flyingyuya/Sonic-Speed-Parallelism/docs/设计报告/README.md

# 设计报告

| 文件 | 说明 |
|---|---|
| **`REPORT.md`** | **Markdown 版**（1212 行）—— 便于在线阅读与版本 diff |
| **`main.tex`** | **LaTeX 版**（基于 `cumcmthesis.cls`）|
| **`main.pdf`** | **编译产物**（21 页）|

## 编译

```bash
cd docs/设计报告
xelatex main.tex && xelatex main.tex    # 两遍，第二遍生成目录
```

**依赖**：`cumcmthesis.cls` / `mcmicm_styles.tex` / `algorithm2e.sty` /
`matlab-prettifier.sty`（模板自带）+ XeLaTeX + Noto CJK 字体。

## 章节

| 章 | 内容 | 对应竞赛要求 |
|---|---|---|
| 1 | 选题背景与创新点（含 5 个创新点）| ● 选题背景与创新点 |
| 2 | 设计原理与功能框图（含 TikZ 架构图）| ● 设计原理与功能框图 |
| 3 | 软硬件划分依据与接口设计 | ● 软硬件划分依据与接口设计 |
| 4 | 优化过程与性能资源对比（5 阶段 ⨯ 对比表）| ● 优化过程，含前后对比表 |
| 5 | 大模型协作记录（提示词 / 回答 / 纠错轨迹 / 工作流）| ● 大模型协作记录 |
| 6 | 技能包提炼过程（来源 / 验证 / 边界）| ● 技能包的提炼过程 |
| 7 | 复现说明（7 步从零执行 + 验收清单 + FAQ）| ● 复现说明 |
| 附录 A/B | 关键指标汇总 / 与商业方案对比 | —— |
