flyingyuya/Sonic-Speed-Parallelism/docs/11-fft-design.md

# 11 FFT 设计（1024 点实数，存储式）

> **目标读者：第一次做 FFT 硬件实现的人。**
> 本文从 DFT 的定义讲起，一路推到可以写 RTL 的程度。
> 具体端口契约见 [10-top-design.md](10-top-design.md) §4.8。

---

## 1. 先破除一个误解：1024 点不会比 8 点长

网上大多数 FFT 教程（包括常见的 8 点 FFT 博客）写的是**全并行 / 流水线式**：
把每一级的蝶形单元全部"摆"出来，用 `generate` 批量例化。
那种写法下代码量随 N 爆炸。

**但 FFT 有另一种实现风格：存储式（memory-based / 时分复用）。**

| | 全并行 / 流水线式 | **存储式（本项目用）** |
| --- | --- | --- |
| 蝶形单元数 | `N/2 × log₂N` | **1 个** |
| 8 点需要 | 12 个蝶形 | **1 个** |
| 1024 点需要 | **5120 个蝶形** 😱 | **1 个** |
| 代码量 | 随 N 爆炸（必须 generate） | **几乎与 N 无关** |
| 每帧耗时 | N 拍 | `N/2 × log₂N` 拍 |
| 适用场景 | 极高吞吐（雷达 / 高速采集） | **低速场合（音频）** |

### 1.1 为什么我们能选存储式

```
输入采样率 48 kHz  @ clk_sys = 48 MHz  →  每 1000 个 clk 来一个样本
一帧 1024 点                            →  1,024,000 clk

存储式 FFT 需要：5120 蝶形 × ~4 clk     =  20,480 clk
                                        →  只占 1,024,000 的 2%
```

**只用 2% 的时间，没有任何理由把它并行化。**

> **结论：不需要 `generate`。一个蝶形单元就够了。**

### 1.2 这个余量是"结构性"的，不是刚好够

```
FFT 蝶形数      = (N/2) × log₂N
每个蝶形 4 clk  →  FFT 时间 = 2N·log₂N clk
帧长            = N × (clk_freq / fs) = N × 1000 clk
                                            ────────────────────────
占用率 = 2N·log₂N / (1000N) = log₂N / 500
```

**注意 `N` 被约掉了！**

| 点数 | log₂N | FFT 占用率 |
| --- | --- | --- |
| 1024 | 10 | **2.0%** |
| 2048 | 11 | 2.2% |
| 4096 | 12 | 2.4% |
| 16384 | 14 | 2.8% |

**点数翻 16 倍，占用率只从 2.0% 涨到 2.8%。**
所以以后想升级到 2048/4096 点，硬件只多几个 BRAM，时间上毫无压力
（真正要权衡的是帧延迟：2048 点 = 42.7 ms，频谱刷新会变慢）。

### 1.3 什么时候会不够

```
需要：2·log₂N clk 占满一个样本间隔
样本间隔 = clk_freq / fs
```

| 采样率 | 时钟 | 每样本 clk | FFT 需要 | 占用率 |
| --- | --- | --- | --- | --- |
| 48 kHz | 48 MHz | 1000 | 20 | **2%** ✅ |
| 192 kHz | 48 MHz | 250 | 20 | 8% ✅ |
| 1 MHz | 48 MHz | 48 | 20 | **42%** ⚠️ 开始紧张 |
| 1 MHz | 200 MHz | 200 | 20 | 10% ✅ |

音频范围内（≤192 kHz）绝对安全。

---

## 2. 蝶形结构详解（从 DFT 讲起）

### 2.1 DFT 在算什么

```
X[k] = Σ(n=0..N-1) x[n] · W_N^(nk)          k = 0 .. N-1
```

N=8 时展开：

```
X[0] = x[0]W⁰ + x[1]W⁰ + x[2]W⁰ + ... + x[7]W⁰
X[1] = x[0]W⁰ + x[1]W¹ + x[2]W² + ... + x[7]W⁷
X[2] = x[0]W⁰ + x[1]W² + x[2]W⁴ + ... + x[7]W¹⁴
...
```

**8 个输出 × 每个 8 项 = 64 次复数乘法。** N=1024 就是 100 万次。

FFT 要把它降到 `(N/2)·log₂N = 8×3 = 24` 次（N=1024 时是 5120 次）。

### 2.2 FFT 的核心思想：把输入拆成两半

把 `x[n]` 按**下标奇偶**拆开（这叫「按时域抽取」，DIT）：

```
X[k] = Σ x[n]W^(nk)
     = Σ_{n为偶数} x[n]W^(nk)  +  Σ_{n为奇数} x[n]W^(nk)

令 n = 2m（偶数项）和 n = 2m+1（奇数项），m = 0..N/2-1：

     = Σ_m x[2m]·W^(2mk)  +  Σ_m x[2m+1]·W^((2m+1)k)
```

**关键一步**：注意 `W_N^(2mk) = (W_N²)^(mk) = W_{N/2}^(mk)`

也就是说：偶数项的 `W^(2mk)` 正好是「N/2 点 DFT 的旋转因子」！

```
X[k] = E[k] + W_N^k · O[k]

其中 E[k] = N/2 点 DFT{ x[0], x[2], x[4], x[6] }      ← 偶数项
     O[k] = N/2 点 DFT{ x[1], x[3], x[5], x[7] }      ← 奇数项
```

**原来 8 点 DFT 变成了两个 4 点 DFT + 一点收尾工作。**

再用周期性 `E[k+N/2] = E[k]`、`O[k+N/2] = O[k]`：

```
X[k]     = E[k] + W^k · O[k]        k = 0 .. N/2-1
X[k+N/2] = E[k] - W^k · O[k]        ← 符号变减号
```

**这就是全部的秘密。** 一次复数乘 `W^k·O[k]` 同时算出两个输出。

### 2.3 蝶形单元 —— 名字的来历

上面两行画成图：

```
              ┌────────────────────●────── a + W·b
              │                    │
   a ─────────┤                    │
              │                    │
   b ─[×W]────┼────────────────────●────── a - W·b
```

**两根线进、两根线出，中间交叉 —— 形状像蝴蝶，所以叫「蝶形」。**

Verilog 写出来：

```verilog
t    = W * b;          // 唯一的复数乘法
out_a = a + t;         // 加
out_b = a - t;         // 减（省了一次乘法！）
```

> **这才是 FFT 快的地方**：一次乘法喂饱两个输出。
> 直接算 DFT 要 64 次乘法，蝶形网络只要 24 次。

### 2.4 8 点完整流程（三级）

把拆分**递归下去**：

```
8 点 ──▶ 两个 4 点 ──▶ 四个 2 点 ──▶ 八个 1 点（1 点 DFT 就是它自己）
```

一共 **log₂8 = 3 级**，每级 **N/2 = 4 个蝶形**，总共 12 个蝶形。

#### 输入顺序：位反转

拆分时偶数项在前、奇数项在后，再递归下去，最终地址 `a` 存的是样本 `bitrev(a)`：

```
地址 a :   0     1     2     3     4     5     6     7
内容   : x[0]  x[4]  x[2]  x[6]  x[1]  x[5]  x[3]  x[7]
```

**验证**：地址 1 存 x[4]，`bitrev(1) = 100b = 4` ✓

#### 三级蝶形的配对（按**内存地址**）

**第 0 级（half=1，地址相邻配对）**

| cnt | p | q | 旋转因子 | 实际取到的样本 |
| --- | --- | --- | --- | --- |
| 0 | 0 | 1 | `W⁰` | x[0], x[4] |
| 1 | 2 | 3 | `W⁰` | x[2], x[6] |
| 2 | 4 | 5 | `W⁰` | x[1], x[5] |
| 3 | 6 | 7 | `W⁰` | x[3], x[7] |

**第 1 级（half=2）**

| cnt | p | q | 旋转因子 | 实际取到的样本 |
| --- | --- | --- | --- | --- |
| 0 | 0 | 2 | `W⁰` | — |
| 1 | 1 | 3 | `W²` | — |
| 2 | 4 | 6 | `W⁰` | — |
| 3 | 5 | 7 | `W²` | — |

**第 2 级（half=4）**

| cnt | p | q | 旋转因子 | 实际取到的样本 |
| --- | --- | --- | --- | --- |
| 0 | 0 | 4 | `W⁰` | — |
| 1 | 1 | 5 | `W¹` | — |
| 2 | 2 | 6 | `W²` | — |
| 3 | 3 | 7 | `W³` | — |

**输出就是自然顺序 X[0]..X[7]** ✓

#### 两个规律

```
① 间距 half 每级翻倍：  1 → 2 → 4 → ...
② 每级内部配对是"周期性"的：
   第 0 级：4 组，每组 1 个蝶形，组内偏移 j 恒为 0
   第 1 级：2 组，每组 2 个蝶形，j = 0,1
   第 2 级：1 组，每组 4 个蝶形，j = 0,1,2,3
```

### 2.5 一个具体的数值例子

设 `x = [1, 0, 0, 0, 0, 0, 0, 0]`（单位冲激）。
冲激的 DFT 是**全 1**，所以正确答案已知。

**写进内存（位反转地址）**：x[0]=1 写到地址 0，其余为 0

```
地址:   0  1  2  3  4  5  6  7
内容:  [1, 0, 0, 0, 0, 0, 0, 0]
```

**第 0 级**（4 个蝶形，W⁰=1）：

```
(0,1): a=1, b=0 → t=0 → out: 1, 1
(2,3): a=0, b=0 → t=0 → out: 0, 0
(4,5): a=0, b=0 → t=0 → out: 0, 0
(6,7): a=0, b=0 → t=0 → out: 0, 0

内存: [1, 1, 0, 0, 0, 0, 0, 0]
```

**第 1 级**：

```
(0,2): a=1, b=0, W⁰ → out: 1, 1
(1,3): a=1, b=0, W² → out: 1, 1
(4,6): a=0, b=0, W⁰ → out: 0, 0
(5,7): a=0, b=0, W² → out: 0, 0

内存: [1, 1, 1, 1, 0, 0, 0, 0]
```

**第 2 级**：

```
(0,4): out: 1, 1
(1,5): out: 1, 1
(2,6): out: 1, 1
(3,7): out: 1, 1

内存: [1, 1, 1, 1, 1, 1, 1, 1]   ← X[k] 全 1 ✓
```

**几何直觉**：每一级都是「把已有的一坨复制一份、散开一点」。

#### 再看一个有旋转因子的蝶形

第 2 级、`cnt=1` 的蝶形 `(p=1, q=5)`，旋转因子 `W¹ = e^(-jπ/4) = 0.7071 - 0.7071j`。
假设此刻 `a = 2`（实数），`b = 1`（实数）：

```
t = W¹ · b = 0.7071 - 0.7071j

out_a = a + t = 2.7071 - 0.7071j
out_b = a - t = 1.2929 + 0.7071j
```

**旋转因子的作用就是"把 b 转个角度再缩放"**，然后加/减到 a 上。

### 2.6 用 Python 验证你的理解

**写 RTL 之前先跑这个**，跑通了说明结构彻底懂了，之后就是纯翻译工作：

```python
import numpy as np

N = 8
x = np.arange(N, dtype=complex)         # 随便给个输入

LOG2N = 3
# ---- 按位反转写内存 ----
mem = np.zeros(N, dtype=complex)
for n in range(N):
    a = int(format(n, f'0{LOG2N}b')[::-1], 2)
    mem[a] = x[n]
print("写入后的内存:", mem)

# ---- 逐级蝶形 ----
for s in range(LOG2N):
    half = 1 << s
    new = mem.copy()
    for cnt in range(N // 2):
        group = cnt // half
        j     = cnt %  half
        p = group * 2 * half + j
        q = p + half
        W = np.exp(-2j * np.pi * (j * (N // (2*half))) / N)
        t = W * mem[q]
        new[p] = mem[p] + t
        new[q] = mem[p] - t
    mem = new
    print(f"第 {s} 级后:", np.round(mem, 4))

print("numpy 结果 :", np.round(np.fft.fft(x), 4))
print("是否一致   :", np.allclose(mem, np.fft.fft(x)))
```

**这段代码就是以后 `fft_core` 的 Python 黄金模型的基础，保存下来。**

---

## 3. DIT vs DIF：两种对称的画法

FFT 有两种对称的分解方式，**图长得像但不一样**，看博客时容易搞混：

| | **DIT**（时域抽取，我们用的） | **DIF**（频域抽取） |
| --- | --- | --- |
| 输入顺序 | **位反转** | 自然顺序 |
| 输出顺序 | **自然顺序** | 位反转 |
| 第 0 级配对（地址） | `(0,1)(2,3)(4,5)(6,7)` | `(0,4)(1,5)(2,6)(3,7)` |
| 第 0 级旋转因子 | **全是 W⁰**（没有乘法！） | `W⁰ W¹ W² W³` |
| 最后一级旋转因子 | 全套 `W⁰..W^(N/2-1)` | 只有 `W⁰` |
| 蝶形形状 | 先乘再加/减 | 先加/减再乘 |

**两种图的第一级都可能出现「x(0) 和 x(4)」**：
- 如果是 DIT：因为左列第 1 行标的是 x(4)（位反转顺序）
- 如果是 DIF：因为左列是自然顺序，蝶形确实跨 N/2

### 怎么一眼分辨

```
第 0 级全是 W⁰（图上没有 ×W 标记）  →  DIT
第 0 级就有 ×W⁰ ×W¹ ×W² ×W³        →  DIF
```

### 我们为什么选 DIT

| | DIT | DIF |
| --- | --- | --- |
| 位反转放在哪 | **写地址**（免费：10 根线交叉） | 读地址 |
| 输出顺序 | **自然**（地址 0..511 就是 bin 0..511） | 位反转（要再排一次） |
| 加窗 | 写的时候顺手乘窗系数（按自然下标 n 索引窗 ROM） | 也一样 |

**DIT 让"输出自然顺序"和"写地址位反转"两件事都变简单。**
如果选 DIF，算幅度谱时就得按 `bitrev(k)` 去读 BRAM，频谱显示还得再排一遍 —— 白费功夫。

---

## 4. 地址发生器（核心）

### 4.1 直觉版本

```
第 s 级，间距 half = 2^s

蝶形编号 cnt 从 0 数到 N/2-1。把 cnt 拆成：
    ┌──────────────┬─────────┐
    │  组号 group   │ 组内偏移 j │
    └──────────────┴─────────┘
     高 (LOG2N-1-s) 位     低 s 位

第 group 组的蝴蝶对，起点 = group × 2×half
    p = group × 2×half + j
    q = p + half
```

用 N=8 验证（第 1 级，s=1, half=2）：

| cnt | 二进制 | group | j | p = group×4 + j | q = p+2 |
| --- | --- | --- | --- | --- | --- |
| 0 | `0` `0` | 0 | 0 | 0 | 2 |
| 1 | `0` `1` | 0 | 1 | 1 | 3 |
| 2 | `1` `0` | 1 | 0 | 4 | 6 |
| 3 | `1` `1` | 1 | 1 | 5 | 7 |

和 §2.4 的表完全一致 ✓

### 4.2 关键化简：「插 0 / 插 1」

把上面的公式翻译成**位操作**：

```
cnt   的布局:   [ 高 (LOG2N-1-s) 位 ][ 低 s 位 ]
                     ↓ 左移 1           ↓ 不变
p     的布局:   [ 高 (LOG2N-1-s) 位 ][0][ 低 s 位 ]
                                      ↑
                                 在第 s 位插入一个 0

q = p 的第 s 位置成 1
```

**逐项验证**：

| s | cnt | 推导 | p | q |
| --- | --- | --- | --- | --- |
| 0 | `11` | 低 0 位（空），第 0 位插 0，高位左移 | `110`=6 | `111`=7 |
| 1 | `01` | 低 1 位=`1`，第 1 位插 0，高位 `0` 左移→`0` | `001`=1 | `011`=3 |
| 2 | `01` | 低 2 位=`01`，第 2 位插 0，高位（空） | `001`=1 | `101`=5 |

**全部吻合。**

#### 为什么这个结论重要

它把「地址计算」从**除法取模**变成**位移和位或**：

```
除法取模版（硬件上要除法器，几十个 LUT/周期）：
    group = cnt / half
    j     = cnt % half
    p     = group * 2 * half + j

插 0 版（只要移位器和位或）：
    p = ((cnt >> s) << (s+1)) | (cnt & ((1<<s)-1))
    q = p | (1 << s)
```

**同样的结果，硬件代价差了几十倍。**

### 4.3 ⚠️ 地址 vs 样本下标（最容易混的地方）

这是**初学者最常卡住的一点**，单独强调。

```
样本下标 n :  x[0]  x[1]  x[2]  x[3]  x[4]  x[5]  x[6]  x[7]
              ↑ "第几个采样点"，由 ADC 时间顺序决定

内存地址 a :   0     1     2     3     4     5     6     7
              ↑ "存在 BRAM 的第几格"，由我们的写地址决定
```

**位反转就是把两者错位对应**：

```
写：  bram[ bitrev(n) ] <= x[n]

地址 a :   0     1     2     3     4     5     6     7
内容   : x[0]  x[4]  x[2]  x[6]  x[1]  x[5]  x[3]  x[7]
```

于是：

| §2.4/§4 的表（按**地址**） | 博客的图（按**样本名**） | 是同一件事吗 |
| --- | --- | --- |
| 蝶形 (地址 0, 地址 1) | x(0) 和 x(4) | ✅ 因为地址 1 存的是 x[4] |
| 蝶形 (地址 2, 地址 3) | x(2) 和 x(6) | ✅ |
| 蝶形 (地址 4, 地址 5) | x(1) 和 x(5) | ✅ |
| 蝶形 (地址 6, 地址 7) | x(3) 和 x(7) | ✅ |

> **「地址相邻」≠「样本相邻」。**
> 地址 0 和 1 相邻，但它们装的样本是 x[0] 和 x[4]，隔了 4 个。
>
> **这正是位反转的目的**：让「地址上相邻的两个格子」恰好装着「蝶形需要配对的那两个样本」，
> 于是地址生成退化成简单的位操作。

**一句话**：本文按「地址」写，博客按「样本名」标，说的是一回事。

### 4.4 Verilog 实现

```verilog
// s = 当前级数 0..LOG2N-1，cnt = 0..N/2-1
wire [LOG2N-1:0] cnt_x   = {1'b0, cnt};                      // 先扩位
wire [LOG2N-1:0] lo_mask = ({{(LOG2N-1){1'b0}},1'b1} << s) - 1'b1;

wire [LOG2N-1:0] p = ((cnt_x >> s) << (s + 1)) | (cnt_x & lo_mask);   // 插 0
wire [LOG2N-1:0] q = p | ({{(LOG2N-1){1'b0}},1'b1} << s);             // 插 1

// 旋转因子索引 = j × N/(2·half) = j << (LOG2N-1-s)
wire [LOG2N-2:0] tw_idx = (cnt & lo_mask[LOG2N-2:0]) << (LOG2N - 1 - s);
```

可变移位（`<<` 的右操作数是变量）综合器会自动生成**桶形移位器**。
**整个地址发生器不到 10 行。**

### 4.5 手工验算（N=8）

N=8，LOG2N=3，N/2=4，cnt = 0..3。

| s | half | cnt | j | p | q | tw_idx |
| --- | --- | --- | --- | --- | --- | --- |
| 0 | 1 | 0 | 0 | 000 | 001 | 0 |
| 0 | 1 | 1 | 0 | 010 | 011 | 0 |
| 0 | 1 | 2 | 0 | 100 | 101 | 0 |
| 0 | 1 | 3 | 0 | 110 | 111 | 0 |
| 1 | 2 | 0 | 0 | 000 | 010 | 0 |
| 1 | 2 | 1 | 1 | 001 | 011 | 2 |
| 1 | 2 | 2 | 0 | 100 | 110 | 0 |
| 1 | 2 | 3 | 1 | 101 | 111 | 2 |
| 2 | 4 | 0 | 0 | 000 | 100 | 0 |
| 2 | 4 | 1 | 1 | 001 | 101 | 1 |
| 2 | 4 | 2 | 2 | 010 | 110 | 2 |
| 2 | 4 | 3 | 3 | 011 | 111 | 3 |

对照 §2.4 的三级表 —— **完全一致** ✓

### 4.6 旋转因子索引的来历

回到 §2.2 的公式：`X[k] = E[k] + W_N^k · O[k]`，用的是 **N 点**旋转因子。
递归到 N/2 点时用 N/2 点的旋转因子，那个在上层已经用过……

**结论（可以直接记）**：第 s 级、组内偏移为 j 的蝶形，用的旋转因子是：

```
tw = W_N^(j · N/(2·half)) = W_N^(j · 2^(LOG2N-1-s))
```

即 **`tw_idx = j << (LOG2N-1-s)`**

| s | half | j 范围 | 移位量 LOG2N-1-s | tw_idx |
| --- | --- | --- | --- | --- |
| 0 | 1 | 0 | 2 | 0 |
| 1 | 2 | 0,1 | 1 | 0, 2 |
| 2 | 4 | 0..3 | 0 | 0,1,2,3 |

对照 §2.4 —— 完全一致 ✓

**直觉解释**：每往下一级，旋转因子的「步进」减半，
这就是移位量 `LOG2N-1-s` 的来历。

---

## 5. 旋转因子 ROM

### 5.1 数值

```
W_N^k = cos(2πk/N) − j·sin(2πk/N)      k = 0 .. N/2−1 = 0 .. 511
```

只存 **512 项**，因为 `W^(k+N/2) = −W^k`（后半圈在蝶形里取负）。

### 5.2 生成脚本

见 `scripts/golden/gen_fft_twiddle.py`，产物 `rtl/fft/fft_twiddle_rom.v`。

格式：Q1.15，字宽 32bit = `{imag[15:0], real[15:0]}`。

```python
for k in range(512):
    ang = 2*math.pi*k/N
    re = quant(math.cos(ang))          # Q1.15
    im = quant(-math.sin(ang))         # ← 负号！正变换是 e^{-j...}
    word = (im & 0xFFFF) << 16 | (re & 0xFFFF)
```

**两个坑**：

| 坑 | 说明 |
| --- | --- |
| **`-sin` 写成 `+sin`** | 等于做了共轭，频谱会整体镜像翻转。症状：1 kHz 正弦的峰值跑到 bin 1003 而不是 bin 21 |
| **k=0 不钳位** | `cos(0)=1.0` 量化后是 **32768**，超出 Q1.15 上限 32767，会回绕成负数 |

### 5.3 已验证结果

| 检查项 | 结果 |
| --- | --- |
| 幅度 `abs(re²+im²-2³⁰)/2³⁰` | 最大 6.1e-05 |
| 关键点（k=0/64/128/256） | 与手算一致 |
| 共轭对称性 | 通过 |
| **独立交叉验证**（用量化表跑直接 DFT vs `numpy.fft`） | 全谱最大误差 **2.9e-06** |
| Vivado 综合 | **195 LUT / 0 BRAM**，零告警 |

> **独立验证的方法值得记住**：不要用 `cos/sin` 公式去"验证"用 `cos/sin` 生成的表（循环论证）。
> 而是把量化后的值当成真表，用它做一次 O(N²) 直接 DFT，再和 `numpy.fft` 比 ——
> **两条完全不同的算法路径**。

### 5.4 综合结果是 LUT ROM 而不是 BRAM

**195 LUT / 0 BRAM** —— Vivado 把它实现成**分布式 LUT ROM**（组合读取、零延迟）。

⚠️ **这是一个需要留意的点**：查找延迟要算进时序路径。
第 3 步做蝶形单元时，如果发现「ROM 查找 + 复数乘法」这条路径太长，
可以给 ROM 输出加一级寄存器 —— **看综合报告再决定**。

### 5.5 可选优化（先不做）

利用 `W^(N/2-k) = -j·conj(W^k)` 可压到 **N/4+1 = 257** 项，省一半 ROM，
但多一层组合逻辑和几个 mux。**第一次做先用完整 512 项。**

---

## 6. 数据格式与缩放

### 6.1 每级右移 1 位（÷2）

蝶形的加减会让幅度翻倍，10 级最多增长 `2^10 = 1024`。**必须缩放。**

标准做法：**每级算完右移 1 位**，10 级共 ÷1024 = ÷N。

### 6.2 为什么 ÷N 不是"浪费精度"

| 输入 | FFT 后峰值 bin | ÷N 之后 | 放进 Q1.15 |
| --- | --- | --- | --- |
| 满量程正弦 A = 1.0 | 512 × 1.0 = 512 | **0.5** | ✅ 正好不溢出 |
| 实际音频 A = 0.1 | 512 × 0.1 = 51.2 | **0.05** | Q1.15 = 1638，约 11 bit 有效 |

**÷N 恰好把"满量程正弦"映射到 0.5** —— 这是设计好的，不是浪费。

### 6.3 位宽

```
输入：                16 bit  (Q1.15)
蝶形加减临时增长：      +1 bit
复数乘：16×16 = 32 bit 乘积，两项相加 33 bit，>>15 归一化回 ~18 bit
内部实/虚部位宽：      24 bit   ← 绰绰有余
```

**每级缩放后写回 BRAM 时做饱和**（防止异常输入导致回绕）。

### 6.4 加窗

第一版**不做**。Hann 窗能让频谱更干净（减少泄漏），但要在写入时乘一个窗系数 ROM。
等频谱显示出来觉得难看再加。

---

## 7. 缓冲、FIFO 与状态机

### 7.1 FFT 是「块变换」，**必须先攒满整帧**

从数学上看：`X[k] = Σ(n=0..N-1) x[n]·W^(nk)` ——
**每一个输出频点都用到了全部 N 个输入样本。**

看第 0 级的第一个蝶形需要哪两个数据：

```
写地址是位反转的：地址 a 存样本 bitrev(a)
  地址 0 ← 样本 0
  地址 1 ← 样本 512      ← 注意！
第 0 级蝶形是 (地址0, 地址1)、(地址2, 地址3)...（只差最低位）
→ 第一个蝶形就要用【样本 0】和【样本 512】
→ 样本 512 要等到第 512 个采样点，半帧之后才到
```

**所以不存在"边收边算"。必须等 1024 个样本全部写进 BRAM 才能开始。**

> 理论上可以用 **streaming / pipelined FFT** 实现连续处理，但那要 N 个复数延迟单元，
> 复杂度高好几倍。**我们没必要。**

### 7.2 一帧的完整时间线

设 `t = 0` 为第 N 帧的样本 0 到达的时刻。样本 n 在 `t = 1000n` clk 到达。

```
t=0            ┌─ 写帧阶段 ─────────────────────────────────────────┐
               │ 每来一个样本：ADC→FIFO→(FSM 立刻弹出)→BRAM[bitrev(n)]  │
               │ FIFO 深度始终在 0~1 徘徊（进出平衡）                  │
t=1,023,000    └─ 样本 1023 写入，n=1024 → 切 FFT ──────────────────┘
                    ↓
t=1,023,000    ┌─ FFT 阶段（20,480 clk）─┐
               │ BRAM 被 FFT 独占          │  这期间到达样本 1024~1043
               │ FSM 停止写 → FIFO 涨到 20 │  （20 个，全进 FIFO 排队）
t=1,043,480    └──────────────────────────┘
                    ↓
t=1,043,480    ┌─ 输出阶段（512 读，约 1,024 clk）─┐
               │ BRAM 仍被占用（读 512 个频点）      │  样本 1044 到达
               │ FIFO 涨到 21                       │
t=1,044,504    └────────────────────────────────────┘
                    ↓
t=1,044,504    ┌─ 回到写帧阶段 ─────────────────────────────────┐
               │ FSM 立刻连续弹出 FIFO 里的 21 个：               │
               │   t=1,044,504 ~ 1,044,525（21 clk）            │
               │   样本 1024~1044 写入 BRAM[bitrev(0..20)]      │
               │   → 这 21 个就是第 N+1 帧的前 21 个样本 ✓        │
               │ FIFO 排空后等下一个样本：                        │
               │   样本 1045 在 t=1,045,000 到（还有 475 clk 余量）│
t=2,047,000    └─ 第 N+1 帧凑满 1024 个 → 切 FFT ────────────────┘
```

**验证周期**：`2,047,000 − 1,023,000 = 1,024,000 clk` = 1024 × 1000 **✅ 完全对齐，不丢样本、不漂移**。

### 7.3 ⚠️ FIFO 是**唯一入口**，不存在"两路"

初学时容易画成「ADC 直接写 BRAM，FIFO 是旁路」，那是错的：

```
                        ┌──────────────────────┐
   ADC ───(每1000clk)──▶│   audio_fifo (深度64) │──▶ 写帧FSM ──▶ BRAM
                        │   【唯一入口】         │    (按需弹出)
                        └──────────────────────┘
                                   ▲
                       写帧FSM 停顿时自然积压
                       （FFT/输出期间），恢复后快速排空
```

**所有样本都先进 FIFO，再由写帧 FSM 从 FIFO 里取出来写 BRAM。**
不存在"积压的 20 个"和"新来的 1000 个"两条路 —— 它们在同一条队列里排队。

写帧 FSM 的全部逻辑：

```verilog
// 写帧状态
if (bram_free && !fifo_empty) begin
    bram[bitrev(n)] <= fifo_dout;
    fifo_rd         <= 1'b1;
    n               <= n + 1'b1;
    if (n == 10'd1023) state <= FFT;   // 凑满 1024 个，切 FFT
end
```

**就这 5 行。** 没有任何"区分积压和新来"的特殊处理 —— FIFO 天然把这些摊平了。

- **写帧/空闲期间**：FIFO 里最多 0~1 个，`fifo_empty` 大部分时间是 1
- **FFT 结束后**：FIFO 里有 21 个，FSM 连续弹 21 拍排空

**同一段逻辑，自动适应两种情况。**

### 7.4 为什么不会越积越多

```
每 1,024,000 clk 内 FSM 需要占用 BRAM 的时间：
    1024 次写       =  1,024 clk
    FFT 5120 蝶形   = 20,480 clk
    输出 512 频点    =    512 clk
                    ───────────
                      22,016 clk     ←  只占 2.1%

最大积压量 = (FFT + 输出时间) / 样本间隔
           = 22,016 / 1000
           ≈ 22 个

→ FIFO 深度 64 有 3 倍余量 ✓
→ 排空只需 22 clk，而下一帧有 1,024,000 clk ✓
```

**FIFO 每帧涨到 22，然后立刻排空回 0，周期性重复，永远不溢出。**

> **输出阶段也占 BRAM**（要读 512 个频点算幅度），别只留 FFT 的 20,480 clk。

### 7.5 防御性设计

理论上不会溢出，但还是要有：

```verilog
if (fifo_full) drop_cnt <= drop_cnt + 1'b1;   // 丢一个样本，系统不崩
```

并通过 UART 报出去 —— 一旦非零就说明设计有问题。
**这类「理论上不会发生」的计数器在上板调试时价值极高。** 类似的还有：

| 计数器 | 监控什么 |
| --- | --- |
| `drop_cnt` | FIFO 溢出（丢样本） |
| `fft_timeout` | FFT 超过预期周期数（状态机卡死） |
| `frame_err` | 帧计数不连续 |

### 7.6 状态机（只有三个状态）

```
                    ┌──────────────────────────────┐
                    ▼                              │
   ┌────────┐   写满 1024   ┌────────┐   10 级算完  ┌────────┐
   │  IDLE  │ ────────────▶ │  RUN   │ ──────────▶ │  OUT   │
   │ 写帧   │               │ 蝶形   │             │ 算幅度谱│
   └────────┘               └────────┘             └────────┘
        ▲                                                │
        └────────────────────────────────────────────────┘
```

- **IDLE**：从 FIFO 取样本，写进 BRAM 的 `bitrev(n)` 地址；`n` 到 1024 后跳 RUN
- **RUN**：`s` 从 0 到 LOG2N-1，每个 `s` 里 `cnt` 从 0 到 N/2-1，做蝶形
- **OUT**：按自然顺序读 0..N/2-1 号地址，算 `sqrt(re²+im²)` 输出

**级数和蝶形计数都是简单的 +1 计数器。**

---

## 8. 硬件结构

```
   写地址(位反转)                          ┌──────────────┐
x[n] ─────▶ ┌────────────────────┐         │   蝶形单元    │
            │   数据 BRAM         │◀───────▶│ 1 个复数乘法  │
            │   1024 × (24+24)bit │ 读/写   │ + 2 个复数加减│
            │   in-place          │         └──────┬───────┘
            └────────────────────┘                │
                     ▲                            │ 写回
                ┌────┴──────┐                     │
                │  地址发生器 │◀────────────────────┘
                │  stage: 0~9│
                │  cnt: 0~511│
                └────┬───────┘
                     │ tw_idx
                ┌────▼──────────┐
                │ 旋转因子 ROM   │
                │ 512 × (16+16) │
                └───────────────┘
```

**"in-place（原地运算）"是存储式 FFT 的精髓**：
数据一直待在 BRAM 里，每算完一个蝶形就把结果写回原地址。
整次 FFT 只用了这一块 BRAM，不需要额外的中间存储。

### 资源估算与实测

设计目标：

```
实部：1024 × 24 bit = 24 kbit
虚部：1024 × 24 bit = 24 kbit
```

7 系列一个 BRAM36 = 36 kbit，真双口模式下有 2 个独立端口，
所以实部、虚部各占 1 个 BRAM36 → **共 2 个**。

> 真双口的意义：一个蝶形要**同时读 p 和 q 两个地址**，
> 算完又要**同时写回 p 和 q**。真双口的两个端口正好一人一个。

**实测资源（Vivado，xc7a100tfgg484-2，`fft_core` 综合后）：**

| 资源 | 占用 | 总量 | 占比 |
| --- | --- | --- | --- |
| Slice LUTs | **1004** | 63400 | 1.58% |
| Slice Registers | **126** | 126800 | 0.10% |
| LUT as Distributed RAM | **32** | 19000 | 0.17% |

> ⚠️ 上面数字是 2025-09 修正后的实测值。**初版是 1560 LUT / 1630 FF** ——
> 其中 1536 个触发器来自内部输入 FIFO，它**因为带异步复位才无法被推断成 RAM**。
> 改成同步复位后 FIFO 变成 32 个 LUT 的分布式 RAM，触发器只剩 126 个。
> 详见 §14 坑 4。
| **Block RAM (RAMB36E1)** | **2** | 135 | 1.48% |
| **DSP48E1** | **4** | 240 | 1.67% |

各子模块单独综合：

| 模块 | LUT | DSP | BRAM |
| --- | --- | --- | --- |
| `fft_twiddle_rom` | 195 | 0 | 0（推断成分布式 LUT ROM） |
| `fft_addr_gen` | 35 | 0 | 0 |
| `fft_butterfly` | 472 | 4 | 0 |
| `fft_core`（含上面三个 + BRAM + FIFO） | **1004** | **4** | **2** |

### 单蝶形需要几个时钟

真双口每周期每端口只能做 1 次访问（读或写）：

```
周期 1：端口A 读 x[p]，端口B 读 x[q]
周期 2：复数乘法（可流水）
周期 3：端口A 写 x[p]'，端口B 写 x[q]'
```

约 **3~4 个周期/蝶形**。5120 蝶形 × 4 = **20,480 clk ≈ 0.43 ms**。

---

## 9. 模块划分与端口

```verilog
// 1) 旋转因子表（Python 生成，不要手改）        ✅ 已完成
module fft_twiddle_rom (
    input  wire [8:0]  addr,      // 0 ~ 511
    output reg  [31:0] dout       // {imag[15:0], real[15:0]}
);

// 2) 地址发生器（纯组合，参数化便于用小点数自检）
module fft_addr_gen #(parameter integer LOG2N = 10) (
    input  wire [LOG2N-2:0]  cnt,         // 0 .. N/2-1
    input  wire [3:0]        stage,       // 0 .. LOG2N-1
    output wire [LOG2N-1:0]  p,           // 蝶形第一个点
    output wire [LOG2N-1:0]  q,           // 蝶形第二个点
    output wire [LOG2N-2:0]  tw_idx       // 旋转因子索引
);

// 3) 蝶形单元（1 个复数乘 + 2 个复数加减，带缩放）
module fft_butterfly #(parameter DW = 24, TW = 16) (
    input  wire                 clk, rst_n,
    input  wire                 valid_in,
    input  wire signed [DW-1:0] ar, ai,     // x[p]
    input  wire signed [DW-1:0] br, bi,     // x[q]
    input  wire signed [TW-1:0] wr, wi,     // 旋转因子
    output reg                  valid_out,
    output reg  signed [DW-1:0] pr, pi,     // x[p]'
    output reg  signed [DW-1:0] qr, qi      // x[q]'
);

// 4) 顶层                                          ✅ 已完成
module fft_core #(
    parameter integer N          = 1024,
    parameter integer LOG2N      = 10,
    parameter integer DW         = 24,       // 数据 Q1.23
    parameter integer TW         = 16,       // 旋转因子 Q1.15
    parameter integer FIFO_DEPTH = 64
) (
    input  wire                  clk, rst_n, // clk_sys = 48 MHz
    input  wire signed [DW-1:0]  x_in,       // 实数样本
    input  wire                  x_valid,
    output reg  [LOG2N-2:0]      y_index,    // 0 ~ N/2-1
    output reg  [DW:0]           y_mag,      // 幅度（近似，见 §7.5）
    output reg                   y_valid,
    output wire                  busy,       // 1 = 正在算蝶形
    output reg  [7:0]            drop_cnt    // FIFO 溢出计数（应恒为 0）
);
```

**幅度输出用的是近似而不是开方**：

```
|X| ≈ max(|re|,|im|) + 0.4375 × min(|re|,|im|)
```

`0.4375 = 1/2 - 1/16`，两次移位一个减法就够，比 CORDIC 省几十倍资源。
最大误差实测是 **+9.1%（≈ +0.75 dB）**，而且**永远偏高**（不会偏低）。

> ⚠️ 这条数字 2025-09 更正过。原来写的"±4.3%"是错的 ——
> 当时只凭印象，没有真正穷举。写 `tb_polar_map` 时对每个像素和 `$sqrt` 逐点比对，
> 才量出真实最大值出现在 `min/max ≈ 0.5` 处，是 **+9.1%**。
>
> 对频谱柱状图仍然完全够用（立柱还要过 dB 压缩，0.75 dB 在 96 dB 满量程里
> 不到 1 个像素）；但**画圆时不能用** —— 半径误差会随角度变化，
> 看起来像歪掉的花瓣，所以 `polar_map.v` 改用精确的平方比较。

---

## 10. 验证方法（关键：别自己算）

**黄金模型用 `numpy.fft.rfft`，不要手写 DFT。**
自己写一个 DFT 当参考，如果 DFT 写错了，两边一起错就永远发现不了。

```python
import numpy as np
X = np.fft.rfft(x)          # 512 个复数点
ref = np.abs(X)             # 幅度谱
```

### 三步验证

| 步骤 | 方法 | 判据 |
| --- | --- | --- |
| 1 | 定点模型 vs 浮点模型 | 幅度误差 < 1% |
| 2 | RTL vs Python 定点模型 | **逐位一致**（`!==`） |
| 3 | 单频点测试 | 输入 1 kHz 正弦，最大值应在 bin `1000×1024/48000 ≈ 21` |

第 3 步最直观 —— **输入一个已知频率的正弦，看峰值落在哪个 bin 上。**

### 测试激励

| 测试 | 输入 | 预期 |
| --- | --- | --- |
| 冲激 | `x[0]=max, 其余 0` | 所有 bin 幅度相等（平坦谱） |
| 单音 1 kHz | 正弦 | 峰值在 bin 21 + 镜像 bin 1003 |
| 双音 1k + 3k | 两个正弦叠加 | 峰值在 bin 21/1003 和 bin 64/960 |
| 直流 | 全 1.0 | 只有 bin 0 有值 |
| 满量程 | 全 max | 检查饱和分支 |

> **实信号有 `|X[k]| = |X[N-k]|`** —— 所以会看到成对的镜像峰，这是正常的。

### 子模块的独立验证（本项目实际采用的做法）

| 模块 | 验证方法 | 独立性体现在哪 |
| --- | --- | --- |
| `fft_twiddle_rom` | 幅度/对称性自检 + **用量化表跑 O(N²) 直接 DFT 与 `numpy.fft` 对比** | 不复用 `cos/sin` 公式，走"直接 DFT"这条完全不同的路径 |
| `fft_addr_gen` | **穷举所有 (stage, cnt)**，参考值用「除法取模」朴素算法 | RTL 走位操作（插 0/插 1），TB 走除法取模 |
| `fft_butterfly` | Python 定点模型生成向量 + **逐位对拍** | 模型在 Python 里用任意精度整数重写一遍 |
| `fft_core` | 4 组端到端输入，输出与 `fft_core_model()` **逐位对拍** | 模型用朴素地址算法 + 从 ROM 读的旋转因子 |

### 一个必须掌握的技巧：区分"饱和"与"算错"

蝶形的向量里故意灌了会触发饱和的输入（例如 `W = -1-j` 时 `t = 2j` 超出 Q1.23）。
这时定点结果和纯浮点参考差异很大（能到 0.5），**但那是预期行为，不是 bug**。

做法是让定点模型返回一个"是否饱和"的标志：

```python
pr, pi, qr, qi, satd = butterfly_ex(...)
if not satd:
    # 只有没饱和的点才和纯浮点比对
    ...
```

**分层检查**：

| 检查 | 覆盖什么 |
| --- | --- |
| 浮点量级比对（**排除饱和点**） | 验证算术逻辑本身 |
| **逐位对拍（全部点）** | 验证包括饱和在内的完整行为 |

如果不做这个区分，浮点自检会报"误差 0.5"，让人误以为模型错了，
反而会去"修"一个本来正确的设计。

### 黄金模型从 ROM 读旋转因子，而不是重算

```python
def load_twiddle_from_rom(path="rtl/fft/fft_twiddle_rom.v"):
    ...  # 解析生成的 Verilog case 语句
```

**为什么**：ROM 已经独立验证过了（见第 1 步）,
所以 `fft_core` 的测试应该聚焦在**核心逻辑**上，不必重复验证 ROM。
而且这样能保证模型和硬件用的是**同一份数据**。

---

## 11. 实施记录（四步全部完成 ✅）

> 每一步都**独立验证通过之后**才做下一步。实测数据如下。

### 第 1 步 `fft_twiddle_rom.v` ✅

```
生成        : 512 项 / 38 KB，由 scripts/golden/gen_fft_twiddle.py 自动生成
脚本自检    : 幅度误差最大 6.1e-05；关键点(k=0/64/128/256)与手算一致；共轭对称性通过
独立交叉验证: 用量化表跑直接 DFT vs numpy.fft -> 全谱最大误差 2.9e-06
综合        : 195 LUT / 0 BRAM（推断成分布式 LUT ROM）
```

**独立交叉验证的方法值得记住**：不要用 `cos/sin` 去"验证"用 `cos/sin` 生成的表
（那是循环论证）。而是把量化后的值当真表，做一次 O(N²) 直接 DFT，
再和 `numpy.fft` 比 —— **两条完全不同的算法路径**。

### 第 2 步 `fft_addr_gen.v` ✅

```
穷举验证    : LOG2N=3   12 组 + LOG2N=10 5120 组 = 5132 组，0 处不符
参考模型    : 用【除法取模】朴素算法（与 RTL 的位操作路径完全独立）
结构断言    : q 与 p 必须只差第 stage 位 -> 0 处不符
综合        : 35 LUT / 0 寄存器（桶形移位器）
```

### 第 3 步 `fft_butterfly.v` ✅

```
向量        : 621 组（随机 500 + 小信号 100 + 边界/特殊旋转因子 21）
浮点自检    : 排除 37 组饱和点后，584 组最大误差 1.192e-07（= 恰好 1 LSB）
逐位对拍    : 621 组 0 不符
综合        : 472 LUT / 4 DSP48E1 / 0 寄存器
组合路径    : 8.767 ns，16 级逻辑
```

### 第 4 步 `fft_core.v` ✅

```
端到端验证  : 4 组测试 x 512 频点 = 2048 个输出【全部逐位一致】
              测试集：冲激 / 单音 1kHz / 双音 1k+3k / 小信号(0.05 满量程) 1kHz
输出顺序    : 严格 0->511 递增，0 错误
FIFO 丢样本 : 0
实测耗时    : 每组 10756 拍（RUN 10240 + OUT 513）= 一帧的 1.05%
综合        : 1004 LUT / 126 FF / 32 LUTRAM / 2 BRAM36 / 4 DSP48E1
时序        : WNS +2.541 ns / WHS +0.063 ns @ 20.833 ns（48 MHz）  MET
```

**时序细节**：

```
关键路径 : BRAM 读（mem_re CLK->DO）-> 蝶形 -> BRAM 写数据（mem_im DIBDI）
延迟     : 17.830 ns（逻辑 11.19 + 布线 6.64，布线占 37%）
逻辑级数 : 32（CARRY4=26 + DSP48E1=1 + LUT 若干）
```

> **约 12% 余量**。中间出现过 0.621 ns 的险情，根因是旋转因子 ROM 离 DSP48
> 太远 —— 单根 net 的**布线**延迟就吃掉 9.6 ns。在 ROM 和 DSP 之间插一级
> 寄存器后回到 2.541 ns，而且功能逐位不变（详见 §14 坑 5）。
>
> 若还需更多余量，递进方案：
> ① 给 BRAM 输出加一级寄存器（2 拍/蝶形 → 3 拍，占用率 1.05% → 1.6%）；
> ② 蝶形中间插流水线（4 拍/蝶形，路径砍到 ~10 ns）；
> ③ 加位置约束让 BRAM 和 DSP 靠近。
>
> **现在不做** —— 时序已收敛，而 FFT 只占 1% 帧时间，做快没有任何收益。

---

## 12. 与全并行版本的取舍（什么时候才该用 generate）

| 场景 | 选择 |
| --- | --- |
| 音频（48 kHz） | **存储式**（本项目） |
| 视频像素级处理 | 可能全并行 |
| 雷达 / 高速采集（>10 MHz） | 全并行 + 流水线 |
| 需要单周期出结果 | 全并行 |

**判断标准**：`存储式所需时钟数` 是否远小于 `帧周期`？
是 → 存储式。我们差 50 倍，毫无悬念。

---

## 13. 代码量实测

| 模块 | 行数 | 说明 |
| --- | --- | --- |
| `fft_twiddle_rom.v` | 550 | 全是自动生成的 `case` 常量 |
| `fft_addr_gen.v` | 72 | 纯组合，核心只有 4 行表达式 |
| `fft_butterfly.v` | 153 | 复数乘 + 加减 + 缩放 + 饱和 |
| `fft_core.v` | 335 | BRAM + FIFO + 三状态机 + 幅度近似 |
| **RTL 合计** | **1110** | 其中 550 行是自动生成，**手写约 560 行** |

辅助代码（不在综合路径上）：

| 文件 | 行数 | 用途 |
| --- | --- | --- |
| `scripts/golden/fft_dsp.py` | 178 | Python 定点黄金模型 |
| `scripts/golden/gen_fft_twiddle.py` | 221 | 生成旋转因子 ROM |
| `scripts/golden/gen_fft_butterfly_vec.py` | 136 | 生成蝶形测试向量 |
| `scripts/golden/gen_fft_core_vec.py` | 100 | 生成端到端测试向量 |
| `sim/tb/tb_fft_addr_gen.v` | 151 | 穷举自检 |
| `sim/tb/tb_fft_butterfly.v` | 89 | 逐位对拍 |
| `sim/tb/tb_fft_core.v` | 166 | 端到端对拍 |

> **验证代码（996 行）比 RTL 手写部分（560 行）还多。**
> 这不是浪费 —— 正因为有它，才抓到了下面那两个仿真很难发现的坑。

---

## 14. 实施踩坑记录

### 坑 1：`1'sd1` 不是 1，是 −1

蝶形的"÷2 四舍五入"里写了：

```verilog
wire signed [SW-1:0] sum_re_r = sum_re + 1'sd1;    // ✗
```

对拍结果：**621 组向量全部偏 −1 LSB**。

原因：`1'sd1` 是**1 位有符号数**，取值只能是 `0` 或 `1'b1 = -1`。
所以 `+ 1'sd1` 实际是 `- 1`。

**正确写法**：

```verilog
localparam signed [SW-1:0] ONE_SW = {{(SW-1){1'b0}}, 1'b1};
wire signed [SW-1:0] sum_re_r = sum_re + ONE_SW;
```

**相邻的第二个坑**：也不能图省事写 `1'b1` ——
无符号常量会让整个表达式变成无符号，后面的 `>>>` 就退化成**逻辑右移**，负数全错。

> **规则**：做有符号运算时，**所有参与运算的常量都必须显式声明为 signed 且位宽正确**。
>
> **这个 bug 完美展示了逐位对拍的价值**：只差 1 LSB，
> 肉眼看波形、或者和浮点比对（阈值判据）都发现不了。

### 坑 2：同一个 `always` 块里，后面的赋值赢

OUT 状态第一版：

```verilog
if (out_cnt != 0) begin
    y_valid <= 1'b1;        // 先置 1
end
...
if (out_cnt == HALF) begin
    y_valid <= 1'b0;        // ✗ 又置 0，把上面覆盖了
    state   <= S_IDLE;
end
```

结果：**只输出 511 个频点**，最后一个被吃掉；而且前 511 个全部正确。
"就差最后一个"是最容易被忽略的一类 bug。

> **Verilog 规则**：同一个 `always` 块内对同一变量多次非阻塞赋值，**最后一次生效**。
> 写 FSM 时特别容易踩。

### 坑 3：两个端口写进同一个 `always` 块 → BRAM 推断失败

第一版把双口的读写混在一起：

```verilog
always @(posedge clk) begin
    if (we_a) mem_re[addr_a] <= din_a;
    dout_a <= mem_re[addr_a];
    if (we_b) mem_re[addr_b] <= din_b;
    dout_b <= mem_re[addr_b];
end
```

综合结果：

```
Slice Registers : 50883   ← 40% 的触发器！
Block RAM Tile  : 0       ← BRAM 一个都没用上
```

**1024×24×2 = 49152 bit 全部变成了触发器。**

改成**每个端口一个独立 `always` 块** + 显式 `ram_style`：

```verilog
(* ram_style = "block" *) reg signed [DW-1:0] mem_re [0:N-1];

always @(posedge clk) begin
    if (we_a) mem_re[bram_addr_a] <= din_re_a;
    dout_re_a <= mem_re[bram_addr_a];
end
// 端口 B 单独一个 always 块
always @(posedge clk) begin
    if (we_b) mem_re[bram_addr_b] <= din_re_b;
    dout_re_b <= mem_re[bram_addr_b];
end
```

结果：**50883 FF → 1630 FF，BRAM 0 → 2**。

> **教训**：仿真完全发现不了这个 bug（功能是对的，只是实现成了天价触发器）。
> **写完 RTL 一定要看综合资源报告，确认数字对得上设计意图。**
> 如果没看直接上板，会发现"功能正常但资源爆了、时序也不行了"。

### 坑 4：带**异步复位**的存储器，永远推断不出 RAM

`fft_core` 内部有个 64 深 x 24 位的输入 FIFO。第一版综合结果：

```
Slice Registers : 1630      <- 一个 64x24 的 FIFO 吃掉了 1536 个触发器！
LUT as Memory   : 0
```

`1536 = 64 x 24` —— FIFO 完全变成了触发器阵列。

**根因**：FIFO 原来写的是

```verilog
always @(posedge clk or negedge rst_n) begin   // <-- 异步复位
```

综合工具推断 RAM 有一条硬性前提：**存储体的复位必须是同步的**。
带异步复位的寄存器阵列只能老老实实映射成触发器（每个 FF 都带 CLR 脚），
因为 RAM 原语里根本没有"异步清零整块存储体"这个功能。

```verilog
always @(posedge clk) begin                     // 同步复位
    if (!rst_n) ... else ...
```

改完之后：

| | 改之前 | 改之后 |
| --- | --- | --- |
| Slice Registers | 1630 | **126** |
| Slice LUTs | 1560 | **1004** |
| LUT as Distributed RAM | 0 | **32** |

> **教训**：这个 bug 仿真一个字都不会报，功能完全正确。
> 只有打开综合资源报告，看到"64x24 的 FIFO 花掉 1536 个触发器"才发现。
> **写完 RTL 必须核对资源数字和设计意图是否对得上**（坑 3 的同类问题）。

### 坑 5：关键路径上 **9.6 ns 全花在布线**，逻辑只占 10.1 ns

把上面那个 FIFO 改成分布式 RAM 之后，时序反而从 +3.310 ns 掉到 +0.621 ns。
看关键路径：

```
Source      : cnt_reg[0]/C
Destination : mem_re_reg/DIBDI[1]     (BRAM 写数据)
Data Path   : 19.717 ns = 逻辑 10.130 ns (51%) + 布线 9.587 ns (49%)
Logic Levels: 38  (CARRY4=27 DSP48E1=1 LUT2=2 LUT3=3 LUT4=1 LUT5=2 LUT6=2)
```

逐级展开，找到真正的元凶：

```
net (fo=2, routed)  0.737  9.620  u_bf/wr[12]     <- 单根线走了 9.6 ns！
DSP48_X0Y4  DSP48E1 3.076 12.696  u_bf/p_rw/P[1]
```

**`u_bf/wr[12]` 是旋转因子的实部**，由 `fft_twiddle_rom`（分布式 LUT ROM）
产生，要送到 DSP48 的 B 口。工具把 ROM 摆在了离 DSP 很远的位置，
**一根 net 就吃掉了 9.6 ns**（扇出只有 2，根本不是扇出问题）。

**修法**：在 ROM 和 DSP 之间插一级寄存器。

```verilog
reg signed [TW-1:0] tw_re_r, tw_im_r;
always @(posedge clk) begin
    if (!rst_n) begin tw_re_r <= 0; tw_im_r <= 0; end
    else        begin tw_re_r <= tw_re; tw_im_r <= tw_im; end
end
// 蝶形用 tw_re_r / tw_im_r 而不是 tw_re / tw_im
```

**为什么零功能改动**：`S_RUN` 的两个相位里 `stage`/`cnt` 都保持不变，
所以 ROM 的输入地址恒定，连续寄存得到的值在 `phase=1` 时必然正确。
**没有多花一个时钟周期，只多了 32 个触发器。**

```
WNS      :  0.621 ns  ->  2.541 ns
关键路径 :  19.717 ns ->  17.830 ns（布线 9.587 -> 6.638）
起点     :  cnt_reg  ->  BRAM 读端口（ROM 的布线被切到独立周期里）
```

> **教训 1**：时序报告的 `Data Path Delay` 一定要看 **logic / route 的拆分**。
> 布线占 49% 说明问题在**摆放**而不在逻辑深度，加流水线/改逻辑都没用，
> 正确做法是**制造一个寄存器边界**，让工具获得摆放自由。
>
> **教训 2**：`report_timing` 不能只看首尾。要展开每一级，找到那根
> 异常的 net —— `0.737 logic / 9.620 route` 一眼就能认出来。

---

## 15. 一句话总结

> **不是我们把 1000 clk 用得很巧妙，而是「48 MHz 跑 48 kHz」本来就富余 1000 倍，
> 而存储式 FFT 只吃掉了其中 2%。**
>
> 这个决定的意义是：把 50 倍的资源余量换成了「1 个蝶形单元 + 2 个 BRAM」的极小硬件开销。
>
> 这种「用时间换资源」的思路在 FPGA 设计里叫 **time-multiplexing（时分复用）**。
> 判断什么时候该用它、什么时候该反过来（用资源换时间），
> 正是 FPGA 架构设计最核心的判断力。
