flyingyuya/Sonic-Speed-Parallelism/docs/08-skills-index.md

# 08 开发经验沉淀：Skills 索引

> 本项目把开发过程中**踩过的坑、定下的流程、验证的方法**封装成了 3 个可复用 Skills，
> 放在 `.pi/skills/` 下。它们既是**工程资产**（换项目能直接复用），
> 也是**过程证据**（记录了每个问题从现象到根因到修复的完整链条）。

---

## 1. 什么是 Skill

Skill 是**按需加载的能力包**：平时只把「名字 + 一句话描述」放进上下文，
当任务匹配时才把完整内容读进来（progressive disclosure），
避免无关信息占用上下文。

结构：

```
.pi/skills/<skill-name>/
├── SKILL.md              # 必需：frontmatter（name + description）+ 主流程
└── references/           # 可选：深入文档，主文件里用相对路径链接
    └── xxx.md
```

调用方式：
- **自动触发**：描述里写清了"什么时候用"，任务匹配时自动加载
- **手动触发**：`/skill:fpga-rtl-flow`

---

## 2. 三个 Skills

| Skill | 一句话职责 | 何时触发 |
| --- | --- | --- |
| **`fpga-rtl-flow`** | 纯 RTL 工程的无 GUI 开发流程 | 要仿真/综合/构建 FPGA 工程、写 Tcl 流程、排查构建报错 |
| **`fixed-point-dsp`** | 定点 DSP 的位宽预算与结构选择 | 实现滤波器/FFT、选 Q 格式、评估定点精度、排查"频响不对" |
| **`rtl-verification`** | 与 Python 定点黄金模型逐位对拍 | 建自动化验证、写 testbench、排查"仿真不通过/差一拍" |

### `fpga-rtl-flow`（核心流程）

- **两条腿走路**：iverilog 秒级验功能，Vivado 分钟级验能否上板
  （附真实反例：组合环在 iverilog 里恰好收敛，三条 testbench 全过，Vivado DRC 才抓到）
- 非工程模式 vs 工程模式、GUI 工程共存的 4 个坑
- 报告解读：资源/时序/DRC 各看什么、危险信号是什么
- 约束要点：过约束反推 Fmax、CFGBVS/CONFIG_VOLTAGE

`references/`：
- `mmcm-clocking.md` —— MMCM 可达频率计算（**含 `CLKOUT0_DIVIDE_F` 1/8 步进这个关键点**）、
  穷举脚本、一个 MMCM 不能产出两个不相关频率的证明、`locked` 同步写法
- `vivado-batch-cheatsheet.md` —— 完整 Tcl 命令、报告解读、7 类常见报错

### `fixed-point-dsp`（精度预算）

- **位宽 ≠ 小数位**：`signed [17:0]` 配 `2^-17` 的范围是 `[−1,1)`（Q0.17），配 `2^-16` 才是 `[−2,2)`
- **DSP48E1 25×18 的操作数分配**：三种方案与取舍
- **舍入/饱和**：`>>>` 与 Python `>>` 的 floor 语义一致；累加器隐式截断必须在模型里显式模拟
- **条件数优先于位宽**：定点误差比预期大一个数量级时，**先换结构再加位宽**

`references/`：
- `q-format-and-rounding.md` —— 标度推导、位级对齐检查表、负数 hex 向量写法
- `biquad-structure-choice.md` —— 相消的定量分析、一阶 vs 二阶的实测对比、频响评估的 `a0` 陷阱

### `rtl-verification`（验证方法）

- **黄金模型必须是定点的**，判据是**逐位相等**（`!==`），不是"误差小于阈值"
- **三段式激励**：冲激 / 多音 / 满量程方波（专门覆盖饱和分支）
- **协议行为模型**：写一个"另一个芯片"，双向独立判定（避免收发同错互相抵消）
- **系统级用冲激响应比对**：自动定位 IR 起点，不需要预知流水线延迟，顺便拿到端到端延迟实测值

`references/`：
- `golden-model-method.md` —— RTL ↔ Python 位级映射表、代码组织、ROM 生成策略、常见反模式
- `debug-playbook.md` —— **按现象分类的排查决策树**（输出全零 / 数量不对 / 差一拍 / 数值偏差 / 完全对不上 / 编译失败）

---

## 3. 方法论：问题 → 定位 → 修复 → 沉淀

每个坑都走完这条链才写进 Skill：

```
① 现象     可观测的异常（数值差多少、哪一路错、什么条件下出现）
② 定位     用对比/二分/dump 把范围缩小到具体一行（不是猜）
③ 修复     最小改动，改完立刻重跑验证
④ 量化     修复前后各测一次，拿到可比数字
⑤ 沉淀     抽象成规则，写进 Skill 的"踩坑"章节
```

**没有第 ④ 步的经验不是经验，是感想。** 下面这张表就是所有第 ④ 步的产出。

---

## 4. 问题账本（过程证据）

> 共 56 条。每条都走完「现象 → 根因 → 修复 → **量化改善**」四步。
>
> 第 17~20 条是同一轮里用**四种不同的手段**发现的，对照着看很有价值：
> **17 靠综合器报错、18 靠 DRC、19 靠资源报告、20 靠时序报告。**
> 四个 bug 里只有 0 个能被仿真发现。
>
> 第 21~22 条是同一类问题的两面：**手算容易错的换算/位域，就该交给脚本生成**。
> 第 23 条比较特别 —— **是 testbench 自己写错**，说明验证代码同样需要
> 被怀疑：报错的时候要先确认是 DUT 错还是 TB 错。
>
> 第 24~26 条都发生在显示链，共同主题是**“看起来对，其实没在检查”**：
> 24 是声明位置导致编译直接失败（还算好的），
> 25 是 TB 对齐错导致满屏假错误，26 最阴 —— 工具报告干净，
> 实际是**根本没分析**；29 是反面 —— 工具报了违例，但**它本来就不该算那条路径**。
>
> 第 18/19/30/45 条是**同一根因的四次出现**：异步复位。
> 它分别表现为 DRC 违例、资源浪费、DSP 无法合并寄存器、
> 以及**又一次 DRC 违例** —— 而且第 4 次是在「以为已经全清掉了」之后。
> 教训升级：**改完要全量重扫，不能只改被报出来的那一处。**
>
> 第 46 条更阴：复位【风格】改对了，但复位【连接的位置】不对 ——
> 它被综合器顺手接到了 BRAM 的控制脚上，照样触发同一条 DRC。
> 「同一个 DRC 换了个人来犯」比「同一个模块犯两次」难查得多。
>
> 第 49/50 条是**上板才暴露**的一对：49 是 DUT 的真 bug（命令写一半时
 `?` 被吞、状态机卡死），50 是**测试工具自己在说谎** —— 把失败藏进了
 `if` 里不计入统计。**49 能活下来，正是因为 50**。
 TB 也测不到 49：它测非法字符时状态机一直停在 `S_CMD`，
 而 `S_CMD` 本来就有"其它字符一律忽略"。**要测中间态，就得先制造中间态。**

 第 52 条最特别：**iverilog 和 Verible 都放过了它** —— 连 `-Wall` 都不报，
 TB 也全过，**只有综合器抓到了**。这直接暴露了一个流程漏洞：
 回归全绿不等于设计合法。见第 52 条。

 第 47 条是关于**「零警告」这个目标本身**的：
> 不是所有警告都该被消掉。有些警告的前提在你这个设计里根本不成立，
> 硬消它反而会让设计变差。判据要写下来，而不是默默 waive 掉。
>
> 第 23/25/28/32 条是**同一个陷阱的第 1~4 次**：拿一个和被观测信号
> 不同拍的信号去比对（非阻塞赋值、寄存输出、同步器延迟都会造成）。
> 写 TB 时先搞清楚「这个信号在哪一拍稳定」，再决定在哪一拍采样。
>
> 第 34 条是另一种教训：**近似公式的误差指标不能凭印象写**。
> 「±4.3%」我写过很多次、也被人引用过，直到真的穷举比对才发现是 +9.1%。
> 凡是写进文档的数字，要么有出处，要么自己算一遍。
>
> 第 37/38 条是**参数化改造的连带代价**：柱数 30→60 看起来只是改一个常量，
> 实际上牵动了 **位宽**（5→6 位）、**几何**（16→8 px）、**扇区数**（32→64）、
> **TB 里的镜像常量**（圆心、扫描范围）。
> 教训：改一个「全局参数」之前，先列出所有依赖它的地方 —— 这本身就是需求。
>
> 第 39 条是**语法习惯差异**：C 语言里 `for` 后跟缩进的多行语句是合法的，
> 所以很容易习惯性省略花括号；Verilog 不行。
> **多行循环体一律加 `begin/end`，哪怕只有一句也加上。**

| # | 现象 | 根因 | 修复 | 量化改善 |
| --- | --- | --- | --- | --- |
| 1 | 滤波器完全失效，频响最大误差 7 dB，单段测试出现 +87 dB | 18 bit 系数用了比例 `2^-17`（范围 `[−1,1)`），`b1≈−1.984` 被削顶到 −1 | 比例改 `2^-16`（Q2.16），并加设计期范围硬断言 | **7.0 dB → 0.048 dB** |
| 2 | 定点频响评估虚报 −187 dB 误差，差点误判方案不可行 | 评估函数里 `a0` 没跟着系数一起缩放（分母小了几万倍） | `a0 = 1 << CF` | 从"结论：方案不可用"回到 **0.048 dB 可用** |
| 3 | 仿真三条 testbench 全 PASS，但硬件上是竞争条件 | `audio_fifo` 的 `full` 由 `wptr_nxt` 译码，形成 `wptr_nxt→full→do_wr→wptr_nxt` 组合环；iverilog 恰好收敛所以不报错 | `full` 改由**已寄存的指针**译码 | Vivado DRC `LUTLP-1` **从报错变 0** |
| 4 | 整帧数据全零 | `frame_start` 是寄存器输出，比 `bclk_fall` 晚一拍，收发端在错误的沿装载 | 改成组合输出 `assign frame_start = bclk_fall & (bcnt==NLAST)` | 0 帧 → **62 帧全对** |
| 5 | LRCLK 周期错一倍 | 写成"每个帧翻转一次"，实际 bcnt 走 0..63 → 半周期 64 个 BCLK | 改为由 `bit_idx` 直接译码 `lrclk <= (bcnt_nxt >= SLOT)` | 每帧 BCLK 数 128 → **64（正确）** |
| 6 | 右声道被左声道覆盖 | `frame_start` 每个 LRCLK 翻转都脉冲，TX 在半帧处又把整帧重载一遍 | 区分 `frame_start`（整帧起点）与 `half_start`（半帧） | 右声道 **256/256 错 → 0 错** |
| 7 | 端到端对拍只有 `band0` 系数错，其余全对 | 系数装载 FSM 在装载**进行中**收到新 `cfg_load` 时直接改了 `gain_reg`，前 5 个系数用旧档、后 20 个用新档 | 请求只置 `dirty`，`gain_reg` 在装载开始时整批锁存 | 左声道 **256/256 错 → 0 错** |
| 8 | testbench 在配置窗口内就开始灌数据 | `wait(running)` 在 `cfg_load` 同一拍就返回（那一拍 `dirty` 还没置位） | `wait(cfg_busy); wait(running);` | 从"随机失败"变为**稳定 PASS** |
| 9 | 判断"200 MHz 无法精确产生 48 kHz"，改用 +11 ppm 近似 | 只枚举了整数输出分频，漏掉 `CLKOUT0_DIVIDE_F` 的 **1/8 步进** | `D=5, M=24.000, O=78.125` → `960/78.125 = 12.288` 正好整除 | **+11 ppm → 0 ppm（精确）** |
| 10 | 100 Hz 低架频响误差 1.4 dB | 二阶低架分子在近 DC 正比于 `w0²`，与量级 2 的系数形成 ~14 位相消 | 换**一阶低架**（分子 ∝ w0），RTL 零改动（令 `b2=a2=0`） | **1.4 dB → 0.089 dB** |
| 11 | 8 kHz 高架系数 `b0 = 2.12`，超出 Q2.16 | 高架在近 Nyquist 处条件数变差 | 换**二阶 peaking**（DC/Nyquist 增益恰为 1） | 105 组系数 `max|c|` **2.12 → 1.953，全部在界内** |
| 12 | 器件型号用错（`csg324-1`），管脚约束会全错 | 套用了常见开发板的默认值，没核对实际板卡 | 从用户手册确认为 `xc7a100tfgg484-2` | Fmax **49.7 → 61.6 MHz**（-2 速度等级） |
| 13 | 所有命令在用户终端里 `command not found` | iverilog 是绿色解包安装（`~/.local/opt/`），包装脚本在 `~/.local/bin` 但没有任何配置文件把它加进 PATH；Vivado 同样 | 流程脚本改为**自带工具定位**（PATH → 常见位置兜底搜索） | 清空 PATH 的模拟终端里 **3/3 testbench 通过** |
| 14 | FFT 蝶形逐位对拍：621 组全部偏 **−1 LSB** | 四舍五入的 `+1` 写成了 `1'sd1` —— **1 位有符号数取值只能是 0 或 −1**，实际变成减 1 | 改用 `localparam signed [SW-1:0] ONE_SW = {{(SW-1){1'b0}}, 1'b1};` | **621 组 0 不符**（同时避开相邻陷阱：`1'b1` 无符号会让 `>>>` 退化成逻辑右移） |
| 15 | FFT 只输出 511/512 个频点，且前 511 个完全正确 | 同一个 `always` 块里 `y_valid <= 1'b0` 覆盖了前面的 `y_valid <= 1'b1`（**Verilog 后者胜出**） | 删掉末尾那句，让清除由下一拍的 `S_IDLE` 分支负责 | **511 → 512 个输出，全部逐位一致** |
| 16 | FFT 综合后 **50883 个触发器（40%）、BRAM = 0** | 双口 BRAM 的两个端口写进同一个 `always` 块，Vivado 认不出，49152 bit 全变成 FF | 每个端口一个独立 `always` 块 + `(* ram_style = "block" *)` | **50883 FF → 1630 FF；BRAM 0 → 2**。⚠️ 仿真完全发现不了，只能靠看综合报告 |
| 17 | 复制过来的 `WM8960_init.v` iverilog 能编译，Vivado 报 `Synth 8-2576: procedural assignment to a non-register Init_Done` | 重排版端口声明时把 `output reg Init_Done` 的 **`reg` 弄丢了**，变成对 wire 做过程赋值 | 补回 `output reg` | 综合通过。⚠️ **iverilog 比 Vivado 宽松得多**，仿真过了不代表能综合 |
| 18 | `fft_core` 综合报 **REQP-1839 : RAMB36 async control check x20** | BRAM 的地址/使能脚（`WEBWE`）由带**异步复位**的寄存器驱动；复位有效时信号在两个时钟沿之间异步跳变，时钟沿落上去可能非法写 BRAM，而默认 STA **不覆盖**这条路径 | 把驱动 BRAM 控制脚的 always 块改成**同步复位**（`always @(posedge clk)` + `if(!rst_n)`） | REQP-1839 **20 → 0**，且功能逐位不变 |
| 19 | 一个 64x24 位的输入 FIFO 综合出 **1536 个触发器**，`LUT as Memory = 0` | 同一个根因的另一面：**带异步复位的存储体推断不出 RAM**（RAM 原语没有"异步清零整块存储"的功能），只能拆成带 CLR 脚的 FF | 同上，改同步复位 | **1630 FF → 126 FF**，LUT 1560 → 1004，多出 32 个 LUTRAM。⚠️ 仿真完全发现不了，**只能看资源报告** |
| 20 | `fft_core` 时序从 +3.310 掉到 **+0.621 ns** | 关键路径里 `u_bf/wr[12]` 一根 net 的**布线**就占 9.6 ns（逻辑只占 10.1）—— 旋转因子 ROM 被摆到离 DSP48 很远 | ROM 与 DSP 之间**插一级寄存器**（`stage`/`cnt` 在 RUN 两相位内不变，故零功能改动） | **WNS 0.621 → 2.541 ns**；布线 9.587 → 6.638 ns。功能逐位一致 |
| 21 | 手写的 WM8960 寄存器表里 **I2C 字节列全错**（例：R8 写成 `71 C4`，正确是 `11 C4`） | WM8960 是 16 位字协议：`[15:9]`=7 位寄存器地址、`[8:0]`=9 位数据。手算时把 `reg<<9` 写成了 `reg<<8` | 改为**脚本生成**表：`scripts/golden/gen_wm8960_table.py` 同时产出 Verilog ROM + 文档表格，两处同源 | 20 条全部逐字节核对通过（`tb_wm8960_init` 用 I2C 从机模型解回来比对） |
| 22 | PLL 配好了但 SYSCLK 频率不对 | R52 的 **SDM 位漏设**。R52 复位默认 `0_0000_1000`（SDM=0 整数模式），而 datasheet Table 45 给的例值全都带非零 K —— 那些例子**必须配 SDM=1（分数模式）**，只抄 K 不设 SDM 就会按整数模式跑 | 生成表里 R52 写 `0x038`（含 SDM=1），并在生成脚本注释里写明原因 | `tb_wm8960_init` 逐条比对 R52 的值，PLL 参数 24MHz→12.288MHz 可复现 |
| 23 | 自己写的 testbench 里，明明成功了却报“超时” | 用了 `fork ... join` 等两个分支：`join` 会等**全部分支**结束，所以超时分支必然在 200ms 打印一次 “超时”，即使 21ms 就成功了 | 改成**先结束的分支去 `disable` 另一个**（Verilog-2001 不能写 `disable fork`） | 报错消失，`Init_Done` 实测 21.4ms 拉高、`PLLEN→CLKSEL` 间隔 9.649ms 均被正确测到 |
| 24 | `lcd_timing.v` 里 `$clog2` 用在端口声明上报 `Unable to bind wire/reg/memory H_TOTAL` | 端口位宽要在**解析模块头时**就确定，而 `H_TOTAL` 是写在模块体里的 `localparam`，位置在端口之后 | 把派生位宽提成 **parameter**（Verilog-2001 允许后面的 parameter 引用前面的）：`parameter HW = $clog2(H_SYNC+H_BACK+H_DISP+H_FRONT)` | 编译通过，资源 56 LUT / 47 FF |
| 25 | TB 报“261120 个像素颜色全错”，看起来像显示链彻底坏了 | **TB 自己对错了一拍**：`de` 已经是 `lcd_timing` 的寄存输出，正确配对是 `de(T+1) ↔ x(T)`，我却又把 `de` 延了一拍去配 `x` 延迟一拍 → 整体又错开 | 改成用**当拍的 `de`** 配**延迟一拍的 x/y** | 130560 个像素全部一致。**同一个坑踩了两次**（`lcd_timing` 那次也是），说明这条契约值得单独写进文档开头 |
| 26 | `disp_top` 的 `report_cdc` **一片空白**，看上去“没有任何跨时钟域问题” | 综合脚本里时钟端口名**写死成 `wclk`/`rclk`**，而该模块的端口叫 `clk_sys`/`clk_pix`。`create_clock` 静默失败 → 没建时钟 → CDC 根本没分析 | 时钟参数改成通用的 `端口名=周期ns` 形式，并写成多个参数 | CDC 报告立刻现原形：**183 + 3 个跨域端点，Safe 全部安全、Unsafe=0、缺 ASYNC_REG=0**。⚠️ **工具报告“干净”时要先确认它真的跑了** |
| 27 | `i2s_slave_clk` 的 `frame_start` / `half_start` **永远不成立**，收发全错一帧 | 用**未寄存**的边沿检测信号 `fall_w` 去推进位计数器，但 `bclk_fall` 是**寄存**输出、要下一拍才为 1。于是 `frame_start = bclk_fall & (bcnt==NLAST)` 求值时 `bcnt` 已经自增过了 | 把计数器改成用**寄存后**的 `bclk_rise`/`bclk_fall` 驱动，与 `i2s_clkgen` 保持同拍 | 300 帧收发**双向 0 误码**；19200 次位计数检查 0 越界 |
| 28 | TB 报 TX“差一帧”（收到 abc000 期望 abc001），看着像 `i2s_tx` 装载时机有问题 | **TB 在 `frame_start` 同一拍**改 `tx_l`，而 `i2s_tx` 也在同一拍用非阻塞赋值装载 `l_data` —— 读到的是**旧值** | TB 改在 `half_start`（半帧处）提前更新，并另用一个 `tx_lat_*` 寄存器**精确镜像** DUT 实际锁存到的那份数据用于比对 | 发送通路 300 帧 0 错误。⚠️ 这和第 23/25 条一样属于“**报错时先确认是 DUT 还是 TB**” |
| 29 | 整机第一次实现 **WNS = -1.497 ns / TNS = -249 ns**，但“关键路径”的 `Requirement` 只有 **0.833 ns** | XDC 里**没有声明 `set_clock_groups -asynchronous`**，Vivado 于是把 clk_sys↔clk_pix 的路径按同步关系硬算 —— 两个频率比 48:12.5 的时钟之间最近边沿只有 0.833 ns，必然违例。**这条路径本来就不需要算**（跨域全靠 `async_fifo` 的格雷码指针） | 新建 `constrs/clocks.xdc`：用 MMCM 输出**引脚**显式命名时钟，声明两个时钟组异步；并把 `lcd_clk` 从“独立 `create_clock`”改成 `create_generated_clock`（clk_pix 的转发时钟） | WNS **-1.497 → +0.581 ns**，TNS **-249 → 0**；`report_cdc` 显示 183+3 端点全部 Safe、Unsafe=0 ⚠️ 和第 26 条同一类：**先看清工具在算什么** |
| 30 | 整机 DRC 报 **DPOR-1（异步负载检查）x 180** | `eq_cascade` 的寄存器用**异步复位** —— DSP48 内部的输出寄存器只有同步复位能力，于是这些寄存器无法并入 DSP，白白多占 LUT/FF 且恶化时序 | （尚未修）改成同步复位 | 与第 18/19 条**同一根因第三次出现**。当前时序已收敛（+0.581 ns），属于优化项而非正确性问题；若要收紧时序/降功耗再改 |
| 31 | 整机冒烟仿真**跑 4 分钟没有任何输出**，连 t=100 ns 的探针都没打印 | TB 里算 BCLK 半周期写成了 `1000.0 / (2.0 * 6_144_000.0)` = **8.14e-5 ns**（应为 `1e9 / (2f)` = 81.38 ns）。在 `1ns/1ps` 精度下这个延迟直接舍入成 **0**，于是 `#0` 变成**时间 0 的无限循环** | 改成 `1_000_000_000.0 / (2.0 * 6_144_000.0)` | 仿真 23 秒跑完，整机冒烟 **PASS** |
| 32 | 冒烟报“clk_pix 侧柱高全是 0”，但 clk_sys 侧明明有 30 根非零柱 | TB 在 `sof` 那一拍抓 `bars`，而 `spec_sync` 里 `bars <= stage` 是**非阻塞赋值** —— sof 当拍读到的是**上一帧**的旧值 | 改成在测量结束后直接读 `u_sync.bars` | 30/30 根非零（柱0=368 柱15=316 柱29=348）。⚠️ **这已是第 4 次踩“和被观测信号差一拍”**（第 23/25/28 条） |
| 33 | `polar_map` 的辐条顺序整个乱掉（把第 4 象限当成第 2 象限） | 八分圆编号我是凭直觉按 `{dx_neg,dy_neg}` 的 00/01/10/11 顺序写的，但象限顺序实际是 00(第1)/**10**(第2)/**11**(第3)/**01**(第4) —— 符号位的编码顺序和象限顺序**不是一回事** | 按真实象限重排 case 分支 | 用 `$atan2` 扫遍圆盘 49920 个像素逐点比对，**全部一致**；环绕/镜像检查也全过 |
| 34 | 文档里 `max + 0.4375·min` 的误差写的是“±4.3%” | **凭印象写的，没穷举验证过**。写 `tb_polar_map` 时逐点和 `$sqrt` 比对才量出真实最大误差是 **+9.1%**（出现在 min/max≈0.5 处），而且永远偏高 | 更正 `docs/10`、`docs/11`、`rtl/fft/fft_core.v` 三处；并在 `polar_map` 里改用精确平方比较（画圆时 9% 的角度相关误差会看起来像歪花瓣） | 极坐标点亮边界变成**逐点精确**（32 个方向全部吻合） |
| 35 | `run_iv.sh` 把一个**失败**的 testbench 统计成了“通过” | 脚本只用 `if vvp ...` 判断退出码，而 testbench 结尾的 `$finish` **永远返回 0** —— PASS/FAIL 文本根本没被检查 | 改成用 `tee` 存日志 + `grep -q '\*\*\* PASS'` 判断，失败时把 `[ERR]` 行打出来 | 立刻抓出 `polar_map` 的真实失败。⚠️ **回归脚本本身也是被测对象** —— 它谎报过一次，说明“17/17 PASS”这个数字此前并不完全可信 |
| 36 | 极坐标画出来是**一整块实心圆盘**，完全看不出频谱形状 | 柱高→半径的缩放写成 `bh >> 2`，而实际可用半径跨度只有 `R_MAX-R_IN = 58`；`bh>232` 的柱全部被钳到外圆 | 按实际跨度缩放：`bh * 58 / 512 ≈ bh * 29 / 256`（`(bh<<5)-(bh<<1)-bh` 再右移 8） | 辐条长度立刻能区分；同时把 TB 里独立写的同一公式也改对 |
| 37 | 柱数从 30 改到 60 后，极坐标**右半个圆全被压到柱 0** | 参数化改造时只改了宽度有关的地方，**没跟着改位宽**：`sub` 从 4 段（2 位）变 8 段（3 位）时仍声明成 `[3:0]`，于是 `sector = {oct, sub}` 变成 7 位被截成 6 位；TB 的 `bar_idx` 也从 5 位该变 6 位 | 逐一核对**所有位宽**：`fsub`/`sub` 改 3 位、`bar_idx` 改 6 位、比较时 `exp_bar[5:0]` 而不是 `[4:0]` | 穷举 49920 个像素重新全部吻合 |
| 38 | `polar_map` 的 TB 报出 6113 处“不符”，看着像变换整体错了 | **TB 的圆心常量没跟着改**（还是 30 根柱时代的 120/104，而 DUT 已经是 240/96），TB 扫的区域和 DUT 的圆盘完全错位；`disp_mix` 的柱内空隙判断也还留在 16px 时代的 `x[3:0]` | 把 TB 的 CX/CY 同步、扫描范围扩到 480x208、`b_col` 改用 `x[2:0]` | `polar_map` 与 `disp_top` 双双 PASS，130560 像素逐点一致 |
| 39 | 改测试数据后，TB 报“clk_pix 读到 0，写入 467”，看着像跨时钟域坏了 | `for` 循环体**漏了 `begin/end`** —— Verilog 的 `for` 只带【一条】语句，后面的赋值全跑到循环外，只执行一次（此时 k 已越界）。于是 `spec_din` 根本没被写入，全 0 | 补上 `begin/end` | 立刻 PASS，图片也能看出音乐形状了。⚠️ 我先怀疑了 FIFO、CDC、位宽，最后打印 `spec_din` 才发现源头就错了 |
| 40 | 极坐标/柱状的色相**几乎不滚动**（几帧才动一次，肉眼像静止） | 滚动判据写成 `frame_cnt[7:0] == tick_mask`，而 `frame_cnt` 是 8 位 —— 这要等 256 帧才命中一次。本意是「每 2^spd 帧滚一次」 | 改成 `(frame_cnt & tick_mask) == tick_mask`（低位全 1 即触发） | 色相按预期每 4 帧滚一级 |
| 41 | `tb_ui_ctrl` 跑不完就超时；`tb_disp_top` 的抽查说「柱状一直不亮」 | 两处都是**TB 的时间单位**搞错：① `#(CNT_MAX + 2000)` 里 `CNT_MAX` 是**周期数**，`#` 要的是**时间**，1 周期 = 1000 ns → 差 1000 倍；② 抽查只跑 3000 拍，而一帧是 525x286 = **150150** 拍、柱状区在 y>=176，3000 拍才 5.7 行根本扫不到 | ① 改用 `repeat (CNT_MAX+2000) @(posedge clk)`；② 抽查窗口放到 110000 拍 | 两个 TB 都 PASS。写 TB 时**周期数和时间要分清楚**，能用 `repeat @(posedge clk)` 就别用 `#` |
| 42 | `cmd_proc` 的上电横幅会**提前**触发（本该 50 ms，实际约 0.84 ms） | `power_cnt` 声明成 `reg [15:0]`，而 `BANNER_DLY` = 48e6/1000x50 = **240 万**，比较时又写了 `BANNER_DLY[15:0]` 把常数也截断了。16 位最大 65535，根本等不到 | `power_cnt` 加宽到 32 位，比较用 `BANNER_DLY[31:0]` | 横幅按预期在 50 ms 发出。⚠️ 写大计数常数时**顺手检查计数器位宽够不够** |
| 43 | 给 `tb_top` 插入 UART 模型后，冒出一堆 `implicit definition of wire 'aud_scl'` 之类的警告，编译失败 | 用「剪切-粘贴」重排代码块时，**把夹在中间的音频 I2C/I2S 声明和从机模型一起剪掉了** —— 剪切范围按「从 A 到 B」取，没确认 B 之前还有什么 | 把切掉的整块补回来 | 编译通过。⚠️ **大面积剪切前先看清楚被剪掉的到底是什么**，宁可多分几次小范围操作 |
| 44 | `aud_bclk` / `aud_lrclk` / `aud_adcdat` 报 `[Vivado 12-4702] DRIVE is not a supported property on input port(s)` | `constrs/audio.xdc` 里为了「杜邦线长、加大驱动」写了 `set_property DRIVE 12 [get_ports {aud_bclk aud_lrclk aud_adcdat aud_dacdat}]`，但 `DRIVE` **只能作用于输出端口**（含 inout 的输出驱动部分）。而本设计 FPGA 是 I2S **从机**，`bclk`/`lrclk`/`adcdat` 全是**输入** —— 输入端的信号质量由对方驱动，设 DRIVE 既非法也无意义 | 只保留输出端口：`{aud_dacdat aud_scl aud_sda}`（`aud_sda` 是 inout，Vivado 接受）；顺带把 `SLEW` 设为 `SLOW`。另注：**LVCMOS33 的默认 DRIVE 本来就是 12 mA**，这一行本来就等于没写 | 警告消失。⚠️ **抗长线振铃靠 SLEW slow，不是靠加大驱动电流** —— 驱动越大过冲越厉害 |
| 45 | 整机实现时 `[DRC DPOR-1]`（DSP 输出寄存器带异步复位，阻止合并进 DSP）和 `[DRC REQP-1839]`（RAM 控制脚由带异步复位的触发器驱动）**再次出现** —— 这是同一个根因第 **4** 次复发 | 上一轮只把 `fft_core.v` 改成了同步复位，**没有全量扫**。实际还在用 `or negedge rst_n` 的有 6 个文件：`eq_cascade`、`i2s_rx`（2 处）、`i2s_tx`、`i2s_clkgen`、`audio_top`、`cdc_sync`（2 处）。而本设计的 `rst_n` 来自 `rst_sync`（**已经是域内同步释放**的），所以异步复位在这里**一点好处都没有**，纯代价 | 全部改成同步复位（`always @(posedge clk)` + `if (!rst_n)`）。`rst_sync.v` 自己**保留**异步（它就是复位产生器） | `DPOR-1` 从 11 → **0**；WNS 从 +1.117 → **+2.156 ns**；LUT 从 6802 → **5648**（同步复位少用了 1154 个 LUT 做置位/复位逻辑）。⚠️ **「已修复」要按根因全量重扫，不能只改报出来的那一处** |
| 46 | 第 45 条修完后，`[DRC REQP-1839]` **还剩 5 条**，而且换了驱动者：不再是 `i2s_rx`，而是 **`rst_sync` 自己的输出**（`u_rst_pix/sync_q_reg[1]` / `u_rst_sys/sync_q_reg[1]`） | `wave_buf.v` 的复位**风格**是对的（同步），但复位**接的位置**不对：`if (!wrst_n) ... else if (we) mem[wbin] <= din;` 让综合器把它做进了写使能 → `WEA = ~wrst_n & we`；`if (!rrst_n) dout <= 0; else dout <= mem[raddr];` 让它接到了 BRAM 的 `RSTRAMB`。于是「复位」这个信号一路碰上了 RAM 的控制脚 | **只复位指针，不复位 RAM 内容**：写侧改成两个独立 `if`（`if (we) mem[...] <= din;` 不设复位，`if (!wrst_n)` 单独复位指针，后写的优先）；读侧去掉 `dout` 的复位，`rrst_n` 只留给 `rbase` | `REQP-1839` 从 5 → **0**，DRC 从 50 → **0**。而且这是**语义上更正确**的写法：`wave_buf` 是滚动窗口，旧数据立刻被新采样覆盖，复位 RAM 内容本来就无意义。⚠️ **DRC 说「换个人来犯」的时候，要看的是「信号怎么流过去」而不是「哪个模块」** |
| 47 | 清完上面几条后，还剩 **50 条** `DPIP-1` / `DPOP-1` / `DPOP-2`（DSP48 输入/乘法级/输出级没打拍），横跨 **EQ 双声道、FFT 蝶形、极坐标平方** 三处 | 这三条是**性能/功耗建议**，不是违规。Vivado 的默认前提是「DSP 没打拍 → 组合路径长 → 流水化能提频」。但在本设计里这个前提**不成立**：① EQ 是 direct-form II transposed 双二阶，环 `s1→acc→y→a1·y→s1'` **按定义不可流水化**；② 所有 DSP 通路都有 Python 黄金模型**逐位对拍**，插寄存器会改数值行为、必须全量重验，而**功能收益为零**；③ 实测 `clk_sys` WNS = **+1.548 ns**（最差路径还是 FFT 写回，逻辑级数 32，不是 DSP 本身），时序已收敛；④ 将来加 HDMI 在**另一个时钟域**，不争 `clk_sys` | **不消它，而是有据可依地 waive**：新建 `scripts/vivado/drc_waivers.tcl`，逐条写明理由并量化证据，由 `build.tcl` 在 `report_drc` 前 source | DRC 报告变成 `Violations found: 0` + **`Violations waived: 50`** —— 豁免项**仍出现在报告里，不是静默消失**。全流程 **0 WARNING、0 CRITICAL WARNING**。⚠️ **「零警告」不是目标，「每条警告都被理解并判断过」才是** —— 该改设计的改设计（44/45/46），该写判据的写判据（47） |
| 48 | `synth_check.tcl` 报 `[Synth 8-1766] cannot open include file disp_cfg.vh`，而且失败在 `ui_ctrl.v:29` —— 看上去像 `ui_ctrl` 或 `disp_cfg.vh` 出了问题 | `synth_check.tcl`（单模块 OOC 综合）**漏配了头文件搜索路径**。整机 `build.tcl` 里有 `set_property include_dirs [...] [current_fileset]`，但 OOC 脚本是后写的，照抄了 `read_verilog` 却忘了这一行。于是所有 OOC 检查都在早期就失败 —— **`build/vivado/*_drc.rpt` 里的旧内容是过期的**，看起来"检查过了"其实没有 | 在 `read_verilog` 之后补上同样的 `set_property include_dirs`；顺手把 OOC 流程里【前提不成立】的 `NSTD-1`/`UCIO-1`/`CFGBVS-1`/`IOCNT-1` 也加进豁免（单模块没有物理管脚；`disp_top` 的 600 位 `spec_din` 扁平总线被 `IOCNT-1` 当成顶层 IO，凑出 612 个端口） | 6 个模块的 OOC 检查全部 `Violations found: 0`。⚠️ **脚本静默失败比设计错误更危险** —— 报告文件还在、时间戳还在，但内容是上一轮的 |
| 49 | 上板实测：发 `V2`（半条命令）之后，`?` **不回执**；再发 `V2\r` 竟然把 `V` 写成了 **0x22** | `cmd_proc.v` 的 `S_HI` / `S_LO` 两个状态**都缺 `else` 分支**：既不是 hex 也不是 `\r`/`\n` 的字符（`?`、空格、乱码）到达时无处可去，状态机**永久停在那里**。于是 ① `?` 被吞掉，要按两次才看得到回执；② 下一条命令的字母也被吞，它的第一个 hex 位和**残留的 `hi_r`** 拼成错值（`V2` 残留 hi_r=2，再遇 `2` → `{2,2}` = 0x22）。而 `S_CMD` 写着"其它字符一律忽略"，前后不一致 | 两处补齐：① **`?` 提升为全局命令** —— 在 `S_CMD`/`S_HI`/`S_LO` 任何状态都能触发回执（查询本来就该随时可用）；② 其余非法字符统一 `st <= S_CMD` 放弃当前命令、回主态 | `clk_sys` WNS **+1.548 → +2.563 ns**（状态机简化），LUT 5648 → 5598。⚠️ **TB 原本测不到它** —— 见第 50 条 |
| 50 | 排查第 49 条时，`uart_term.py --test` 明明超时了，汇总却显示 **"通过 9 失败 0"** | 我把 `check()` 调用**藏进了 `if show(cfg):` 里面** —— 读超时时 `show()` 返回假，那几条 `check()` 根本没执行，自然也不计入失败。**这和账本第 35 条（回归脚本谎报 PASS）是同一类病，只是换了个工具复犯** | 重构 `run_test`：**每条判定都必须无条件过 `check()`**，读超时也要作为一条失败计入；并把注释写进代码里当"护栏" | 立刻显示 `通过 15 失败 2` —— **失败浮出来了，第 49 条才被定位**。⚠️ **测试框架的第一职责是把"不知道"和"通过"分开**，不是让报告变好看 |
| 51 | 第 49 条修完后，新加的 TB 用例（TB 第 ⑤b 步）在**旧实现上依然 PASS**，等于没测到 | 新用例序列是 `V`→`?`→`S`→`\r`，末尾那个 `\r` 走的是 `is_term` 分支 —— **而那条分支是有的**，状态机靠它脱困了。真正的坑是**没有终止符**时被吞 | 改成先发 `V`（进 `S_HI`）**紧接着只发 `?`**，然后检查**有没有回执**。为了确认这个用例真的有效，**把 RTL 临时打回旧实现跑一遍**：旧实现 `*** FAIL *** 共 2 处错误`，修复版 PASS | 用例有效性**被独立验证过**。⚠️ **新写的回归用例必须先在"已知有 bug 的版本"上失败过，才能相信它** —— 否则你只是加了一段永远绿灯的代码 |
| 52 | 综合时报 **17 条 `[Synth 8-6859] multi-driven net on pin tick[16]`**，`opt_design` 直接失败 | 改写 `demo_src.v` 时，把原来那个"tick 计数 + ph 推进"的 `always` 块**忘了删**，新写的合并状态机也没删它 → 同一个 `tick`/`ph`/`bar_flat` 被**两个 always 块驱动**。⚠️ **而 iverilog（连 `-Wall` 都试了）和 Verible 一声不吭**，`demo_src` 的 TB 还 **PASS** 了 —— 仿真把两个块写同一个 reg 当成"后写有效"，而两个块数 tick 的方式恰好一样，看不出差别 | 删掉重复的 `always` 块，把驱动逻辑收敛到一个块里；在注释里写明"这个 reg 只在这一个块里赋值" | 综合恢复 0 CRITICAL。⚠️ **这是一条流程漏洞，不只是代码错误**：`iverilog + Verible` 的组合**抓不到多重驱动**。**已把 `verilator --lint-only -Wall` 接进 `run_iv.sh`**（Arch 包的 `extra/verilator`，警告名是 `MULTIDRIVENPROC`，**注意它只在 `-Wall` 下才启用**）。为确认这个检查真的有效，**故意把坏代码放回 `rtl/video/` 跑了一遍**：干净设计 0 警告、注入 bug 立刻抓到、还原后恢复 0。**"回归 21/21 PASS" 从来不等于设计合法** |
| 53 | `demo_src` 的柱状图案**每 60 拍就换一帧**（本该 2.7 ms 一帧），TB 里改 mode 后拿到的是"前半段斜坡 + 后半段棋盘"的混合帧 | 状态机算完一帧后把 `tick <= 0`，而重触发的判据正是 `tick_now = (tick == 0)` → **下一拍立刻又满足**，变成连环重建。更新周期从 2^17 掉到 60 拍 | `tick <= TICK_ONE`（即 1）而不是 0，让 `tick_now` 下一拍为假 | 周期精确恢复为 **2^17 + 60 = 131132 拍**。⚠️ TB 顺手加了一条**精确断言**（不是模糊容差）：周期必须恰好 `2^TICK_B + NBARS`，这正是连环重建会露馅的地方 |
| 54 | `demo_src` 第一版占 **+694 LUT**，远超预估的 150~250 | 两个独立的写法定问题：① 包络图案写成 `for (bi=0; bi<60; ...)` 并行算 60 根柱，而且每根柱**调了 3 次** `tri_peak`（比较里两次、赋值里一次）→ 综合展开成 180 份三角运算；② 旁路 mux 是 **540 位宽**的 2:1（60 柱 × 9 位）→ 一位 LUT 一个 mux | ① 改成**串行生成**：一次只算一根柱，用 540 位**移位寄存器**拼装，60 拍算完 —— `demo_src` 本体降到 **72 LUT / 436 FF**；② 宽 mux **保留**，写进注释承认代价 | ① 本体 694 → **72 LUT**；② 整机 5598 → **6043 LUT（9.53%）**，其中约 395 是那位宽 mux。⚠️ **"完全旁路、零影响"这个承诺是有价格的** —— 要旁路 540 根柱就得配 540 个 mux。当前只用了 9.53%，为省这 400 LUT 做侵入式改动不划算，先留着并记录 |
| 55 | 上板反馈：**`H08` 比 `H03` 还慢**，而且从 `H03` 往后"变得很慢" | `H` 被当成**指数**用：`tick_mask = (1<<H)-1` → H 越大掩码越长 → **越慢**。更深的三处：① `hue_spd` 只有 3 位且**钳在 5**，所以 `H06`~`H15` 效果**完全一样**，用户按 H08 其实得到的是 H05；② `H=0` 走的是 `mask=0xFF` 分支 → **每 256 帧**，根本不是文档写的"不滚动"，而是**全场最慢**（文档写反了）；③ TB/文档都只验了"默认值 H=2"，没人验过"H 变大应该变快" | 重定义 `H` = **速度档，越大越快**：`周期 = 2^(8-H)` 帧，`H=0` 真停住，`>7` 当 7。默认值从 **2 改成 6** —— 因为 "H=6 → 每 4 帧" 恰好等于旧 H=2 的 "每 2^2=4 帧"，**上电动画速度完全不变**，只是坐标换成了直觉方向 | H03→每32帧(384ms)、H08→每2帧(24ms)，方向正确。⚠️ **教训：写"速度/增益"这类参数时，先问一句"数值变大时用户预期是变快还是变慢"** —— 指数映射最容易在这里翻车，而且 TB 很难发现（它只验边界值） |
| 56 | 上板反馈：**频谱刷新太快，屏幕上一片糊** | `demo_src` 取 `TICK_B=17`（2.73 ms 一帧）而 **LCD 帧周期是 12.01 ms**（525x286/12.5MHz）→ **比显示刷新快 4.4 倍**。屏幕上"一帧"里图案已经跳了 4 次，看起来就是抖。再叠加相位步进 `+3`，又把这个速度乘了 3 → 峰值 **55 ms** 扫完一圈 | `TICK_B` 17→**20**（21.85 ms，约 LCD 帧周期 1.8 倍），相位步进提成参数 `PH_STEP=1` → **峰值 1.31 s 扫完一圈** | 上板目视：移动平滑、能看清形状。⚠️ **核心认识：更新得比显示刷新快是纯浪费 —— 那些帧根本没人看到。**真实链路里 FFT 帧约 224 us（比 LCD 帧快 50 倍）却没问题，因为显示侧只在帧起始锁存一次（`spec_sync`），**实际可见刷新率就是 LCD 帧率**。演示源应该直接按可见刷新率来 |

---

## 5. 复现方式

```bash
# 看有哪些 skill
ls .pi/skills/

# 手动加载（在 pi 里）
/skill:fpga-rtl-flow
/skill:fixed-point-dsp
/skill:rtl-verification

# 校验 skill 格式（name 合法性、description 长度、相对链接有效性）
# 见本文件 §6 的检查清单
```

## 6. Skill 编写规范速查

| 项 | 要求 |
| --- | --- |
| 目录 | `<skill-name>/SKILL.md`，`references/` 放深入文档 |
| `name` | ≤64 字符，仅小写字母/数字/连字符，无首尾连字符、无连续连字符 |
| `description` | ≤1024 字符，**必须写清"什么时候用"**（这决定它会不会被自动加载） |
| 相对链接 | 主文件里链接 `references/xxx.md`，路径相对 skill 目录 |
| 内容组织 | 核心原则 → 流程（命令级）→ 决策表 → 踩坑清单 → 验收标准 |
| 反例 | **不要写成日志**。要有判断规则和"什么时候不适用" |

**description 的好坏直接决定技能会不会被用上：**

```yaml
# ✗ 差：不知道什么时候该用
description: 帮助处理 FPGA。

# ✓ 好：说清了能力和触发场景
description: 纯 RTL FPGA 工程的无 GUI 开发流程。覆盖工具链定位与自检、
  iverilog 秒级快速仿真、Vivado batch 模式综合/实现/比特流、构建报告挖掘、
  GUI 工程与非工程模式共存、波形查看、MMCM 时钟规划。当需要仿真、综合、
  构建或上板一个纯 RTL FPGA 工程，或排查 "command not found"、组合环 DRC、
  时序违例、比特流无法生成等构建问题时使用。
```
