flyingyuya/Sonic-Speed-Parallelism/docs/images/sd_card/wallhaven-57d9y5_480x272.png

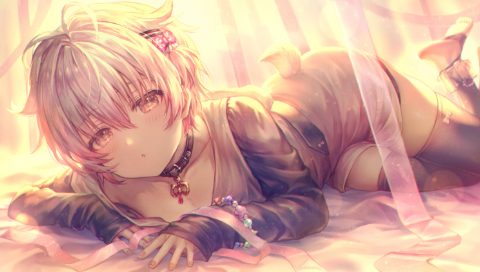
docs/images/sd_card/wallhaven-57d9y5_480x272.png
