flyingyuya/Sonic-Speed-Parallelism/test1.bmp

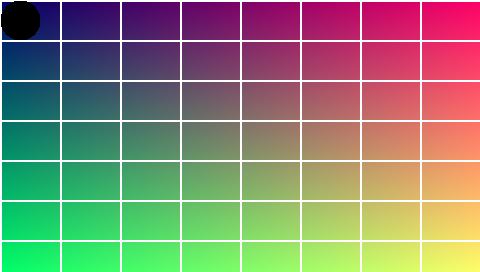
test1.bmp
