flyingyuya/Sonic-Speed-Parallelism/docs/13-todo.md

# 13 待做清单

> **定位**：专精的音频一体化系统，**LCD 交互界面 + HDMI 可视化大屏**双路输出。
> 不做视频输入（见 [01-architecture.md](01-architecture.md) §8）。
> 与其横向铺功能，不如把「采集 → 均衡 → 分析 → 可视化 → 交互」这条链做深做透。

---

## P0 —— 上板验证（当前优先级）

**在跑通之前不做新功能。**

### P0-A 不依赖音频模块，**现在就能做** ⭐

> **前提**：`disp_top` 用的是 `rst_sys_n` / `rst_pix_n`，**不经过** `aud_rst_n`，
> 所以没有音频模块时**显示链和交互链照样工作**。能验的都验掉，别等。

**0. 接线**
- [ ] USB TypeC 线接板上 **JTAG 口**（一根线同时供电 + 调试）
- [ ] 插好 LCD 子卡（**JM1**，和官方 `3_16_PZ_LCD` 例程同一个座子）
- [ ] 音频模块**先不接**

**1. 探测 + 烧板**

```bash
# 先探测（只认器件，不烧）
vivado -mode batch -source scripts/vivado/program.tcl -tclargs detect

# 认到 xc7a100t 后再烧
vivado -mode batch -source scripts/vivado/program.tcl
```

- [x] `lsusb` 看到两个设备：`0403:6014` **FT232H**（JTAG）+ `1a86:7523` **CH340**（UART）

**2. 看 LED（最基础的一步）**

| LED | 预期 | 说明 |
| --- | --- | --- |
| `led[1]` | **~2.9 Hz 闪烁** ✅ **已实测看到** | 证明 MMCM 锁定、复位释放、`clk_sys` 在跑 |
| `led[0]` | **不亮** ✅ **已实测确认** | 没接音频模块时 `init_done` 不会拉高，**这是正常的**（见下方 P0-A.6）|

> 如果 `led[1]` 不闪：先量 200 MHz 差分时钟有没有进来，
> 再查 `arst_n = rst_btn_n & mmcm_locked` 里哪个是 0。

**3. 看 LCD**

- [x] 出现**网格背景** —— **主验证目标，已实测通过**
- [x] 极坐标**内圈**能看出圆形轮廓（辐条全为 0，因为频谱在复位中）
- [x] 柱状区**全空**（同上，正常）
- [x] KEY2 按一下 → 背景在「网格 / 纯渐变」之间切换（实测 `S` 会变）

> 没出图时的排查顺序：① 量 `lcd_clk`(F18) 有没有 **12.5 MHz**
> → ② 量 `lcd_hs`(C18)/`lcd_vs`(E18) 有没有波形
> → ③ 再看 RGB 有没有在动。**先确认时钟，再确认同步，最后才怀疑数据。**

**4. UART 通道**（115200 8N1，板上 CH340E → `/dev/ttyUSB0`）

**先解决权限**（Arch 上设备属主是 `root:uucp`）：

```bash
sudo usermod -aG uucp $USER     # 永久，需要重新登录生效
sudo chmod 666 /dev/ttyUSB0     # 或者只在本次会话临时放开
```

本工程自带工具（只用 `pyserial`，不用装终端）：

```bash
python3 scripts/uart_term.py --list      # 列可用串口
python3 scripts/uart_term.py --test      # 协议自检（9 步 21 项，自动判定）
python3 scripts/uart_term.py             # 交互模式
python3 scripts/uart_term.py -c '?' -c V02 -c '?'
```

想用现成终端也行：`sudo pacman -S picocom` → `picocom -b 115200 /dev/ttyUSB0`

**协议要点**（`V`=视图 `S`=风格 `H`=色相速度 `G`=波形增益 `B`=背景 `A`=自动轮换 `?`=回读）

- [x] 发 `?` 收到 `V07 S00 H02 G03 B0` ✅ **和代码逐字段核对一致**
      > **B 只有一位 hex**（代码用 `cfg_bg_mode[3:0]`）；回执里也**没有 A 字段**。
      > 上电 50 ms 那次横幅早发完了，要主动发 `?` 才能看到。
- [x] 写命令**不回显** ✅ —— 发 `V02` 后要再发 `?` 才看得到 `V=02`
- [x] 敲 `V02` → 回读 `V=02` ✅（LCD 效果待目视确认）
- [x] 小写 `s00` 被接受 ✅；`V2\r` → 回读 `V20` ✅（`2` 当高 4 位）
- [x] **`?` 在命令写一半时也能回读** ✅ —— 上板时这里是坏的，已修（[账本](08-skills-index.md) 49 条）
- [x] 敲 `V02` / `V05` 等 → **画面确实切换** ✅ **已目视确认**
- [x] 敲 `A01` → **每 4 秒自动轮换视图** ✅ **已目视确认**
- [ ] 敲 `S03` → 柱体风格改变 ⏸ **看不到** —— 柱高全 0，风格无从体现（要等音频）
- [ ] 敲 `H00` → 色相停止滚动 ⏸ **看不到** —— 同上
- [ ] 敲 `G07` → 波形振幅变大 ⏸ **看不到** —— 没有波形数据
- [x] 敲 `B01` → **背景切换** ✅ **已目视确认** —— 印证了「按键和 UART 汇到同一条写总线」的仲裁逻辑

**5. 按键**

- [x] KEY1（W21）轮换 6 组视图预设 ✅（回读 `V` 变化证实）
- [x] KEY2（Y21）轮换背景模式 ✅ —— **和 UART 写同一个寄存器**，实测生效
- [ ] 连按 20 次不丢、不重复触发（20 ms 消抖）

**6. 记录无音频时的 `led[0]`**

没接音频模块时 `led[0]` 不亮，**有两种可能**，记下来以便区分：

| 现象 | 含义 |
| --- | --- |
| `led[0]` 不亮，但 UART/LCD 正常 | `WM8960_init` 的 `cnt` 卡住了（`ack` 悬空导致 `RW_Done && !ack` 不成立），**符合预期** |
| 接上模块后 `led[0]` 常亮 | I2C 通、模块在 ACK → 配置成功 |

> 顺便说明：`init_done` 不拉高**不会**影响显示链和 UART ——
> 它只卡住 `aud_rst_n`（音频 + FFT + 频谱）。这正是当前架构"解耦"的好处。

**7. 实测结果（2026-09-29，全部通过）**

| 项 | 结果 |
| --- | --- |
| JTAG | `Digilent/210251170403` → `xc7a100t` IDCODE 认到 ✅ |
| 烧写 | `top.bit` 下载成功 ✅（当时 1258 KB，现约 2043 KB）|
| `led[1]` 心跳 | 闪烁 ✅ |
| `led[0]` | 不亮（无音频模块，符合预期）✅ |
| LCD 网格背景 | 显示 ✅ |
| UART 自检 | **`通过 21 失败 0`** ✅ |
| **上板抓到 1 个真 bug** | `cmd_proc.v` 状态机中间态卡死 → 已修，见[账本](08-skills-index.md)第 49~51 条 |
| 目视确认 | `V` 视图切换、`A` 自动轮换、`B` 背景切换、KEY2 ✅ |

> ⚠️ **本次上板只验证到"骨架"，可视化本身还是没看到过。**
> `S`/`H`/`G` 三条命令依赖柱高与波形数据，**没有音频就无从体现**；
> 柱状 / 极坐标辐条 / 波形这三块**在硬件上仍是零观察**。
> 这构成一个真实的验证盲区 —— 见 P1-4「演示/自检图案」。

> **这次上板最大的收获**：抓到一个 **TB 完全测不到** 的 bug ✗
> 原因是 TB 测"非法字符"时状态机一直停在 `S_CMD`，
> 而 `S_CMD` 本来就有"其它字符一律忽略" ✗
> **要测中间态，就得先制造中间态** —— 这条已写进 [08](08-skills-index.md) 第 51 条。

---

### P0-B 音频模块到货后再做

- [ ] **接线**：按 `constrs/audio.xdc` 接 JM2（6 根信号线）
  - `aud_bclk` J20 / `aud_lrclk` K18 / `aud_adcdat` H20 / `aud_dacdat` G20 / `aud_scl` K21 / `aud_sda` K22
  - ⚠️ **P1 跳线不要插**（保持 MCLK 来自模块板载晶振）
- [ ] `led[0]` 常亮（I2C 配置完成）
- [ ] 柱状频谱随音乐跳动
- [ ] 极坐标辐条随音乐跳动
- [ ] 波形以中线为轴摆动
- [ ] **音频回环**：耳机听到 EQ 后的声音，改增益档位能听出变化
- [ ] **实测记录**：把 WNS、噪声底、延迟记进 [05](05-synthesis-report.md)

> **可能踩的坑**（提前记下来）：
> - P1 跳线插着 → MCLK 冲突、周期性爆音
> - I2C 不 ACK → 检查上拉电阻（模块上可能没有，需外部 4.7k）
> - 屏幕不出图 → 先量 `lcd_clk` 有没有 12.5 MHz，再量 HS/VS

---

## P1 —— 交互体验（这是"专精"的核心）

### 1. UI 框架三件套（"RTL 版的 LVGL 思路"）

**进度（2026-09-29）**：

- [x] **`ui_anim.v` 属性插值器** ✅ **已完成**
  - 每视图一个 0..128 的"存在度"，每帧走一步，32 帧（≈384 ms）完成过渡
  - 接进显示链：柱高 ×pres/128、波形幅度 ×pres/128、极坐标圆盘**整体**缩放
  - 效果：按 KEY1 切视图预设时不再是硬跳，而是**平滑地长出来 / 缩回去**
  - 代价：+182 LUT（两个按比例缩放的乘法）✗ `clk_pix` WNS 从 +43.6 → +37.7 ns，裕量仍巨大
  - 验证：`tb_ui_anim`（单调/上下限/帧门控/反向，5 项）+ `tb_disp_top` 130560 像素逐点一致
- [x] **顺手补了历史遗漏**：`ui_mode` / `ui_style` / `ui_view` / `ui_hue_spd`
  这四路都是 `clk_sys` 寄存器却在 `clk_pix` 域被直接用，**没有任何同步器** ✗
  已加 2 级 `cdc_sync`（多比特同时翻转仍可能采到中间态，但只在帧起始采样一次，概率可忽略）
- [x] **P3 点阵字库** ✅ **已完成**（2026-09-29，与 UI 一起做的）
  - `scripts/golden/gen_font.py`：用 **ASCII 艺术字**定义 43 个字符（0-9 A-Z + 空格 . : - = % /）
    ✗ 肉眼可校对 ✗ 生成 `rtl/video/font_rom.v`（5x7 点阵，**只要 69 LUT / 0 FF**）
  - `rtl/video/text_buf.v`：字符缓冲 + 位置换算 + 查字库，全程组合，不给画面引入错位
  - `rtl/video/status_line.v`：把配置拼成 `V7 S0 H6 G8 B0 D0`（**与 UART 回执同格式**）
    ✗ 只在配置变化时重写，不每帧刷 ✓
  - `disp_mix` 最上层叠加：字形近白 ✗ 底板是**半透明**的（背景压到 1/4 ✓）不是死黑框 ✓
  - 验证：`tb_font_rom`（形状/索引/列方向/行距/越界）+ `tb_text_buf`（框内外/留白/空格/未写格子）
    + `tb_status_line`（内容/按需刷新/十六进制）+ `tb_disp_top` 130560 像素逐点一致
- [x] **`ui_layer.v` 按钮层** ✅ **已完成**（2026-10-04）
      `rtl/video/ui_layer.v`：底部一条 6 按钮操作带（`y=234..271`，每个 78x38）
      · 表驱动：位置/尺寸/动作码放表里，加按钮只动表
      · **渲染与命中同源**（共用同一套边界判据，TB 交叉验证范围完全一致）
      · 每个按钮带标签（内置小 ROM + 复用 `font_rom`）：`VIEW STYLE HUE GAIN BG DEMO`
      · 配色优先级：按下 > 生效 > 普通；标签在深底上用亮字、在亮底上用深字
      · 代价：柱状区从 96 px 压到 58 px，柱高系数随之改为 `bh*29/256`
- [x] **按钮 → 配置** ✅ `ui_ctrl` 新增"步进"输入（旋钮式调节，按字段各自的有效范围递增）
- [x] **`T04` 演示扫描** ✅ **不用触摸硬件就能看到 UI 工作**
      虚拟光标每 0.32 s 换一个按钮并"按下"，高亮保持约 1.3 s
- [x] **端到端判据** ✅ `tb_top` 里接 XPT2046 行为模型，"按"到 GAIN 按钮 ->
      `cfg_wave_gain` 必须变。**这条判据补上了 `[82][83]` 两处 bug 的漏检**
- [x] **短按判据** ✅ 只按 6 ms 也必须被采到 —— 专门守"轮询丢事件"（账本 [84]）。
      已独立验证：轮询 5 ms -> PASS，改回 10 ms -> FAIL
- [ ] **触摸坐标正式标定**（等 U2 焊好）：现在的 `raw>>3 / raw>>4` 只是临时线性映射，
      阈值 `16..4080` 也只是"没卡在轨上"的粗判
- ✅ **已知且接受**：`DEMO` 按钮会把演示模式切走。
      在 `T04`（演示扫描）下按到它，扫描就停了 —— 因为它的功能本来就是切 `cfg_demo`。
      **决定不处理**：它就是个测试按钮，而且"切走"这个行为本身也说明按钮工作正常。
      （真要改的话，让 `DEMO` 只在 `T01~T03` 之间轮转、跳过 `T04` 即可。）
- [x] **状态行改成可读标签** ✅ `VIEW 7 / STYLE 0 / HUE 6 / GAIN 8 / BG 0 / DEMO 0`
      + `TX4095` + `E0007 L1`，共 8 行。文本框缩到 80 px 宽（原来 160）
- [x] **可折叠操作面板** ✅ **2026-10-04**
      · 右侧常驻一个 **16x24 的小三角把手** ✗ 折叠时朝右（▶）✗ 展开时朝左（◀）✗ 点它切换
      · 面板用 `ui_anim` 第 4 通道驱动 ✗ **从底部平滑滑出/滑回**（384 ms）
      · **空闲 4 秒自动收起** ✗ 任何触摸都会重置计时
      · **柱状区恢复全高 96 px** ✗ 柱高系数回到 `bh*3/16` ✓
      · 渲染与命中**共用同一个运行时 `ui_by0`** ✗ 动画中间帧也不会错位
- [x] **波形改成示波器式"触发采集"** ✅ **2026-10-04**
      · 原来 `wave_buf` 是**滚动窗口**（永远显示最近 480 个点）✗ 帧周期 12 ms 里写指针走 577 个点
        → 每帧错开 97 个点 → **画面一直向左滚**（对周期性信号尤其难看）
      · 改成**向上过零触发**：从"向上过零那一刻"开始抓 480 个点
        → 周期性信号每次抓到的相位相同 → **画面静止，零点固定**
      · **迟滞**（先低于 `-TH` 才允许触发）✗ 挡掉零点附近的噪声误触发
      · **自动触发兜底**（`TO_MAX`=2048 采样 ≈ 43 ms）✗ 信号太弱/有直流时不会永久冻屏
      · **双 bank 乒乓**（`AW=10` 深度 1024 ✗ 每屏只用 480 ✗ 两块 512 的 bank **白送**）
        + `done_tog`/`rd_tog` 两个 1 bit 握手 ✗ 读侧永远读到完整一帧，不撕裂
      · `tb_wave_buf` 6 项全 PASS ✗ **判据③"连续两帧逐点相同"就是"不滑动"本身**
- [x] **直流阻断**（`rtl/common/dc_block.v`）✅ **2026-10-04**
      · `y[n] = x[n] - x[n-1] + y[n-1]·(1 - 2^-SH)` ✗ **零 DSP**（一个移位 + 一个减法）
      · `SH=10` → 截止 **7.46 Hz** ✗ 时间常数 **21.3 ms** ✗ **+94 LUT / 0 DSP**
      · 插在 `top.v` 的波形 mux **之前** ✗ 演示图案不受影响 ✗ `disp_top` 一行不改
      · `tb_dc_block` **7 项全 PASS**（τ 处 0.3685 ✓ 5τ 残差 0.26% ✓ 通带 1.00043 ✓）
      · **真实用例实测**：输入中点 2097152 → 输出中点 **514** ✓
      · 并已验证判据有鉴别力（删掉 `- ysh` → 恰好挂 5 项 ✓ 而"通带/幅度"两项正确地不挂 ✓）
- [x] **波形平滑 FIR**（`rtl/common/fir_sym.v`）✅ **2026-10-04**
      · 15 抽头**对称**（线性相位）Hamming 窗 sinc 低通 ✗ 截止 **5.76 kHz**（-6 dB）
      · **为什么必须线性相位**：非线性相位会让各频率分量错开不同时间，
        波形**形状被扭歪** ✗ 对称 FIR 只等价于整体延迟 7 个采样（0.15 ms ✓ 无感）
      · **为什么全并行**：48 kHz 采样 / 48 MHz 时钟 = 每采样 1000 拍。
        串行复用 1 个 DSP48 更省 ✗ 但要状态机 + RAM 变址 ✗ 复杂度高。
        全并行 **8 个 DSP48**（共 240）换纯组合 ✗ 一眼看懂 ✓
      · 系数由 `scripts/golden/gen_wave_fir.py` 生成 → `fir_sym_coeff.vh`
      · `tb_fir_sym` **6 项全 PASS** ✗ 核心判据是**脉冲响应逐点等于系数**
        （期望值**硬编码**在 TB 里 ✗ 不引用生成的 .vh ✗ 否则是拿 RTL 验 RTL）
      · 实测 20 kHz **-54.39 dB = 理论值**（Python 独立算的）✗ 精确吻合
      · 接线：`rx_l → dc_block → fir → 波形 mux`（都在 `top.v` ✗ `disp_top` 一行不改）
- [x] **自适应触发门限**（`rtl/common/env_track.v`）✅ **2026-10-04**
      · 解决：`TH` 固定成满量程 1/64 ✗ **小信号永远碰不到 -TH**（只能靠自动触发，画面一直跳）
        ✗ 大信号门限相对太小 ✗ 噪声也能骗过迟滞
      · 做法：**门限 = 包络 >> 3** ✗ 快攻（AS=6 ✗ 1.3 ms）慢放（DS=12 ✗ 85 ms）
      · ⚠️ **必须有下限 `TH_MIN`=4096**：静音时包络→0 ✗ 门限→0 ✗
        "低于 -TH"退化成"小于 0" ✗ 一点底噪就疯狂触发 ✗ **这是自适应门限最典型的坑**
      · 零 DSP（取绝对值 + 两个移位 + 加减）✗ 接线：`fir → env_track → disp_top.wave_th`
      · 放在 FIR **之后**：包络要跟踪"真正拿去显示的那个信号"✗
        放前面的话单点毛刺会把包络顶高
      · `tb_env_track` **5 项全 PASS** ✗ 核心判据③是"小信号门限自动跟着变小"
- [x] **频谱 sqrt 显示**（`spectrum.v` 的 `SQRT_SCALE_SH`）✅ **2026-10-04**
      · **关键洞察**：`20·log10(√x) = 10·log10(x)` ✗ **sqrt 在对数域就是减半**
        ✗ 而 `spectrum.v` 本来就在 log2 域算高度 ✗ 所以**不是新算法** ✓
      · 实现：`SCALE_SH`（默认 2）改成 **1** 就是 sqrt 显示 ✗ **一个参数** ✓
      · 观感：现在约 60 dB 铺满全高 ✗ sqrt 模式相当于 120 dB 铺满全高
        ✗ 低声压的柱子明显变高（更热闹 ✗ 动态范围被压缩）
      · **默认值保持不变** ✗ 逐位不变、零风险 ✓ 想试就改实例化参数 ✓
      · 要做成"运行时可切"的话 ✗ 再把它接成 `ui_ctrl` 的一个寄存器位即可
- [ ] **频谱 sqrt 显示**（下一步 ✗ 有个"零成本"做法）⏸
      · **关键洞察**：`sqrt` 在对数域里就是**减半**（`20log10(√x) = 10log10(x)`）
      · `spectrum.v` 已经算出了 log2 ✗ 所以"开根号"≈**把 dB 刻度拉长一倍**
        ✗ 不是新算法 ✗ 只是改 `DB_OFFS`/`SCALE_SH` 或加一个模式位 ✓
      · 观感差异：现在 60 dB 铺满全高；sqrt 模式下相当于 120 dB 铺满全高
        ✗ 低声压的柱子会明显变高 ✓
- [x] **波形正负方向翻正** ✅ **2026-10-04**
      · 原来 `wave[23] ? (CY-amp) : (CY+amp)` → **负值画在上方**（和示波器相反）
      · 改成 `wave[23] ? (CY+amp) : (CY-amp)` → **正值朝上** ✓
      · 上下对称的波形看不出来 ✗ 但**非对称波形一眼就不对**（"先上后下"会变"先下后上"）
      · **验证手法**：先只改 DUT 跑一遍 → `tb_disp_top` 报 **2528 处**不符
        → 证明参照模型确实在验这个 ✗ 再同步参照 → PASS ✓（账本第 96 条）
      · 顺手修掉 `disp_mix` 头部注释里的陈旧数字（"振幅 ±26" 实际是 22）
- [ ] **`ui_style.v`** ⏸ 主要是重构（配色集中管理），视觉零变化
- [x] **状态行改成可读标签** ✅ `VIEW 7 / STYLE 0 / HUE 6 / GAIN 8 / BG 0 / DEMO 0`
      + `TX4095` + `E0007 L1`，共 8 行。文本框缩到 80 px 宽（原来 160）
- [x] **可折叠操作面板** ✅ **2026-10-04**
      · 右侧常驻一个 **16x24 的小三角把手** ✗ 折叠时朝右（▶）✗ 展开时朝左（◀）✗ 点它切换
      · 面板用 `ui_anim` 第 4 通道驱动 ✗ **从底部平滑滑出/滑回**（384 ms）
      · **空闲 4 秒自动收起** ✗ 任何触摸都会重置计时
      · **柱状区恢复全高 96 px** ✗ 柱高系数回到 `bh*3/16` ✓
      · 渲染与命中**共用同一个运行时 `ui_by0`** ✗ 动画中间帧也不会错位
- [x] **波形改成示波器式"触发采集"** ✅ **2026-10-04**
      · 原来 `wave_buf` 是**滚动窗口**（永远显示最近 480 个点）✗ 帧周期 12 ms 里写指针走 577 个点
        → 每帧错开 97 个点 → **画面一直向左滚**（对周期性信号尤其难看）
      · 改成**向上过零触发**：从"向上过零那一刻"开始抓 480 个点
        → 周期性信号每次抓到的相位相同 → **画面静止，零点固定**
      · **迟滞**（先低于 `-TH` 才允许触发）✗ 挡掉零点附近的噪声误触发
      · **自动触发兜底**（`TO_MAX`=2048 采样 ≈ 43 ms）✗ 信号太弱/有直流时不会永久冻屏
      · **双 bank 乒乓**（`AW=10` 深度 1024 ✗ 每屏只用 480 ✗ 两块 512 的 bank **白送**）
        + `done_tog`/`rd_tog` 两个 1 bit 握手 ✗ 读侧永远读到完整一帧，不撕裂
      · `tb_wave_buf` 6 项全 PASS ✗ **判据③"连续两帧逐点相同"就是"不滑动"本身**
- [x] **直流阻断**（`rtl/common/dc_block.v`）✅ **2026-10-04**
      · `y[n] = x[n] - x[n-1] + y[n-1]·(1 - 2^-SH)` ✗ **零 DSP**（一个移位 + 一个减法）
      · `SH=10` → 截止 **7.46 Hz** ✗ 时间常数 **21.3 ms** ✗ **+94 LUT / 0 DSP**
      · 插在 `top.v` 的波形 mux **之前** ✗ 演示图案不受影响 ✗ `disp_top` 一行不改
      · `tb_dc_block` **7 项全 PASS**（τ 处 0.3685 ✓ 5τ 残差 0.26% ✓ 通带 1.00043 ✓）
      · **真实用例实测**：输入中点 2097152 → 输出中点 **514** ✓
      · 并已验证判据有鉴别力（删掉 `- ysh` → 恰好挂 5 项 ✓ 而"通带/幅度"两项正确地不挂 ✓）
- [x] **波形平滑 FIR**（`rtl/common/fir_sym.v`）✅ **2026-10-04**
      · 15 抽头**对称**（线性相位）Hamming 窗 sinc 低通 ✗ 截止 **5.76 kHz**（-6 dB）
      · **为什么必须线性相位**：非线性相位会让各频率分量错开不同时间，
        波形**形状被扭歪** ✗ 对称 FIR 只等价于整体延迟 7 个采样（0.15 ms ✓ 无感）
      · **为什么全并行**：48 kHz 采样 / 48 MHz 时钟 = 每采样 1000 拍。
        串行复用 1 个 DSP48 更省 ✗ 但要状态机 + RAM 变址 ✗ 复杂度高。
        全并行 **8 个 DSP48**（共 240）换纯组合 ✗ 一眼看懂 ✓
      · 系数由 `scripts/golden/gen_wave_fir.py` 生成 → `fir_sym_coeff.vh`
      · `tb_fir_sym` **6 项全 PASS** ✗ 核心判据是**脉冲响应逐点等于系数**
        （期望值**硬编码**在 TB 里 ✗ 不引用生成的 .vh ✗ 否则是拿 RTL 验 RTL）
      · 实测 20 kHz **-54.39 dB = 理论值**（Python 独立算的）✗ 精确吻合
      · 接线：`rx_l → dc_block → fir → 波形 mux`（都在 `top.v` ✗ `disp_top` 一行不改）
- [x] **自适应触发门限**（`rtl/common/env_track.v`）✅ **2026-10-04**
      · 解决：`TH` 固定成满量程 1/64 ✗ **小信号永远碰不到 -TH**（只能靠自动触发，画面一直跳）
        ✗ 大信号门限相对太小 ✗ 噪声也能骗过迟滞
      · 做法：**门限 = 包络 >> 3** ✗ 快攻（AS=6 ✗ 1.3 ms）慢放（DS=12 ✗ 85 ms）
      · ⚠️ **必须有下限 `TH_MIN`=4096**：静音时包络→0 ✗ 门限→0 ✗
        "低于 -TH"退化成"小于 0" ✗ 一点底噪就疯狂触发 ✗ **这是自适应门限最典型的坑**
      · 零 DSP（取绝对值 + 两个移位 + 加减）✗ 接线：`fir → env_track → disp_top.wave_th`
      · 放在 FIR **之后**：包络要跟踪"真正拿去显示的那个信号"✗
        放前面的话单点毛刺会把包络顶高
      · `tb_env_track` **5 项全 PASS** ✗ 核心判据③是"小信号门限自动跟着变小"
- [x] **频谱 sqrt 显示**（`spectrum.v` 的 `SQRT_SCALE_SH`）✅ **2026-10-04**
      · **关键洞察**：`20·log10(√x) = 10·log10(x)` ✗ **sqrt 在对数域就是减半**
        ✗ 而 `spectrum.v` 本来就在 log2 域算高度 ✗ 所以**不是新算法** ✓
      · 实现：`SCALE_SH`（默认 2）改成 **1** 就是 sqrt 显示 ✗ **一个参数** ✓
      · 观感：现在约 60 dB 铺满全高 ✗ sqrt 模式相当于 120 dB 铺满全高
        ✗ 低声压的柱子明显变高（更热闹 ✗ 动态范围被压缩）
      · **默认值保持不变** ✗ 逐位不变、零风险 ✓ 想试就改实例化参数 ✓
      · 要做成"运行时可切"的话 ✗ 再把它接成 `ui_ctrl` 的一个寄存器位即可
- [ ] **频谱 sqrt 显示**（下一步 ✗ 有个"零成本"做法）⏸
      · **关键洞察**：`sqrt` 在对数域里就是**减半**（`20log10(√x) = 10log10(x)`）
      · `spectrum.v` 已经算出了 log2 ✗ 所以"开根号"≈**把 dB 刻度拉长一倍**
        ✗ 不是新算法 ✗ 只是改 `DB_OFFS`/`SCALE_SH` 或加一个模式位 ✓
      · 观感差异：现在 60 dB 铺满全高；sqrt 模式下相当于 120 dB 铺满全高
        ✗ 低声压的柱子会明显变高 ✓
- [x] **波形正负方向翻正** ✅ **2026-10-04**
      · 原来 `wave[23] ? (CY-amp) : (CY+amp)` → **负值画在上方**（和示波器相反）
      · 改成 `wave[23] ? (CY+amp) : (CY-amp)` → **正值朝上** ✓
      · 上下对称的波形看不出来 ✗ 但**非对称波形一眼就不对**（"先上后下"会变"先下后上"）
      · **验证手法**：先只改 DUT 跑一遍 → `tb_disp_top` 报 **2528 处**不符
        → 证明参照模型确实在验这个 ✗ 再同步参照 → PASS ✓（账本第 96 条）
      · 顺手修掉 `disp_mix` 头部注释里的陈旧数字（"振幅 ±26" 实际是 22）
- [ ] **`ui_style.v`** ⏸ 主要是重构（配色集中管理），视觉零变化

> ⚠️ **不是移植 LVGL**。LVGL 依赖动态内存 + CPU 顺序执行，RTL 里没有这些概念。
> 要做的是**它擅长的三件事**，用 RTL 的方式实现：

- [ ] **`ui_layer.v` —— 图层表驱动**
  ```verilog
  // 现在 disp_mix 里是硬编码的 if 链，加图层要改混合逻辑
  // 改成表：{使能, z序, 颜色源, 覆盖掩码}，按 z 序归约
  ```
  收益：加新图层（峰值标记、刻度线、歌词）只改一张表

- [ ] **`ui_anim.v` —— 属性插值器** ⭐ **最出彩的一个**
  ```
  from_reg ─┐
            ├─▶ [插值] ─▶ 当前值 ─▶ 图层
  to_reg   ─┘      ▲
                   └─ t = cnt/dur
  ```
  能做的效果：
  - 按键切视图时**淡入淡出**（alpha 0→255）
  - 极坐标**从圆心展开**（R_MAX 0→62）
  - 色相滚动**加速/减速**
  - 换频率分组方案时柱高**平滑过渡**

- [ ] **`ui_style.v` —— 样式寄存器化**
  颜色/透明度/线宽从 `ui_ctrl` 来，配合 UART 就能在电脑上调配色

**估算**：三者合计约 **400~600 LUT + 1~2 DSP**（当前只用 10.7%，放得下）

### 2. 触摸屏 XPT2046

**进度（2026-10-04）**：

- [x] **管脚反推** ✅ `37=nCS / 38=DOUT / 39=DCLK / 40=DIN` -> `E19 / B20 / D19 / A20`
      （证据链见 [06](06-board-resources.md) §6b 与 `constrs/touch.xdc` 注释）
- [x] **SPI 驱动** ✅ `rtl/touch/xpt2046.v` + 行为模型 + 6 项 TB，27/27 PASS
- [x] **上板诊断通道** ✅ 状态行第二/三行实时显示原始读数与诊断量：
      ```
      V7 S0 H6 G8 B0 D0
      TX4095 TY4095          <- 原始读数（4 位十进制）
      E0000 L0               <- E: DOUT 跳变次数   L: 是否见过低电平
      ```
- [x] ✅ **已定位（2026-10-04）：子卡上的 XPT2046（U2）根本没焊**，R10 也是 NC。
      这是"触摸电路可选焊"的子卡。诊断量 `L0 + E0000` 精确指向了这一点。
  - [ ] **待你焊上 U2**（XPT2046，SSOP-16/TSSOP-16）
  - ✅ **R10 可以不焊**：固件已改用 `PD=11`（内部参考），命令 `0xDC/0x9C`
  - [ ] 焊完后重新烧板，状态行第三行应从 `E0000 L0` 变成 `E00xx L1`
- [ ] **坐标校准**（拿到原始读数后才谈得上）
- [ ] **工控屏式触摸界面**（按钮 + 参数调节）

**原始需求**（下面这段保留作为背景）：

- [ ] `rtl/control/spi_master.v` —— 通用 SPI 主机
- [ ] `rtl/control/xpt2046.v` —— 读 X/Y + 中断处理 + 消抖
- [ ] 触摸校准（两点/四点）
- [ ] 交互设计：
  - 拖动调 EQ 增益（比按键直观得多）
  - 点击切换视图
  - 滑动调色相速度

> 比按键有趣得多，是"体验提升"性价比最高的一项

### 3. **HDMI 输出 —— 可视化展示大屏** ⭐

> **动机**：480×272 液晶太小，演示不够醒目。LCD 当交互界面，HDMI 当展示大屏，两路同步。
> 硬件已核实：板上 HDMI 是 **FPGA 差分对直连**（无发送芯片），
> 所以 TMDS 得自己做 —— 但它是纯组合逻辑 ✓ 详见 [06](06-board-resources.md) §6。

**分三步走，不要一次到位：**

- [x] **3a. 显示链坐标参数化** ✅ **2026-09-29 完成（第一步）**

  **做完了什么**（保持 480×272 下**逐位不变**，用 `tb_disp_top` 的 130560 像素比对守住）：
  - `disp_top`：LCD 时序参数（`H_SYNC/H_BACK/H_FRONT/V_SYNC/V_BACK/V_FRONT`）
    从例化处提到**参数表**；派生 `XW`/`YW`（写在参数表里 ✗ 账本第 24 条）
  - `bg_src` / `disp_mix` / `wave_buf` / `polar_map`：`x`/`y` 端口位宽全部参数化
  - `disp_mix` / `polar_map` 内部所有**布局推导的位宽**跟着走
    （`AW`/`CW`/`RADW`/`BAR_SH`…）
  - 综合实测 **6048 → 6021 LUT**、DRC 0、`clk_sys` WNS +2.292 ns —— 确认是纯重构

  **⚠️ 还没做、换分辨率前必须补的**（别以为"改个参数就行"）：
  | 项 | 问题 |
  | --- | --- |
  | **布局常数** | `disp_cfg.vh` 还是 480×272 的**绝对值**（圆心 240/78、半径 16/62 …）✗ 换分辨率要定**缩放规则** |
  | **`polar_map` 的几何** | 7 条 tan 边界按 /64 取整、`R_MAX` 的半径映射，都是按这套尺寸推的 ✗ 换尺寸要**重新推导**，不是改参数 |
  | **柱映射 `BAR_SH`** | 原来是 `x[8:3]`（480/60 = 8 ✗ 恰好是 2 的幂 ✗ 零成本）✗ 但 **1280/60 = 21.33 不是整数也不是 2 的幂** ✗ 必须改柱数、或用小 ROM 做除法 |
  | **柱高→像素系数** | `bh*3/16` 是按 `BARS_H=96` 算的 ✗ 换布局要重算 |
  | **第二个 `wave_buf` 读口** | BRAM 只有 2 个端口（1 写 1 读）✗ 两路显示要**两份 BRAM** 或用更宽的排布 |

- [ ] **3b. `tmds_encoder.v`** —— 8b/10b 纯组合编码（约 150 LUT × 3 通道）
  用 XOR/XNOR 链做最小化翻转 + running disparity 做 DC 平衡
  > 可以用 `sim/tb/tb_tmds_encoder.v` 穷举 256 个字节 × 两种 disparity 验证

- [ ] **3c. `hdmi_timing.v` + `hdmi_tx.v`** —— **先从 800×600@60 起步**（5× 时钟只 200 MHz）
  时序发生器 + `OSERDESE2`(5:1 DDR) + `OBUFDS`
  跑通后再冲 **1280×720@60**（5× = 371.25 MHz，需要第二个 MMCM）

- [ ] **3d. 第二路 MMCM**：`D=5, M=18.5625 → VCO 742.5 → 74.25 / 371.25 MHz`

- [ ] **3e. 两个输出可以有不同的布局**
  LCD 上做"简洁交互界面"（大按钮、当前参数、频谱预览）
  HDMI 上做"炫技版"（满屏频谱 + 极坐标 + 波形 + 动画）

**⚠️ 上板前要确认的**（见 [06](06-board-resources.md) §6.5）：
- [ ] Bank 14 的 Vcco 是不是 3.3V（`TMDS_33` 的硬性要求）
- [ ] `HDMI_OUT_EN`(V22) 的极性
- [ ] `HDMI_CEC` 到底是 `W22` 还是 `U17`（原理图两页自相矛盾，见 §6.3）
      —— 我们不用 CEC，所以**只影响 LED1 的位置**

### 4. **演示 / 自检图案** ✅ 已完成

> **为什么做**：上板实测发现 `S` / `H` / `G` 三条命令**依赖音频数据才能看出效果** ✗
> **柱状 / 极坐标辐条 / 波形这三块在硬件上一直是零观察** ✗
> 而显示链是全工程最复杂的一块（130560 像素 / 扫描到哪算哪 / 无 framebuffer）✗

**实现**：`rtl/video/demo_src.v` + UART 命令 `T`

| 命令 | 图案 | 用途 |
| --- | --- | --- |
| `T00` | 关（上电默认，走真实音频）| |
| `T01` | **斜坡** `bar[i] = i*8` | 屏幕上应是一条**笔直斜线** —— 柱序 / 高度标度 / 镜像一眼可判 |
| `T02` | **棋盘** 奇 448 / 偶 32 | 验证**柱宽与间隙**：8px 算错会出现"该空的没空" |
| `T03` | **移动包络** | 看起来像频谱，验证动画、色相滚动、帧内一致性 |

**更新速率**（上板返工过一次，见[账本](08-skills-index.md)第 56 条）：
`TICK_B=20` → **21.85 ms 一帧**（约 LCD 帧周期 12.01 ms 的 1.8 倍），
`PH_STEP=1` → 峰值 **1.31 s 扫完一圈**。
> 第一版取 2.73 ms + 步进 3，比显示刷新快 4.4 倍，屏幕上一片糊。
> **更新得比显示刷新快是纯浪费** —— 那些帧根本没人看到。

**接线方式**：在 `top.v` 里给频谱和波形各挂一个 2:1 mux ✗
**真实模块一行不改** ✓ `T00` 时完全旁路 ✓

**验证**：
- `tb_demo_src.v`（7 项：三种图案 + 契约一致性 + 更新周期 + 波形速率/幅度/形状）
- `tb_top.v` 加了 **T01 端到端**：串口发命令 → 查 mux 之后的柱高线是否为斜坡
- 全部 **21/21 PASS**

**实测代价**（记下来，别以后惊讶）：
- `demo_src` 本体 **72 LUT / 436 FF**
- 整机 5598 → **6043 LUT（9.53%）**
- 差额约 395 LUT 是**那个 540 位宽的旁路 mux**（60 柱 × 9 位）
- 「完全旁路、零影响」承诺的代价就在这 ✗ 当前 90% 资源空着，不值得为省它做侵入式改动

**过程中抓到 3 个 bug**（账本 52/53/54）：多重驱动（**只有综合器抓到**）、连环重算、宽 mux 与并行 `for` 的 LUT 爆炸 ✗

> ✅ **已确认不做按键入口**（2026-09-29）：这只是演示功能，
> WM8960 模块到位后就不太需要了。经 UART 开即可。

### 5. EQ 参数实时可调

- [ ] `eq_coeff_rom` 的地址从 `ui_ctrl` 来（现在 `band_gain` 是常数）
- [ ] UART 命令：`E <频段> <档位>` 直接调某个频段的增益
- [ ] 显示层加一个"当前 EQ 曲线"图层

---

## P2 —— 背景图（扩展点①）

- [ ] `rtl/video/bg_img.v` —— 流式背景源
  - 存储：**QSPI Flash W25Q128（16 MB）** → 480×272×2B = 261 KB/张 → **可存 60 张**
  - 或 SD 卡（**管脚待核实**，见 [06](06-board-resources.md) §10）
- [ ] `rtl/common/line_buf.v` —— 行缓冲
  > **为什么必须行缓冲**：每行扫描 480 拍，消隐期只有 45 拍，**来不及预取一整行**。
  > 必须在"上一行显示期间"预取下一行 —— 行缓冲（1 个 BRAM18，960 B）能把时序彻底解耦。
- [ ] 与频谱混合（`ui_layer` 的 `blend` 分支：实心/半透明/强光）
- [ ] 按键/UART 切换背景图

---

## P3 —— 锦上添花（有余力再说）

- [ ] **点阵字库**：在屏幕上显示"EQ: +3dB @ 1kHz"之类的文字
  > RTL 里做法是点阵 ROM + 位选，**排版必须编译期定好**（不能像 LVGL 那样运行时换行）
- [ ] **自动增益显示范围（AGC）**：根据最近 N 帧的最大幅度自动调整 dB 偏移
- [ ] **频谱峰值保持线**：每根柱记录"最近 1 秒的最高点"，画一条小横线
- [ ] **多配色主题**：彩虹 / 火焰 / 冰蓝 / 单色，UART 和按键都能切
- [ ] **EQ 频响曲线可视化**：把 5 段 IIR 的理论频响画成曲线叠加在频谱上
- [ ] **录制/回放**：把采样存进 Flash，做"频谱回放"演示（不用现场放音乐）

---

## 明确**不做**的

| 想法 | 为什么不做 |
| --- | --- |
| **HDMI 视频*输入*** | 不产生新能力（频谱叠加和现在等价），资源陡增；本板也没有 HDMI IN 通道。详见 [01](01-architecture.md) §8.1<br>（**注意：HDMI *输出* 保留**，见 P1-3） |
| **CEC / HDMI 音频 / HDCP / InfoFrame** | 我们只做 TMDS = DVI 输出，这些 HDMI 辅助协议都不需要 ✓ 大幅简化 |
| **移植真正的 LVGL** | 要放软核 CPU + framebuffer，违背纯 RTL 约束，且丢掉"扫描到哪算到哪"的性能优势 |
| **运行时动态创建控件** | RTL 里没有指针/动态内存，物理上做不到。控件个数综合前定死 |
| **通用布局引擎（flex/grid）** | FPGA 的正确做法是"编译期算好布局 + 参数化"，不是运行时算 |
| **部分刷新（脏矩形）** | 本架构**没有 framebuffer**，每个像素只在被扫描时算一次 —— 已经在做最彻底的局部计算了 |

---

## 🔖 当前进度与下一步（交接点）

> 最近一次更新：**2026-09-29**（P0-A 上板验证完成）

### 已经做完的

| 阶段 | 状态 |
| --- | --- |
| 音频链路（I2S / EQ / FFT / 频谱 / 显示 / 交互 / UART） | ✅ 完成，**41/41 TB PASS** |
| **P0-A 上板（不含音频）** | ✅ 完成 —— JTAG、LED、LCD 背景、UART、按键全部目视确认 |
| **P0-B 音频验证** | ✅ **完成** —— 话筒 / EQ / 双声道 / 静音 / 回环全部实测有效 |
| **SD 卡子系统** | ✅ 完成 —— 初始化 5/5、CMD18 多块 4/4、帧缓冲、切图循环 |
| **LCD 交互界面** | ✅ 完成 —— 8 按钮 + 8 行状态栏 + 双背景 + SD 图片满屏 |
| **HDMI 大屏** | ✅ 完成 —— 640×360、80 根独立柱、波形、SD 图片（裁剪 2× 放大）|
| **Flash 固化** | ✅ 完成 —— QSPI x4，`program.tcl -tclargs flash`，43 秒，掉电可启动 |
| **构建质量** | ✅ **0 CRITICAL / 0 WARNING**，`clk_sys` +1.779 / `clk_hdmi` +4.028 ns |
| **问题账本** | **816 条** |
| **文档** | `docs/01`~`docs/16` |

### 待做（按优先级）

| # | 事项 | 说明 |
| --- | --- | --- |
| 1 | ~~P0-B 音频验证~~ | ✅ **已完成** —— 话筒/EQ/双声道/静音/回环实测有效 |
| 2 | ~~P1-4 演示/自检图案~~ | ✅ **已完成**（2026-09-29），`T01`~`T03` 已上板 |
| 3 | ~~P1-3a `render_core` 参数化~~ | ✅ **已完成** —— `disp_top` 加 `WITH_UI`/`WITH_TEXT`/`FB_*` 参数 |
| 4 | ~~P1-3b/c/d HDMI 输出~~ | ✅ **已完成** —— 640×360@25 MHz，80 根独立柱 + 波形 + 图片背景 |
| 5 | ~~P1-1 UI 三件套~~ | ✅ **已完成** —— 8 按钮面板 + 8 行状态栏 + 双背景 |
| 6 | ~~线路输入~~ | ⚠️ **代码就绪，硬件受限** —— `C4`(1µF) 开路，需补焊 |
| 7 | **HDMI 复位后偶尔右半屏撕裂** | ⭐⭐⭐ **下一步**。DEMO 模式也复现 ⟹ TMDS 层，需 ILA / 示波器 |
| 8 | **HDMI 2× 放大像素化** | ⭐⭐ 方案已写（[16](16-hdmi-smooth-plan.md)），未实施 |
| 9 | **`set_clock_groups` 约束债** | ⭐ 需 `create_generated_clock` 显式命名 HDMI 时钟 |
| 10 | P1-2 触摸屏 | 低优先 —— 模块无触摸层（`TM043NDH02` vs `TM043NBH02`）|

### 待决策 / 待补的小事

| # | 事项 | 状态 |
| --- | --- | --- |
| 1 | **`G`（wave_gain）是死控件** | ✅ **已修**（2026-09-29）。接在 `wave_buf → disp_mix` 之间：带饱和的 `wave*G/8`，**G=8 是 ×1.0（新默认）**，0 当 8 处理。默认从 3 改成 8 —— 因为原来是死控件，**画面不会因此变化**。账本 61/62 条 |
| 2 | **回执帧里 `B` 只有 1 位 hex** | ✅ **确认这样更合理** —— `B` 本身就两种状态（开/关），
一位 hex 足矣。`A` 和 `T` 暂不加进回执 |
| 3 | 演示模式只能经 UART 开，没有按键入口 | ✅ **确认不做**（只是演示功能，模块到位后不需要）|
| 4 | 多重驱动检查缺工具 | ✅ **已解决**：`verilator` 已装，并接进 `run_iv.sh`（账本 52 条）|
| 5 | **`H` 色相速度映射反了**（越大越慢、H00 不是停止、H≥6 被钳死）| ✅ **已修**：改成"越大越快"，默认 2→6（视觉效果不变）—— 账本 55 条 |
| 6 | **`G` 原来是死控件**（能存能读，但不影响画面）| ✅ **已修**：带饱和的 `wave*G/8`，G=8 = ×1.0 —— 账本 61/62 条 |

### 明天开工先跑这三条（确认环境没坏）

```bash
cd ~/WorkFolder/Sonic-Speed-Parallelism

# 1) 全量回归（约 1 分 30 秒，应 41/41 PASS）
bash scripts/sim/run_iv.sh

# 2) lint（应 0 警告）
~/.local/share/nvim/mason/bin/verible-verilog-lint --rules_config_search $(find rtl sim -name '*.v' -o -name '*.vh')

# 3) 板子在不在（应认到 xc7a100t）
vivado -mode batch -source scripts/vivado/program.tcl -tclargs detect
```

### 一次完整重建（约 4 分钟）

```bash
vivado -mode batch -source scripts/vivado/build.tcl \
       -tclargs xc7a100tfgg484-2 top ~/WorkFolder/Sonic-Speed-Parallelism/constrs
vivado -mode batch -source scripts/vivado/program.tcl
```

---

## 交接提示（给以后的自己）

**改任何"全局参数"之前，先列出所有依赖它的地方。**
这个项目已经在同一类问题上栽过 8 次（账本 37/38/41/43 都是这个模式）：

| 改什么 | 连带要改什么 |
| --- | --- |
| 屏幕分辨率 / 布局常数 | `rtl/video/disp_cfg.vh`（**唯一真相源**，RTL 和 TB 都 include 它） |
| 柱数 NBARS | `gen_spectrum_map.py` → 重新生成 ROM；`disp_mix` 的柱宽；`polar_map` 的扇区数；TB 的镜像常量 |
| 时钟频率 | `clk_gen` 的 MMCM 参数；所有用 `CLK_HZ` 的模块参数；`clk_debounce` 的消抖窗口 |
| 模块端口 | 对应的 testbench（**特别是 TB 里镜像的那份参照实现**） |
