flyingyuya/Sonic-Speed-Parallelism/constrs/pa_starlite.xdc

#=============================================================================
# pa_starlite.xdc - 璞致 PA-Starlite（XC7A100T-2FGG484I）板级约束
#-----------------------------------------------------------------------------
# 用于 bring-up 顶层（rtl/top.v）：时钟 + 复位 + 2 个 LED
#
#   时钟  R4/T4   IO_L13P/N_MRCC_34   200MHz 差分，bank34 Vcco=1.5V
#   复位  R14     IO_L19N_14          按键，低有效
#   LED0  W22     IO_L7N_T1_D10_14    高有效
#   LED1  Y22     IO_L9N_T1_DQS_D13_14
#=============================================================================

#-----------------------------------------------------------------------------
# 器件配置属性
#-----------------------------------------------------------------------------
set_property CFGBVS VCCO                      [current_design]
set_property CONFIG_VOLTAGE 3.3               [current_design]
set_property BITSTREAM.GENERAL.COMPRESS true  [current_design]
set_property BITSTREAM.CONFIG.CONFIGRATE 50   [current_design]
set_property BITSTREAM.CONFIG.SPI_BUSWIDTH 4  [current_design]
set_property BITSTREAM.CONFIG.SPI_FALL_EDGE Yes [current_design]

#-----------------------------------------------------------------------------
# 时钟约束
#-----------------------------------------------------------------------------
# 差分时钟只约束 P 端（N 端 Vivado 自动推导）
# 周期 5.000 ns = 200 MHz
create_clock -period 5.000 -name clk_200m [get_ports clk_200m_p]

# 输入时钟的抖动（板载晶振典型值）
set_input_jitter [get_clocks clk_200m] 0.010

#-----------------------------------------------------------------------------
# 管脚约束
#-----------------------------------------------------------------------------
# 200 MHz 差分时钟
set_property -dict {PACKAGE_PIN R4  IOSTANDARD DIFF_SSTL15} [get_ports clk_200m_p]
set_property -dict {PACKAGE_PIN T4  IOSTANDARD DIFF_SSTL15} [get_ports clk_200m_n]

# 复位按键
set_property -dict {PACKAGE_PIN R14 IOSTANDARD LVCMOS33}   [get_ports rst_btn_n]

# LED
set_property -dict {PACKAGE_PIN W22 IOSTANDARD LVCMOS33}   [get_ports {led[0]}]
set_property -dict {PACKAGE_PIN Y22 IOSTANDARD LVCMOS33}   [get_ports {led[1]}]

#-----------------------------------------------------------------------------
# 用户按键
#-----------------------------------------------------------------------------
set_property -dict {PACKAGE_PIN W21 IOSTANDARD LVCMOS33} [get_ports key1_n]
set_property -dict {PACKAGE_PIN Y21 IOSTANDARD LVCMOS33} [get_ports key2_n]

#-----------------------------------------------------------------------------
# UART（板载 CH340E）
#-----------------------------------------------------------------------------
set_property -dict {PACKAGE_PIN P14 IOSTANDARD LVCMOS33} [get_ports uart_rx_pin]
set_property -dict {PACKAGE_PIN P15 IOSTANDARD LVCMOS33} [get_ports uart_tx_pin]
