flyingyuya/Sonic-Speed-Parallelism/rtl/control/cmd_proc.v

//////////////////////////////////////////////////////////////////////////////////
// Company:
// Engineer:       Binyu Fei
//
// Create Date:    2026-10-26
// Design Name:    cmd_proc
// Module Name:    cmd_proc
// Project Name:   音速并行（Sonic-Speed-Parallelism）
// Target Devices: Xilinx Artix-7 XC7A100T-2FGG484I
// Tool versions:  Vivado 2020.2 / iverilog 12 / Verilator 5.052 / Verible
// Description:    cmd_proc.v - UART 命令解析（ASCII）
// Dependencies:
//
// Revision:
// Revision 0.01 - File Created
//
//////////////////////////////////////////////////////////////////////////////////
`timescale 1ns/1ps


module cmd_proc #(
    parameter integer NREG = 6
) (
    input  wire       clk,
    input  wire       rst_n,

    //-------------------- UART 接收 --------------------
    input  wire [7:0] rx_data,
    input  wire       rx_valid,

    //-------------------- UART 发送 --------------------
    output reg  [7:0] tx_data,
    output reg        tx_send,
    input  wire       tx_busy,

    //-------------------- 配置寄存器（读）--------------------
    input  wire [7:0] cfg_view,
    input  wire [7:0] cfg_style,
    input  wire [7:0] cfg_hue_spd,
    input  wire [7:0] cfg_wave_gain,
    input  wire [7:0] cfg_bg_mode,
    input  wire [7:0] cfg_auto,

    //-------------------- 写端口（给 ui_ctrl）--------------------
    output reg        wr_en,
    output reg  [3:0] wr_addr,
    output reg  [7:0] wr_data
);

    //=========================================================================
    // 解析状态机
    //=========================================================================
    localparam [2:0] S_CMD = 3'd0,   // 等字母
                     S_HI  = 3'd1,   // 等高位 hex
                     S_LO  = 3'd2,   // 等低位 hex
                     S_END = 3'd3;   // 等回车

    reg [2:0] st;
    reg [3:0] addr_r;
    reg [7:0] hi_r;

    // 十六进制字符 -> 值；不是 hex 返回 4'hF
    function [3:0] hexval;
        input [7:0] c;
        begin
            if      (c >= "0" && c <= "9") hexval = c - "0";
            else if (c >= "A" && c <= "F") hexval = c - "A" + 4'd10;
            else if (c >= "a" && c <= "f") hexval = c - "a" + 4'd10;
            else                           hexval = 4'hF;
        end
    endfunction

    // 字母 -> 寄存器地址；不认识返回 4'hF
    function [3:0] cmdidx;
        input [7:0] c;
        begin
            case (c)
                "V", "v": cmdidx = 4'h0;
                "S", "s": cmdidx = 4'h1;
                "H", "h": cmdidx = 4'h2;
                "G", "g": cmdidx = 4'h3;
                "B", "b": cmdidx = 4'h4;
                "A", "a": cmdidx = 4'h5;
                // T = 演示/自检图案（rtl/video/demo_src.v）
                "T", "t": cmdidx = 4'h6;
                // I = 音频输入源
                //   I00 = 话筒（板载 MIC，接 LINPUT1）
                //   I01 = 线路输入（3.5mm 座，接 LINPUT3 / INPUTR3）
                "I", "i": cmdidx = 4'h7;
                default : cmdidx = 4'hF;
            endcase
        end
    endfunction

    wire is_term = (rx_data == 8'h0D) || (rx_data == 8'h0A);    // \r 或 \n
    wire is_hex  = (hexval(rx_data) != 4'hF);

    //=========================================================================
    // 回执缓冲（20 字节）
    //    "V07 S00 H02 G03 B0\r\n"        —— 共 18 字符 + CRLF = 20
    //
    //    字段布局（上位机脚本按这个解析）：
    //        [0] 'V'  [1:2] view 2位hex
    //        [3] ' '  [4] 'S'  [5:6] style 2位hex
    //        [7] ' '  [8] 'H'  [9:10] hue_spd 2位hex
    //        [11] ' ' [12] 'G' [13:14] wave_gain 2位hex
    //        [15] ' ' [16] 'B' [17]    bg_mode 【1 位】hex
    //        [18] CR  [19] LF
    //=========================================================================
    reg [7:0] tbuf [0:19];
    integer   ti;

    function [7:0] hexchar;         // 0..15 -> '0'..'F'
        input [3:0] v;
        begin
            hexchar = (v < 4'd10) ? ("0" + v) : ("A" + v - 4'd10);
        end
    endfunction

    task fill_tbuf;
        begin
            tbuf[0] = "V"; tbuf[1] = hexchar(cfg_view[7:4]);
            tbuf[2] = hexchar(cfg_view[3:0]);
            tbuf[3] = " "; tbuf[4] = "S"; tbuf[5] = hexchar(cfg_style[7:4]);
            tbuf[6] = hexchar(cfg_style[3:0]);
            tbuf[7] = " "; tbuf[8] = "H"; tbuf[9]  = hexchar(cfg_hue_spd[7:4]);
            tbuf[10] = hexchar(cfg_hue_spd[3:0]);
            tbuf[11] = " "; tbuf[12] = "G"; tbuf[13] = hexchar(cfg_wave_gain[7:4]);
            tbuf[14] = hexchar(cfg_wave_gain[3:0]);
            tbuf[15] = " "; tbuf[16] = "B"; tbuf[17] = hexchar(cfg_bg_mode[3:0]);
            tbuf[18] = 8'h0D; tbuf[19] = 8'h0A;
        end
    endtask

    //=========================================================================
    // 发送调度：上电发一次横幅，收到 '?' 再发一次
    //=========================================================================
    reg        tx_go;       // 请求发送整个缓冲区
    reg [4:0]  txc;         // 已发到第几个
    reg [31:0] power_cnt;   // 50ms @48MHz = 2.4M，16 位装不下
    reg        did_banner;

    localparam integer BANNER_DLY = 48_000_000 / 1000 * 50;     // 上电 50 ms 后发

    //=========================================================================
    // 主逻辑
    //=========================================================================
    always @(posedge clk) begin
        if (!rst_n) begin
            st         <= S_CMD;
            addr_r     <= 4'd0;
            hi_r       <= 8'd0;
            wr_en      <= 1'b0;
            wr_addr    <= 4'd0;
            wr_data    <= 8'd0;
            tx_data    <= 8'd0;
            tx_send    <= 1'b0;
            tx_go      <= 1'b0;
            txc        <= 5'd0;
            power_cnt  <= 32'd0;        // 和声明一致
            did_banner <= 1'b0;
            for (ti = 0; ti < 20; ti = ti + 1) tbuf[ti] <= 8'h20;
        end else begin
            wr_en   <= 1'b0;
            tx_send <= 1'b0;

            //---------------------------------------------------------------
            // 上电横幅：等 I2C 之类的杂事过去再发，避免抢占
            //---------------------------------------------------------------
            if (!did_banner) begin
                if (power_cnt == BANNER_DLY[31:0] - 1) begin
                    fill_tbuf();
                    tx_go      <= 1'b1;
                    did_banner <= 1'b1;
                end else
                    power_cnt <= power_cnt + 1'b1;
            end

            //---------------------------------------------------------------
            // 解析
            //---------------------------------------------------------------
            if (rx_valid) begin
                case (st)
                    S_CMD: begin
                        if (rx_data == "?") begin
                            fill_tbuf();
                            tx_go <= 1'b1;
                        end else if (cmdidx(rx_data) != 4'hF) begin
                            addr_r <= cmdidx(rx_data);
                            st     <= S_HI;
                        end
                        // 其它字符一律忽略（回车、空白等）
                    end

                    S_HI: begin
                        if (rx_data == "?") begin
                            // '?' 是【全局】命令：命令写了一半也能回读
                            fill_tbuf();
                            tx_go <= 1'b1;
                            st    <= S_CMD;
                        end else if (is_hex) begin
                            hi_r <= {4'd0, hexval(rx_data)};
                            st   <= S_LO;
                        end else begin
                            // 其余非法字符（含 \r/\n）：放弃当前命令，回主态
                            st <= S_CMD;
                        end
                    end

                    S_LO: begin
                        if (rx_data == "?") begin
                            fill_tbuf();
                            tx_go <= 1'b1;
                            st    <= S_CMD;
                        end else if (is_hex) begin
                            // 立刻执行（不必等回车，敲起来更顺手）
                            wr_en   <= 1'b1;
                            wr_addr <= addr_r;
                            wr_data <= {hi_r[3:0], hexval(rx_data)};
                            st      <= S_CMD;
                        end else if (is_term) begin
                            // 只写了一位：当成高 4 位用
                            wr_en   <= 1'b1;
                            wr_addr <= addr_r;
                            wr_data <= {hi_r[3:0], 4'd0};
                            st      <= S_CMD;
                        end else begin
                            st <= S_CMD;    // 同上：非法字符要能脱困
                        end
                    end

                    default: st <= S_CMD;
                endcase
            end

            //---------------------------------------------------------------
            // 发送调度：每次 tx_busy 落下就发下一个字节
            //---------------------------------------------------------------
            if (tx_go) begin
                if (!tx_busy && !tx_send) begin
                    tx_data <= tbuf[txc];
                    tx_send <= 1'b1;
                    if (txc == 5'd19) begin
                        txc   <= 5'd0;
                        tx_go <= 1'b0;
                    end else
                        txc <= txc + 1'b1;
                end
            end
        end
    end

endmodule
