flyingyuya/Sonic-Speed-Parallelism/rtl/fft/fft_twiddle_rom.v

//////////////////////////////////////////////////////////////////////////////////
// Company:
// Engineer:       Binyu Fei
//
// Create Date:    2026-10-26
// Design Name:    fft_twiddle_rom
// Module Name:    fft_twiddle_rom
// Project Name:   音速并行（Sonic-Speed-Parallelism）
// Target Devices: Xilinx Artix-7 XC7A100T-2FGG484I
// Tool versions:  Vivado 2020.2 / iverilog 12 / Verilator 5.052 / Verible
// Description:    fft_twiddle_rom.v - 1024 点 FFT 旋转因子表
// Dependencies:
//
// Revision:
// Revision 0.01 - File Created
//
//////////////////////////////////////////////////////////////////////////////////
`timescale 1ns/1ps


module fft_twiddle_rom (
    input  wire [8:0] addr,      // 0 ~ 511
    output reg  [31:0]     dout       // {imag[15:0], real[15:0]}
);

    always @* begin
        case (addr)
            // ---- k =   0 ~  63   角度    0.0 ~   22.1 度 ----
            9'd0: dout = 32'h00007FFF;   // W^0 = +0.99997 +0.00000j
            9'd1: dout = 32'hFF377FFF;   // W^1 = +0.99997 -0.00613j
            9'd2: dout = 32'hFE6E7FFE;   // W^2 = +0.99994 -0.01227j
            9'd3: dout = 32'hFDA57FFA;   // W^3 = +0.99982 -0.01840j
            9'd4: dout = 32'hFCDC7FF6;   // W^4 = +0.99969 -0.02454j
            9'd5: dout = 32'hFC137FF1;   // W^5 = +0.99954 -0.03067j
            9'd6: dout = 32'hFB4A7FEA;   // W^6 = +0.99933 -0.03680j
            9'd7: dout = 32'hFA817FE2;   // W^7 = +0.99908 -0.04294j
            9'd8: dout = 32'hF9B87FD9;   // W^8 = +0.99881 -0.04907j
            9'd9: dout = 32'hF8EF7FCE;   // W^9 = +0.99847 -0.05521j
            9'd10: dout = 32'hF8277FC2;   // W^10 = +0.99811 -0.06131j
            9'd11: dout = 32'hF75E7FB5;   // W^11 = +0.99771 -0.06744j
            9'd12: dout = 32'hF6957FA7;   // W^12 = +0.99728 -0.07358j
            9'd13: dout = 32'hF5CD7F98;   // W^13 = +0.99683 -0.07968j
            9'd14: dout = 32'hF5057F87;   // W^14 = +0.99631 -0.08578j
            9'd15: dout = 32'hF43C7F75;   // W^15 = +0.99576 -0.09192j
            9'd16: dout = 32'hF3747F62;   // W^16 = +0.99518 -0.09802j
            9'd17: dout = 32'hF2AC7F4E;   // W^17 = +0.99457 -0.10413j
            9'd18: dout = 32'hF1E47F38;   // W^18 = +0.99390 -0.11023j
            9'd19: dout = 32'hF11C7F22;   // W^19 = +0.99323 -0.11633j
            9'd20: dout = 32'hF0557F0A;   // W^20 = +0.99249 -0.12241j
            9'd21: dout = 32'hEF8D7EF0;   // W^21 = +0.99170 -0.12851j
            9'd22: dout = 32'hEEC67ED6;   // W^22 = +0.99091 -0.13458j
            9'd23: dout = 32'hEDFF7EBA;   // W^23 = +0.99005 -0.14066j
            9'd24: dout = 32'hED387E9D;   // W^24 = +0.98917 -0.14673j
            9'd25: dout = 32'hEC717E7F;   // W^25 = +0.98825 -0.15280j
            9'd26: dout = 32'hEBAB7E60;   // W^26 = +0.98730 -0.15884j
            9'd27: dout = 32'hEAE47E3F;   // W^27 = +0.98630 -0.16492j
            9'd28: dout = 32'hEA1E7E1E;   // W^28 = +0.98529 -0.17096j
            9'd29: dout = 32'hE9587DFB;   // W^29 = +0.98422 -0.17700j
            9'd30: dout = 32'hE8927DD6;   // W^30 = +0.98309 -0.18304j
            9'd31: dout = 32'hE7CD7DB1;   // W^31 = +0.98196 -0.18906j
            9'd32: dout = 32'hE7077D8A;   // W^32 = +0.98077 -0.19510j
            9'd33: dout = 32'hE6427D63;   // W^33 = +0.97958 -0.20111j
            9'd34: dout = 32'hE57D7D3A;   // W^34 = +0.97833 -0.20712j
            9'd35: dout = 32'hE4B97D0F;   // W^35 = +0.97702 -0.21310j
            9'd36: dout = 32'hE3F47CE4;   // W^36 = +0.97571 -0.21912j
            9'd37: dout = 32'hE3307CB7;   // W^37 = +0.97433 -0.22510j
            9'd38: dout = 32'hE26D7C89;   // W^38 = +0.97293 -0.23105j
            9'd39: dout = 32'hE1A97C5A;   // W^39 = +0.97150 -0.23703j
            9'd40: dout = 32'hE0E67C2A;   // W^40 = +0.97003 -0.24298j
            9'd41: dout = 32'hE0237BF9;   // W^41 = +0.96854 -0.24893j
            9'd42: dout = 32'hDF617BC6;   // W^42 = +0.96698 -0.25485j
            9'd43: dout = 32'hDE9E7B92;   // W^43 = +0.96539 -0.26080j
            9'd44: dout = 32'hDDDC7B5D;   // W^44 = +0.96378 -0.26672j
            9'd45: dout = 32'hDD1B7B27;   // W^45 = +0.96213 -0.27261j
            9'd46: dout = 32'hDC597AEF;   // W^46 = +0.96042 -0.27853j
            9'd47: dout = 32'hDB997AB7;   // W^47 = +0.95871 -0.28439j
            9'd48: dout = 32'hDAD87A7D;   // W^48 = +0.95694 -0.29028j
            9'd49: dout = 32'hDA187A42;   // W^49 = +0.95514 -0.29614j
            9'd50: dout = 32'hD9587A06;   // W^50 = +0.95331 -0.30200j
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
            9'd510: dout = 32'hFE6E8002;   // W^510 = -0.99994 -0.01227j
            9'd511: dout = 32'hFF378001;   // W^511 = -0.99997 -0.00613j
            // 兜底：W^0 = 1 - 0j（正常情况下不可达）
            default: dout = 32'h00007fff;
        endcase
    end

endmodule
