flyingyuya/Sonic-Speed-Parallelism/rtl/video/font_rom.v

//////////////////////////////////////////////////////////////////////////////////
// Company:
// Engineer:       Binyu Fei
//
// Create Date:    2026-10-26
// Design Name:    font_rom
// Module Name:    font_rom
// Project Name:   音速并行（Sonic-Speed-Parallelism）
// Target Devices: Xilinx Artix-7 XC7A100T-2FGG484I
// Tool versions:  Vivado 2020.2 / iverilog 12 / Verilator 5.052 / Verible
// Description:    font_rom.v - 点阵字库 ROM
// Dependencies:
//
// Revision:
// Revision 0.01 - File Created
//
//////////////////////////////////////////////////////////////////////////////////
`timescale 1ns/1ps


module font_rom #(
    parameter integer NCH = 91,      // 收录的字符数（按 ASCII 码直接寻址）
    parameter integer GW  = 5,      // 字形宽
    parameter integer GH  = 7       // 字形高（不含留空的行距行）
) (
    // 组合读取：扫描到哪个像素就查哪一位，不引入流水线
    input  wire [7:0]      ch,       // ASCII 码
    input  wire [2:0]      row,      // 第几行（0..7）
    output reg  [7:0]      bits      // bit4..bit0 = 该行的 5 个像素
);

    // ROM 内容：每个 ASCII 码 8 个字节
    reg [7:0] rom [0:NCH*8-1];

    integer i;
    initial begin
        for (i = 0; i < NCH*8; i = i + 1) rom[i] = 8'h00;   // 未收录 = 空格
        // '%' (0x25)
        rom[ 296] = 8'h19;   // row 0
        rom[ 297] = 8'h19;   // row 1
        rom[ 298] = 8'h02;   // row 2
        rom[ 299] = 8'h04;   // row 3
        rom[ 300] = 8'h08;   // row 4
        rom[ 301] = 8'h13;   // row 5
        rom[ 302] = 8'h13;   // row 6
        // '-' (0x2D)
        rom[ 360] = 8'h00;   // row 0
        rom[ 361] = 8'h00;   // row 1
        rom[ 362] = 8'h00;   // row 2
        rom[ 363] = 8'h1F;   // row 3
        rom[ 364] = 8'h00;   // row 4
        rom[ 365] = 8'h00;   // row 5
        rom[ 366] = 8'h00;   // row 6
        // '.' (0x2E)
        rom[ 368] = 8'h00;   // row 0
        rom[ 369] = 8'h00;   // row 1
        rom[ 370] = 8'h00;   // row 2
        rom[ 371] = 8'h00;   // row 3
        rom[ 372] = 8'h00;   // row 4
        rom[ 373] = 8'h0C;   // row 5
        rom[ 374] = 8'h0C;   // row 6
        // '/' (0x2F)
        rom[ 376] = 8'h01;   // row 0
        rom[ 377] = 8'h01;   // row 1
        rom[ 378] = 8'h02;   // row 2
        rom[ 379] = 8'h04;   // row 3
        rom[ 380] = 8'h08;   // row 4
        rom[ 381] = 8'h10;   // row 5
        rom[ 382] = 8'h10;   // row 6
        // '0' (0x30)
        rom[ 384] = 8'h0E;   // row 0
        rom[ 385] = 8'h11;   // row 1
        rom[ 386] = 8'h13;   // row 2
        rom[ 387] = 8'h15;   // row 3
        rom[ 388] = 8'h19;   // row 4
        rom[ 389] = 8'h11;   // row 5
        rom[ 390] = 8'h0E;   // row 6
        // '1' (0x31)
        rom[ 392] = 8'h04;   // row 0
        rom[ 393] = 8'h0C;   // row 1
        rom[ 394] = 8'h04;   // row 2
        rom[ 395] = 8'h04;   // row 3
        rom[ 396] = 8'h04;   // row 4
        rom[ 397] = 8'h04;   // row 5
        rom[ 398] = 8'h0E;   // row 6
        // '2' (0x32)
        rom[ 400] = 8'h0E;   // row 0
        rom[ 401] = 8'h11;   // row 1
        rom[ 402] = 8'h01;   // row 2
        rom[ 403] = 8'h02;   // row 3
        rom[ 404] = 8'h04;   // row 4
        rom[ 405] = 8'h08;   // row 5
        rom[ 406] = 8'h1F;   // row 6
        // '3' (0x33)
        rom[ 408] = 8'h1F;   // row 0
        rom[ 409] = 8'h02;   // row 1
        rom[ 410] = 8'h04;   // row 2
        rom[ 411] = 8'h02;   // row 3
        rom[ 412] = 8'h01;   // row 4
        rom[ 413] = 8'h11;   // row 5
        rom[ 414] = 8'h0E;   // row 6
        // '4' (0x34)
        rom[ 416] = 8'h02;   // row 0
        rom[ 417] = 8'h06;   // row 1
        rom[ 418] = 8'h0A;   // row 2
        rom[ 419] = 8'h12;   // row 3
        rom[ 420] = 8'h1F;   // row 4
        rom[ 421] = 8'h02;   // row 5
        rom[ 422] = 8'h02;   // row 6
        // '5' (0x35)
        rom[ 424] = 8'h1F;   // row 0
        rom[ 425] = 8'h10;   // row 1
        rom[ 426] = 8'h1E;   // row 2
        rom[ 427] = 8'h01;   // row 3
        rom[ 428] = 8'h01;   // row 4
        rom[ 429] = 8'h11;   // row 5
        rom[ 430] = 8'h0E;   // row 6
        // '6' (0x36)
        rom[ 432] = 8'h06;   // row 0
        rom[ 433] = 8'h08;   // row 1
        rom[ 434] = 8'h10;   // row 2
        rom[ 435] = 8'h1E;   // row 3
        rom[ 436] = 8'h11;   // row 4
        rom[ 437] = 8'h11;   // row 5
        rom[ 438] = 8'h0E;   // row 6
        // '7' (0x37)
        rom[ 440] = 8'h1F;   // row 0
        rom[ 441] = 8'h01;   // row 1
        rom[ 442] = 8'h02;   // row 2
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
        rom[ 683] = 8'h11;   // row 3
        rom[ 684] = 8'h11;   // row 4
        rom[ 685] = 8'h11;   // row 5
        rom[ 686] = 8'h0E;   // row 6
        // 'V' (0x56)
        rom[ 688] = 8'h11;   // row 0
        rom[ 689] = 8'h11;   // row 1
        rom[ 690] = 8'h11;   // row 2
        rom[ 691] = 8'h11;   // row 3
        rom[ 692] = 8'h11;   // row 4
        rom[ 693] = 8'h0A;   // row 5
        rom[ 694] = 8'h04;   // row 6
        // 'W' (0x57)
        rom[ 696] = 8'h11;   // row 0
        rom[ 697] = 8'h11;   // row 1
        rom[ 698] = 8'h11;   // row 2
        rom[ 699] = 8'h11;   // row 3
        rom[ 700] = 8'h15;   // row 4
        rom[ 701] = 8'h1B;   // row 5
        rom[ 702] = 8'h11;   // row 6
        // 'X' (0x58)
        rom[ 704] = 8'h11;   // row 0
        rom[ 705] = 8'h11;   // row 1
        rom[ 706] = 8'h0A;   // row 2
        rom[ 707] = 8'h04;   // row 3
        rom[ 708] = 8'h0A;   // row 4
        rom[ 709] = 8'h11;   // row 5
        rom[ 710] = 8'h11;   // row 6
        // 'Y' (0x59)
        rom[ 712] = 8'h11;   // row 0
        rom[ 713] = 8'h11;   // row 1
        rom[ 714] = 8'h0A;   // row 2
        rom[ 715] = 8'h04;   // row 3
        rom[ 716] = 8'h04;   // row 4
        rom[ 717] = 8'h04;   // row 5
        rom[ 718] = 8'h04;   // row 6
        // 'Z' (0x5A)
        rom[ 720] = 8'h1F;   // row 0
        rom[ 721] = 8'h01;   // row 1
        rom[ 722] = 8'h02;   // row 2
        rom[ 723] = 8'h04;   // row 3
        rom[ 724] = 8'h08;   // row 4
        rom[ 725] = 8'h10;   // row 5
        rom[ 726] = 8'h1F;   // row 6
    end

    always @(ch or row) begin
        // 越界（比如控制字符或超出收录范围）一律返回空格，不会读出
        if (ch > NCH - 1)
            bits = 8'h00;
        else
            bits = rom[ch*8 + row];
    end

endmodule
