flyingyuya/Sonic-Speed-Parallelism/rtl/audio/eq_coeff_rom.v

//=============================================================================
// eq_coeff_rom.v - 均衡器系数表（**本文件由 scripts/golden/gen_all.py 自动生成**）
//-----------------------------------------------------------------------------
// 结构：{频段, 增益档} -> 该段双二阶的 5 个系数 {b0,b1,b2,a1,a2}
//   频段 : 0..4 对应 100/300/1000/3000/8000 Hz
//   增益 : 0..20 对应 -10.0 .. 10.0 dB，步进 1.0 dB
//   地址 : (band*21 + gain)*5 + k
//
// 系数格式：18bit signed Q2.16（范围 [-2,2)，分辨率 1.5e-5）
//   —— 不能用 Q1.17，低架滤波器的 b1 会超过 -1 被削顶。
//
// 为什么用 ROM 表而不是片上实时计算系数：
//   实时计算需要 sin/cos/sqrt/除法，定点误差难以控制；离线用 Python 高精度算好后
//   量化到 Q1.17，片上只需一次查表 + 5 次寄存器写，零 DSP、零精度风险。
//=============================================================================
`timescale 1ns/1ps

module eq_coeff_rom (
    input  wire [9:0] addr,
    output reg  signed [17:0] dout
);

    always @* begin
        case (addr)
            // band=0 (100Hz) gain=-10.0dB
            10'd0: dout = 18'sh0fedd;
            10'd1: dout = 18'sh30231;
            10'd2: dout = 18'sh00000;
            10'd3: dout = 18'sh30354;
            10'd4: dout = 18'sh00000;
            // band=0 (100Hz) gain=-9.0dB
            10'd5: dout = 18'sh0feed;
            10'd6: dout = 18'sh30241;
            10'd7: dout = 18'sh00000;
            10'd8: dout = 18'sh30354;
            10'd9: dout = 18'sh00000;
            // band=0 (100Hz) gain=-8.0dB
            10'd10: dout = 18'sh0ff00;
            10'd11: dout = 18'sh30254;
            10'd12: dout = 18'sh00000;
            10'd13: dout = 18'sh30354;
            10'd14: dout = 18'sh00000;
            // band=0 (100Hz) gain=-7.0dB
            10'd15: dout = 18'sh0ff14;
            10'd16: dout = 18'sh30269;
            10'd17: dout = 18'sh00000;
            10'd18: dout = 18'sh30354;
            10'd19: dout = 18'sh00000;
            // band=0 (100Hz) gain=-6.0dB
            10'd20: dout = 18'sh0ff2b;
            10'd21: dout = 18'sh30280;
            10'd22: dout = 18'sh00000;
            10'd23: dout = 18'sh30354;
            10'd24: dout = 18'sh00000;
            // band=0 (100Hz) gain=-5.0dB
            10'd25: dout = 18'sh0ff45;
            10'd26: dout = 18'sh3029a;
            10'd27: dout = 18'sh00000;
            10'd28: dout = 18'sh30354;
            10'd29: dout = 18'sh00000;
            // band=0 (100Hz) gain=-4.0dB
            10'd30: dout = 18'sh0ff63;
            10'd31: dout = 18'sh302b7;
            10'd32: dout = 18'sh00000;
            10'd33: dout = 18'sh30354;
            10'd34: dout = 18'sh00000;
            // band=0 (100Hz) gain=-3.0dB
            10'd35: dout = 18'sh0ff84;
            10'd36: dout = 18'sh302d8;
            10'd37: dout = 18'sh00000;
            10'd38: dout = 18'sh30354;
            10'd39: dout = 18'sh00000;
            // band=0 (100Hz) gain=-2.0dB
            10'd40: dout = 18'sh0ffa8;
            10'd41: dout = 18'sh302fd;
            10'd42: dout = 18'sh00000;
            10'd43: dout = 18'sh30354;
            10'd44: dout = 18'sh00000;
            // band=0 (100Hz) gain=-1.0dB
            10'd45: dout = 18'sh0ffd2;
            10'd46: dout = 18'sh30326;
            10'd47: dout = 18'sh00000;
            10'd48: dout = 18'sh30354;
            10'd49: dout = 18'sh00000;
            // band=0 (100Hz) gain=+0.0dB
            10'd50: dout = 18'sh10000;
            10'd51: dout = 18'sh30354;
            10'd52: dout = 18'sh00000;
            10'd53: dout = 18'sh30354;
            10'd54: dout = 18'sh00000;
            // band=0 (100Hz) gain=+1.0dB
            10'd55: dout = 18'sh10034;
            10'd56: dout = 18'sh30388;
            10'd57: dout = 18'sh00000;
            10'd58: dout = 18'sh30354;
            10'd59: dout = 18'sh00000;
            // band=0 (100Hz) gain=+2.0dB
            10'd60: dout = 18'sh1006e;
            10'd61: dout = 18'sh303c3;
            10'd62: dout = 18'sh00000;
            10'd63: dout = 18'sh30354;
            10'd64: dout = 18'sh00000;
            // band=0 (100Hz) gain=+3.0dB
            10'd65: dout = 18'sh100b0;
            10'd66: dout = 18'sh30404;
            10'd67: dout = 18'sh00000;
            10'd68: dout = 18'sh30354;
            10'd69: dout = 18'sh00000;
            // band=0 (100Hz) gain=+4.0dB
            10'd70: dout = 18'sh100f9;
            10'd71: dout = 18'sh3044e;
            10'd72: dout = 18'sh00000;
            10'd73: dout = 18'sh30354;
            10'd74: dout = 18'sh00000;
            // band=0 (100Hz) gain=+5.0dB
            10'd75: dout = 18'sh1014c;
            10'd76: dout = 18'sh304a0;
            10'd77: dout = 18'sh00000;
            10'd78: dout = 18'sh30354;
            10'd79: dout = 18'sh00000;
            // band=0 (100Hz) gain=+6.0dB
            10'd80: dout = 18'sh101a8;
            10'd81: dout = 18'sh304fc;
            10'd82: dout = 18'sh00000;
            10'd83: dout = 18'sh30354;
            10'd84: dout = 18'sh00000;
            // band=0 (100Hz) gain=+7.0dB
            10'd85: dout = 18'sh10210;
            10'd86: dout = 18'sh30564;
            10'd87: dout = 18'sh00000;
            10'd88: dout = 18'sh30354;
            10'd89: dout = 18'sh00000;
            // band=0 (100Hz) gain=+8.0dB
            10'd90: dout = 18'sh10284;
            10'd91: dout = 18'sh305d9;
            10'd92: dout = 18'sh00000;
            10'd93: dout = 18'sh30354;
            10'd94: dout = 18'sh00000;
            // band=0 (100Hz) gain=+9.0dB
            10'd95: dout = 18'sh10307;
            10'd96: dout = 18'sh3065b;
            10'd97: dout = 18'sh00000;
            10'd98: dout = 18'sh30354;
            10'd99: dout = 18'sh00000;
            // band=0 (100Hz) gain=+10.0dB
            10'd100: dout = 18'sh10399;
            10'd101: dout = 18'sh306ee;
            10'd102: dout = 18'sh00000;
            10'd103: dout = 18'sh30354;
            10'd104: dout = 18'sh00000;
            // band=1 (300Hz) gain=-10.0dB
            10'd105: dout = 18'sh0fa19;
            10'd106: dout = 18'sh211a7;
            10'd107: dout = 18'sh0f4a2;
            10'd108: dout = 18'sh211a7;
            10'd109: dout = 18'sh0eebb;
            // band=1 (300Hz) gain=-9.0dB
            10'd110: dout = 18'sh0fabb;
            10'd111: dout = 18'sh210b7;
            10'd112: dout = 18'sh0f4ef;
            10'd113: dout = 18'sh210b7;
            10'd114: dout = 18'sh0efaa;
            // band=1 (300Hz) gain=-8.0dB
            10'd115: dout = 18'sh0fb5a;
            10'd116: dout = 18'sh20fd5;
            10'd117: dout = 18'sh0f533;
            10'd118: dout = 18'sh20fd5;
            10'd119: dout = 18'sh0f08d;
            // band=1 (300Hz) gain=-7.0dB
            10'd120: dout = 18'sh0fbf5;
            10'd121: dout = 18'sh20efe;
            10'd122: dout = 18'sh0f56f;
            10'd123: dout = 18'sh20efe;
            10'd124: dout = 18'sh0f164;
            // band=1 (300Hz) gain=-6.0dB
            10'd125: dout = 18'sh0fc8e;
            10'd126: dout = 18'sh20e33;
            10'd127: dout = 18'sh0f5a2;
            10'd128: dout = 18'sh20e33;
            10'd129: dout = 18'sh0f230;
            // band=1 (300Hz) gain=-5.0dB
            10'd130: dout = 18'sh0fd24;
            10'd131: dout = 18'sh20d72;
            10'd132: dout = 18'sh0f5cc;
            10'd133: dout = 18'sh20d72;
            10'd134: dout = 18'sh0f2f0;
            // band=1 (300Hz) gain=-4.0dB
            10'd135: dout = 18'sh0fdb9;
            10'd136: dout = 18'sh20cbc;
            10'd137: dout = 18'sh0f5ee;
            10'd138: dout = 18'sh20cbc;
            10'd139: dout = 18'sh0f3a7;
            // band=1 (300Hz) gain=-3.0dB
            10'd140: dout = 18'sh0fe4c;
            10'd141: dout = 18'sh20c0f;
            10'd142: dout = 18'sh0f608;
            10'd143: dout = 18'sh20c0f;
            10'd144: dout = 18'sh0f454;
            // band=1 (300Hz) gain=-2.0dB
            10'd145: dout = 18'sh0fede;
            10'd146: dout = 18'sh20b6c;
            10'd147: dout = 18'sh0f61a;
            10'd148: dout = 18'sh20b6c;
            10'd149: dout = 18'sh0f4f7;
            // band=1 (300Hz) gain=-1.0dB
            10'd150: dout = 18'sh0ff6f;
            10'd151: dout = 18'sh20ad1;
            10'd152: dout = 18'sh0f623;
            10'd153: dout = 18'sh20ad1;
            10'd154: dout = 18'sh0f592;
            // band=1 (300Hz) gain=+0.0dB
            10'd155: dout = 18'sh10000;
            10'd156: dout = 18'sh20a3f;
            10'd157: dout = 18'sh0f625;
            10'd158: dout = 18'sh20a3f;
            10'd159: dout = 18'sh0f625;
            // band=1 (300Hz) gain=+1.0dB
            10'd160: dout = 18'sh10091;
            10'd161: dout = 18'sh209b4;
            10'd162: dout = 18'sh0f61e;
            10'd163: dout = 18'sh209b4;
            10'd164: dout = 18'sh0f6af;
            // band=1 (300Hz) gain=+2.0dB
            10'd165: dout = 18'sh10124;
            10'd166: dout = 18'sh20931;
            10'd167: dout = 18'sh0f60f;
            10'd168: dout = 18'sh20931;
            10'd169: dout = 18'sh0f732;
            // band=1 (300Hz) gain=+3.0dB
            10'd170: dout = 18'sh101b7;
            10'd171: dout = 18'sh208b5;
            10'd172: dout = 18'sh0f5f7;
            10'd173: dout = 18'sh208b5;
            10'd174: dout = 18'sh0f7ae;
            // band=1 (300Hz) gain=+4.0dB
            10'd175: dout = 18'sh1024d;
            10'd176: dout = 18'sh20840;
            10'd177: dout = 18'sh0f5d7;
            10'd178: dout = 18'sh20840;
            10'd179: dout = 18'sh0f824;
            // band=1 (300Hz) gain=+5.0dB
            10'd180: dout = 18'sh102e4;
            10'd181: dout = 18'sh207d1;
            10'd182: dout = 18'sh0f5af;
            10'd183: dout = 18'sh207d1;
            10'd184: dout = 18'sh0f893;
            // band=1 (300Hz) gain=+6.0dB
            10'd185: dout = 18'sh1037e;
            10'd186: dout = 18'sh20768;
            10'd187: dout = 18'sh0f57d;
            10'd188: dout = 18'sh20768;
            10'd189: dout = 18'sh0f8fb;
            // band=1 (300Hz) gain=+7.0dB
            10'd190: dout = 18'sh1041b;
            10'd191: dout = 18'sh20705;
            10'd192: dout = 18'sh0f543;
            10'd193: dout = 18'sh20705;
            10'd194: dout = 18'sh0f95f;
            // band=1 (300Hz) gain=+8.0dB
            10'd195: dout = 18'sh104bc;
            10'd196: dout = 18'sh206a7;
            10'd197: dout = 18'sh0f500;
            10'd198: dout = 18'sh206a7;
            10'd199: dout = 18'sh0f9bc;
            // band=1 (300Hz) gain=+9.0dB
            10'd200: dout = 18'sh10561;
            10'd201: dout = 18'sh2064f;
            10'd202: dout = 18'sh0f4b4;
            10'd203: dout = 18'sh2064f;
            10'd204: dout = 18'sh0fa15;
            // band=1 (300Hz) gain=+10.0dB
            10'd205: dout = 18'sh1060b;
            10'd206: dout = 18'sh205fb;
            10'd207: dout = 18'sh0f45e;
            10'd208: dout = 18'sh205fb;
            10'd209: dout = 18'sh0fa69;
            // band=2 (1000Hz) gain=-10.0dB
            10'd210: dout = 18'sh0edcc;
            10'd211: dout = 18'sh2392b;
            10'd212: dout = 18'sh0dcf6;
            10'd213: dout = 18'sh2392b;
            10'd214: dout = 18'sh0cac2;
            // band=2 (1000Hz) gain=-9.0dB
            10'd215: dout = 18'sh0efb1;
            10'd216: dout = 18'sh23681;
            10'd217: dout = 18'sh0ddc1;
            10'd218: dout = 18'sh23681;
            10'd219: dout = 18'sh0cd71;
            // band=2 (1000Hz) gain=-8.0dB
            10'd220: dout = 18'sh0f18e;
            10'd221: dout = 18'sh233f7;
            10'd222: dout = 18'sh0de73;
            10'd223: dout = 18'sh233f7;
            10'd224: dout = 18'sh0d001;
            // band=2 (1000Hz) gain=-7.0dB
            10'd225: dout = 18'sh0f366;
            10'd226: dout = 18'sh2318a;
            10'd227: dout = 18'sh0df0e;
            10'd228: dout = 18'sh2318a;
            10'd229: dout = 18'sh0d274;
            // band=2 (1000Hz) gain=-6.0dB
            10'd230: dout = 18'sh0f539;
            10'd231: dout = 18'sh22f3a;
            10'd232: dout = 18'sh0df90;
            10'd233: dout = 18'sh22f3a;
            10'd234: dout = 18'sh0d4c9;
            // band=2 (1000Hz) gain=-5.0dB
            10'd235: dout = 18'sh0f708;
            10'd236: dout = 18'sh22d05;
            10'd237: dout = 18'sh0dffa;
            10'd238: dout = 18'sh22d05;
            10'd239: dout = 18'sh0d702;
            // band=2 (1000Hz) gain=-4.0dB
            10'd240: dout = 18'sh0f8d4;
            10'd241: dout = 18'sh22aec;
            10'd242: dout = 18'sh0e04d;
            10'd243: dout = 18'sh22aec;
            10'd244: dout = 18'sh0d921;
            // band=2 (1000Hz) gain=-3.0dB
            10'd245: dout = 18'sh0fa9e;
            10'd246: dout = 18'sh228eb;
            10'd247: dout = 18'sh0e087;
            10'd248: dout = 18'sh228eb;
            10'd249: dout = 18'sh0db25;
            // band=2 (1000Hz) gain=-2.0dB
            10'd250: dout = 18'sh0fc68;
            10'd251: dout = 18'sh22704;
            10'd252: dout = 18'sh0e0a9;
            10'd253: dout = 18'sh22704;
            10'd254: dout = 18'sh0dd11;
            // band=2 (1000Hz) gain=-1.0dB
            10'd255: dout = 18'sh0fe33;
            10'd256: dout = 18'sh22534;
            10'd257: dout = 18'sh0e0b2;
            10'd258: dout = 18'sh22534;
            10'd259: dout = 18'sh0dee5;
            // band=2 (1000Hz) gain=+0.0dB
            10'd260: dout = 18'sh10000;
            10'd261: dout = 18'sh2237b;
            10'd262: dout = 18'sh0e0a2;
            10'd263: dout = 18'sh2237b;
            10'd264: dout = 18'sh0e0a2;
            // band=2 (1000Hz) gain=+1.0dB
            10'd265: dout = 18'sh101d0;
            10'd266: dout = 18'sh221d7;
            10'd267: dout = 18'sh0e079;
            10'd268: dout = 18'sh221d7;
            10'd269: dout = 18'sh0e249;
            // band=2 (1000Hz) gain=+2.0dB
            10'd270: dout = 18'sh103a5;
            10'd271: dout = 18'sh22049;
            10'd272: dout = 18'sh0e036;
            10'd273: dout = 18'sh22049;
            10'd274: dout = 18'sh0e3db;
            // band=2 (1000Hz) gain=+3.0dB
            10'd275: dout = 18'sh1057f;
            10'd276: dout = 18'sh21ece;
            10'd277: dout = 18'sh0dfda;
            10'd278: dout = 18'sh21ece;
            10'd279: dout = 18'sh0e559;
            // band=2 (1000Hz) gain=+4.0dB
            10'd280: dout = 18'sh10761;
            10'd281: dout = 18'sh21d66;
            10'd282: dout = 18'sh0df63;
            10'd283: dout = 18'sh21d66;
            10'd284: dout = 18'sh0e6c4;
            // band=2 (1000Hz) gain=+5.0dB
            10'd285: dout = 18'sh1094c;
            10'd286: dout = 18'sh21c10;
            10'd287: dout = 18'sh0ded1;
            10'd288: dout = 18'sh21c10;
            10'd289: dout = 18'sh0e81d;
            // band=2 (1000Hz) gain=+6.0dB
            10'd290: dout = 18'sh10b41;
            10'd291: dout = 18'sh21acc;
            10'd292: dout = 18'sh0de23;
            10'd293: dout = 18'sh21acc;
            10'd294: dout = 18'sh0e964;
            // band=2 (1000Hz) gain=+7.0dB
            10'd295: dout = 18'sh10d41;
            10'd296: dout = 18'sh21999;
            10'd297: dout = 18'sh0dd59;
            10'd298: dout = 18'sh21999;
            10'd299: dout = 18'sh0ea9a;
            // band=2 (1000Hz) gain=+8.0dB
            10'd300: dout = 18'sh10f4f;
            10'd301: dout = 18'sh21875;
            10'd302: dout = 18'sh0dc71;
            10'd303: dout = 18'sh21875;
            10'd304: dout = 18'sh0ebc0;
            // band=2 (1000Hz) gain=+9.0dB
            10'd305: dout = 18'sh1116b;
            10'd306: dout = 18'sh21760;
            10'd307: dout = 18'sh0db6c;
            10'd308: dout = 18'sh21760;
            10'd309: dout = 18'sh0ecd7;
            // band=2 (1000Hz) gain=+10.0dB
            10'd310: dout = 18'sh11399;
            10'd311: dout = 18'sh2165a;
            10'd312: dout = 18'sh0da47;
            10'd313: dout = 18'sh2165a;
            10'd314: dout = 18'sh0ede0;
            // band=3 (3000Hz) gain=-10.0dB
            10'd315: dout = 18'sh0d38f;
            10'd316: dout = 18'sh29f10;
            10'd317: dout = 18'sh0aa75;
            10'd318: dout = 18'sh29f10;
            10'd319: dout = 18'sh07e04;
            // band=3 (3000Hz) gain=-9.0dB
            10'd320: dout = 18'sh0d7d8;
            10'd321: dout = 18'sh299fb;
            10'd322: dout = 18'sh0abad;
            10'd323: dout = 18'sh299fb;
            10'd324: dout = 18'sh08385;
            // band=3 (3000Hz) gain=-8.0dB
            10'd325: dout = 18'sh0dc25;
            10'd326: dout = 18'sh2950b;
            10'd327: dout = 18'sh0acb7;
            10'd328: dout = 18'sh2950b;
            10'd329: dout = 18'sh088dd;
            // band=3 (3000Hz) gain=-7.0dB
            10'd330: dout = 18'sh0e079;
            10'd331: dout = 18'sh29042;
            10'd332: dout = 18'sh0ad92;
            10'd333: dout = 18'sh29042;
            10'd334: dout = 18'sh08e0b;
            // band=3 (3000Hz) gain=-6.0dB
            10'd335: dout = 18'sh0e4d4;
            10'd336: dout = 18'sh28b9f;
            10'd337: dout = 18'sh0ae3b;
            10'd338: dout = 18'sh28b9f;
            10'd339: dout = 18'sh09310;
            // band=3 (3000Hz) gain=-5.0dB
            10'd340: dout = 18'sh0e939;
            10'd341: dout = 18'sh28722;
            10'd342: dout = 18'sh0aeb1;
            10'd343: dout = 18'sh28722;
            10'd344: dout = 18'sh097eb;
            // band=3 (3000Hz) gain=-4.0dB
            10'd345: dout = 18'sh0eda9;
            10'd346: dout = 18'sh282cd;
            10'd347: dout = 18'sh0aef3;
            10'd348: dout = 18'sh282cd;
            10'd349: dout = 18'sh09c9c;
            // band=3 (3000Hz) gain=-3.0dB
            10'd350: dout = 18'sh0f226;
            10'd351: dout = 18'sh27e9d;
            10'd352: dout = 18'sh0aefe;
            10'd353: dout = 18'sh27e9d;
            10'd354: dout = 18'sh0a123;
            // band=3 (3000Hz) gain=-2.0dB
            10'd355: dout = 18'sh0f6b2;
            10'd356: dout = 18'sh27a94;
            10'd357: dout = 18'sh0aed0;
            10'd358: dout = 18'sh27a94;
            10'd359: dout = 18'sh0a582;
            // band=3 (3000Hz) gain=-1.0dB
            10'd360: dout = 18'sh0fb4f;
            10'd361: dout = 18'sh276b1;
            10'd362: dout = 18'sh0ae68;
            10'd363: dout = 18'sh276b1;
            10'd364: dout = 18'sh0a9b7;
            // band=3 (3000Hz) gain=+0.0dB
            10'd365: dout = 18'sh10000;
            10'd366: dout = 18'sh272f2;
            10'd367: dout = 18'sh0adc4;
            10'd368: dout = 18'sh272f2;
            10'd369: dout = 18'sh0adc4;
            // band=3 (3000Hz) gain=+1.0dB
            10'd370: dout = 18'sh104c7;
            10'd371: dout = 18'sh26f59;
            10'd372: dout = 18'sh0ace2;
            10'd373: dout = 18'sh26f59;
            10'd374: dout = 18'sh0b1aa;
            // band=3 (3000Hz) gain=+2.0dB
            10'd375: dout = 18'sh109a8;
            10'd376: dout = 18'sh26be3;
            10'd377: dout = 18'sh0abc0;
            10'd378: dout = 18'sh26be3;
            10'd379: dout = 18'sh0b568;
            // band=3 (3000Hz) gain=+3.0dB
            10'd380: dout = 18'sh10ea5;
            10'd381: dout = 18'sh26891;
            10'd382: dout = 18'sh0aa5b;
            10'd383: dout = 18'sh26891;
            10'd384: dout = 18'sh0b900;
            // band=3 (3000Hz) gain=+4.0dB
            10'd385: dout = 18'sh113c1;
            10'd386: dout = 18'sh26562;
            10'd387: dout = 18'sh0a8b2;
            10'd388: dout = 18'sh26562;
            10'd389: dout = 18'sh0bc73;
            // band=3 (3000Hz) gain=+5.0dB
            10'd390: dout = 18'sh11900;
            10'd391: dout = 18'sh26254;
            10'd392: dout = 18'sh0a6c1;
            10'd393: dout = 18'sh26254;
            10'd394: dout = 18'sh0bfc1;
            // band=3 (3000Hz) gain=+6.0dB
            10'd395: dout = 18'sh11e65;
            10'd396: dout = 18'sh25f68;
            10'd397: dout = 18'sh0a486;
            10'd398: dout = 18'sh25f68;
            10'd399: dout = 18'sh0c2eb;
            // band=3 (3000Hz) gain=+7.0dB
            10'd400: dout = 18'sh123f4;
            10'd401: dout = 18'sh25c9b;
            10'd402: dout = 18'sh0a1fe;
            10'd403: dout = 18'sh25c9b;
            10'd404: dout = 18'sh0c5f3;
            // band=3 (3000Hz) gain=+8.0dB
            10'd405: dout = 18'sh129b2;
            10'd406: dout = 18'sh259ee;
            10'd407: dout = 18'sh09f27;
            10'd408: dout = 18'sh259ee;
            10'd409: dout = 18'sh0c8d9;
            // band=3 (3000Hz) gain=+9.0dB
            10'd410: dout = 18'sh12fa1;
            10'd411: dout = 18'sh2575f;
            10'd412: dout = 18'sh09bfd;
            10'd413: dout = 18'sh2575f;
            10'd414: dout = 18'sh0cb9e;
            // band=3 (3000Hz) gain=+10.0dB
            10'd415: dout = 18'sh135c6;
            10'd416: dout = 18'sh254ed;
            10'd417: dout = 18'sh0987c;
            10'd418: dout = 18'sh254ed;
            10'd419: dout = 18'sh0ce43;
            // band=4 (8000Hz) gain=-10.0dB
            10'd420: dout = 18'sh0b3d9;
            10'd421: dout = 18'sh36f5e;
            10'd422: dout = 18'sh06d6a;
            10'd423: dout = 18'sh36f5e;
            10'd424: dout = 18'sh02143;
            // band=4 (8000Hz) gain=-9.0dB
            10'd425: dout = 18'sh0ba79;
            10'd426: dout = 18'sh36bc3;
            10'd427: dout = 18'sh06e01;
            10'd428: dout = 18'sh36bc3;
            10'd429: dout = 18'sh0287a;
            // band=4 (8000Hz) gain=-8.0dB
            10'd430: dout = 18'sh0c14a;
            10'd431: dout = 18'sh36830;
            10'd432: dout = 18'sh06e56;
            10'd433: dout = 18'sh36830;
            10'd434: dout = 18'sh02fa1;
            // band=4 (8000Hz) gain=-7.0dB
            10'd435: dout = 18'sh0c84f;
            10'd436: dout = 18'sh364a6;
            10'd437: dout = 18'sh06e64;
            10'd438: dout = 18'sh364a6;
            10'd439: dout = 18'sh036b3;
            // band=4 (8000Hz) gain=-6.0dB
            10'd440: dout = 18'sh0cf8a;
            10'd441: dout = 18'sh36128;
            10'd442: dout = 18'sh06e26;
            10'd443: dout = 18'sh36128;
            10'd444: dout = 18'sh03db0;
            // band=4 (8000Hz) gain=-5.0dB
            10'd445: dout = 18'sh0d6fd;
            10'd446: dout = 18'sh35db6;
            10'd447: dout = 18'sh06d97;
            10'd448: dout = 18'sh35db6;
            10'd449: dout = 18'sh04494;
            // band=4 (8000Hz) gain=-4.0dB
            10'd450: dout = 18'sh0deab;
            10'd451: dout = 18'sh35a51;
            10'd452: dout = 18'sh06cb2;
            10'd453: dout = 18'sh35a51;
            10'd454: dout = 18'sh04b5d;
            // band=4 (8000Hz) gain=-3.0dB
            10'd455: dout = 18'sh0e699;
            10'd456: dout = 18'sh356fc;
            10'd457: dout = 18'sh06b70;
            10'd458: dout = 18'sh356fc;
            10'd459: dout = 18'sh05209;
            // band=4 (8000Hz) gain=-2.0dB
            10'd460: dout = 18'sh0eec9;
            10'd461: dout = 18'sh353b5;
            10'd462: dout = 18'sh069cd;
            10'd463: dout = 18'sh353b5;
            10'd464: dout = 18'sh05896;
            // band=4 (8000Hz) gain=-1.0dB
            10'd465: dout = 18'sh0f73f;
            10'd466: dout = 18'sh3507f;
            10'd467: dout = 18'sh067c2;
            10'd468: dout = 18'sh3507f;
            10'd469: dout = 18'sh05f01;
            // band=4 (8000Hz) gain=+0.0dB
            10'd470: dout = 18'sh10000;
            10'd471: dout = 18'sh34d5b;
            10'd472: dout = 18'sh0654a;
            10'd473: dout = 18'sh34d5b;
            10'd474: dout = 18'sh0654a;
            // band=4 (8000Hz) gain=+1.0dB
            10'd475: dout = 18'sh10910;
            10'd476: dout = 18'sh34a49;
            10'd477: dout = 18'sh0625e;
            10'd478: dout = 18'sh34a49;
            10'd479: dout = 18'sh06b6f;
            // band=4 (8000Hz) gain=+2.0dB
            10'd480: dout = 18'sh11275;
            10'd481: dout = 18'sh34749;
            10'd482: dout = 18'sh05ef9;
            10'd483: dout = 18'sh34749;
            10'd484: dout = 18'sh0716e;
            // band=4 (8000Hz) gain=+3.0dB
            10'd485: dout = 18'sh11c34;
            10'd486: dout = 18'sh3445d;
            10'd487: dout = 18'sh05b12;
            10'd488: dout = 18'sh3445d;
            10'd489: dout = 18'sh07746;
            // band=4 (8000Hz) gain=+4.0dB
            10'd490: dout = 18'sh12652;
            10'd491: dout = 18'sh34184;
            10'd492: dout = 18'sh056a5;
            10'd493: dout = 18'sh34184;
            10'd494: dout = 18'sh07cf7;
            // band=4 (8000Hz) gain=+5.0dB
            10'd495: dout = 18'sh130d6;
            10'd496: dout = 18'sh33ec0;
            10'd497: dout = 18'sh051a9;
            10'd498: dout = 18'sh33ec0;
            10'd499: dout = 18'sh08280;
            // band=4 (8000Hz) gain=+6.0dB
            10'd500: dout = 18'sh13bc8;
            10'd501: dout = 18'sh33c10;
            10'd502: dout = 18'sh04c18;
            10'd503: dout = 18'sh33c10;
            10'd504: dout = 18'sh087df;
            // band=4 (8000Hz) gain=+7.0dB
            10'd505: dout = 18'sh1472d;
            10'd506: dout = 18'sh33975;
            10'd507: dout = 18'sh045e9;
            10'd508: dout = 18'sh33975;
            10'd509: dout = 18'sh08d15;
            // band=4 (8000Hz) gain=+8.0dB
            10'd510: dout = 18'sh1530e;
            10'd511: dout = 18'sh336ef;
            10'd512: dout = 18'sh03f14;
            10'd513: dout = 18'sh336ef;
            10'd514: dout = 18'sh09222;
            // band=4 (8000Hz) gain=+9.0dB
            10'd515: dout = 18'sh15f73;
            10'd516: dout = 18'sh3347e;
            10'd517: dout = 18'sh03792;
            10'd518: dout = 18'sh3347e;
            10'd519: dout = 18'sh09705;
            // band=4 (8000Hz) gain=+10.0dB
            10'd520: dout = 18'sh16c65;
            10'd521: dout = 18'sh33221;
            10'd522: dout = 18'sh02f59;
            10'd523: dout = 18'sh33221;
            10'd524: dout = 18'sh09bbe;
            default: dout = 18'sh00000;
        endcase
    end

endmodule
