flyingyuya/Sonic-Speed-Parallelism/sim/tb/tb_disp_top.v

//=============================================================================
// tb_disp_top.v - 显示链顶层验证 + 导出 PPM
//-----------------------------------------------------------------------------
// 【对齐关系（写错了会全线报假错，务必先看清）】
//
//   lcd_timing 里：
//       周期 T   : x(T), y(T), in_active(T)                <- 组合
//       周期 T+1 : de = in_active(T)，rgb_out = f(x(T), y(T))   <- 寄存
//
//   所以检查时要用【当拍的 de】去配【上一拍的 x/y】：
//       if (de)  比较( lcd_rgb , f(x_d, y_d) )      x_d = x 延迟一拍
//   ❌ 不能再用 de 延迟一拍去配 x_d —— 那会整体又错开一拍。
//   （这个坑本项目踩过 4 次，见 docs/08 账本第 23/25/28/32 条）
//
// bars 也要延迟一拍：它在 sof 才更新，而 rgb_out 反映的是上一拍的状态。
//
// 【参照实现】
//   TB 里另起一份完整的像素生成链（bg_src + polar_map + rainbow_rom +
//   柱状/波形/极坐标合成），算出"这一像素本应是什么颜色"，逐点比对。
//   只有这样才能保证绘制顺序、优先级、颜色索引全都一致。
//
// 检查项：
//   ① 跨时钟域快照   30 根柱高跨域后逐根一致
//   ② 颜色           【全部 130560 个有效像素】逐一比对
//   ③ 柱状区像素数   每根柱点亮数 = (bh/2) * (8-BAR_GAP)
//   ④ 极坐标覆盖     30 根辐条都要有像素
//   ⑤ 帧内不撕裂     非 sof 拍 bars 不允许变化
//   ⑥ 色相滚动       跨帧 hue_off 递增（波形也用 rb_pol 上色）
//   ⑦ 导出 PPM
//=============================================================================
`timescale 1ns / 1ps

`include "disp_cfg.vh"

module tb_disp_top;

    // ⚠️ 全部来自 rtl/video/disp_cfg.vh —— 不要再在 TB 里写死这些数，
    //    否则改布局时 TB 和 RTL 会错开（这个坑踩过两次）。
    localparam integer HDISP    = `DISP_HDISP;
    localparam integer VDISP    = `DISP_VDISP;
    localparam integer NBARS    = `DISP_NBARS;
    localparam integer HW       = 9;
    localparam integer BARS_Y0  = `DISP_BARS_Y0;
    localparam integer BAR_GAP  = `DISP_BAR_GAP;
    localparam integer POL_CX   = `DISP_POL_CX;
    localparam integer POL_CY   = `DISP_POL_CY;
    localparam integer POL_RIN  = `DISP_POL_RIN;
    localparam integer POL_RMAX = `DISP_POL_RMAX;
    localparam integer WAVE_CY  = `DISP_WAVE_CY;
    localparam integer WAVE_AMP = `DISP_WAVE_AMP;
    localparam integer WAVE_TH  = `DISP_WAVE_TH;
    localparam integer DW       = NBARS * HW;      // 540

    localparam [23:0] AXIS_RGB = 24'h20_38_50;
    localparam [23:0] CORE_RGB = 24'h40_50_60;

    localparam real TSYS_NS = 20.8333;
    localparam real TPIX_NS = 80.0;
    localparam integer SETTLE_FRAMES = 4;
    localparam integer NBAR_W = 8 - BAR_GAP;       // 每根柱每行点亮像素数

    reg clk_sys = 1'b0, clk_pix = 1'b0;
    reg rst_sys_n = 1'b0, rst_pix_n = 1'b0;

    always #(TSYS_NS / 2.0) clk_sys = ~clk_sys;
    always #(TPIX_NS / 2.0) clk_pix = ~clk_pix;

    //=========================================================================
    // 写侧
    //=========================================================================
    reg  [DW-1:0] spec_din = {DW{1'b0}};
    reg           spec_wr  = 1'b0;

    // 波形输入：喂一段【双极性】三角波，周期 64 个采样。
    //   ⚠️ 必须是双极性的（要走到 -TH 以下）—— wave_buf 用的是"向上过零"触发，
    //      只会在正半周晃的信号永远碰不到迟滞闸门，只能靠自动触发兜底，
    //      画面会一直跳。第一版就喂了个全正值的三角波，正好踩在这个坑里。
    //   phase 0..63，幅度 -31..+31，再左移 18 位放进 Q1.23 的高位。
    reg signed [23:0] wave_din = 24'sd0;
    // 自适应门限：TB 里给个固定值即可（DUT 的 wave_buf 用 ADAPT=1 读它，
    // 参照那边用 ADAPT=0 走参数 TH，两边门限相同 -> 行为一致）
    reg signed [23:0] wave_th_v = 24'sd131072;
    // 诊断口：TB 给个固定值即可（两边必须用同一个值）
    reg [23:0] dbg_adc_v = 24'h00ABCD;
    integer wave_tri = 0;
    reg               wave_we  = 1'b0;

    // 视图使能：[0]柱状 [1]极坐标 [2]波形。主测量用全开，
    //           之后会临时关掉几个做"开关真的生效"的抽查。
    reg [2:0] view_en  = 3'b111;
    reg [7:0] hue_spd  = 8'd6;      // 与 ui_ctrl 的默认值一致
    // G 命令：指数，2 = x4 是【上电默认】。
    //   ⚠️ 但这个 TB 的像素比对里，参照模型【不施加增益】（它拿 e_wave 直接算），
    //      所以这里必须用 0（x1）才等价。增益单独由 [3b] 那段穷举验证。
    reg [7:0] wave_gain = 8'd0;
    reg [7:0] ui_demo_v = 8'd0;     // T 命令：演示图案（默认关）
    reg [11:0] tp_x_v = 12'd4095, tp_y_v = 12'd4095;  // 未触摸（上下限都贴住）
    // 触摸原始读数固定成"完全没触摸"（>4000 判为未按下），
    // 这样 UI 层只画按钮条、没有"按下"高亮，参照模型好写。
    // 真正测"按下"的交互留给 tb_xpt2046 和 tb_ui_layer。
                                    //   H 越大越快：H=6 -> 每 2^(8-6)=4 帧滚一级
    integer           wdiv = 0, wph = 0;

    always @(posedge clk_sys) begin
        if (!rst_sys_n) begin
            wdiv <= 0; wph <= 0; wave_we <= 1'b0; wave_din <= 24'sd0;
        end else if (wdiv == 39) begin
            wdiv     <= 0;
            wave_we  <= 1'b1;
            // 上半段 -31 -> +31，下半段 +31 -> -31；上升过零在 wph=16
            wave_tri = (wph < 32) ? (2*wph - 31) : (95 - 2*wph);
            wave_din <= wave_tri <<< 18;
            wph      <= (wph == 63) ? 0 : wph + 1;
        end else begin
            wdiv    <= wdiv + 1;
            wave_we <= 1'b0;
        end
    end
    integer       i, k;

    //=========================================================================
    // DUT
    //=========================================================================
    wire [23:0] lcd_rgb;
    wire        lcd_hs, lcd_vs, lcd_clk;

    // 导帧用：让面板【开着】并把光标停在第 3 个按钮上（=GAIN）。
    //   panel_tog 是【翻转标志】不是脉冲：0->1 会让 disp_top 翻一次 ui_open。
    //   这样导出来的图能一次看清 7 个按钮的排布和标签渲染。
    reg         panel_tog_tb;
    reg  [3:0]  ui_sel_tb;

    disp_top #(
        // 让插值器一帧到位。
        // 参照模型算的是【稳态】（pres = view_en ? 128 : 0），
        // 而默认 STEP=4 要 32 帧（32 x 150150 拍 ≈ 480 万拍）才收敛，
        // 那样 TB 根本跑不动，中间帧也必然对不上。
        .ANIM_STEP(128)
    ) dut (
        .clk_sys   (clk_sys),
        .rst_sys_n (rst_sys_n),
        .spec_wr   (spec_wr),
        .spec_din  (spec_din),
        .clk_pix   (clk_pix),
        .rst_pix_n (rst_pix_n),
        .ui_mode   (4'd0),
        .ui_style  (4'd0),
        .ui_view   (view_en),
        .ui_hue_spd(hue_spd),
        .ui_wave_gain(wave_gain),
        .ui_demo   (ui_demo_v),
        .tp_x      (tp_x_v),
        .tp_y      (tp_y_v),
        .tp_edges  (12'd7),
        .tp_low    (1'b1),
        .wave_din  (wave_din),
        .wave_th   (wave_th_v),
        .dbg_adc   (dbg_adc_v),
        .dbg_sd_bytes (64'd0),
        .cfg_bg_src   (1'b0),
        .ui_spk_mute  (1'b0), .ui_src(1'b0), .ui_img_idx(8'd0),
        .fb_rgb       (16'h0000),
        .fb_addr      (),
        // 新增端口：本用例不测按键，全部给"无活动/无光标"的静默值
        .panel_tog  (panel_tog_tb),
        .key_act    (1'b0),
        .ui_sel     (ui_sel_tb),
        .wave_we   (wave_we),
        .lcd_rgb   (lcd_rgb),
        .lcd_hs    (lcd_hs),
        .lcd_vs    (lcd_vs),
        .lcd_clk   (lcd_clk)
    );

    //=========================================================================
    // 参照实现：所有信号统一延迟一拍，去配【当拍的 de】
    //=========================================================================
    reg [9:0]    x_d   = 10'd0;
    reg [8:0]    y_d   = 9'd0;
    reg [6:0]    hue_d = 7'd0;
    reg [DW-1:0] bars_d = {DW{1'b0}};

    always @(posedge clk_pix) begin
        x_d    <= dut.x;
        y_d    <= dut.y;
        hue_d  <= dut.hue_off;
        bars_d <= dut.u_sync.bars;
    end

    // ---- 背景 ----
    wire [23:0] e_bg;
    bg_src #(.HDISP(HDISP), .VDISP(VDISP)) u_bg_ref (
        .x(x_d), .y(y_d), .mode(4'd0), .rgb(e_bg)
    );

    // ---- 柱状 ----
    wire [5:0]    e_bbar = {1'b0, x_d[8:3]};
    wire [HW-1:0] e_bbh  = bars_d[e_bbar*HW +: HW];
    // 系数必须和 disp_mix 里一致：BARS_H=192 -> bh*3/8
    //   （柱子从 96px 抬到 192px，系数从 3/16 变成 3/8）
    wire [7:0]    e_bhpx = e_bbh[8:1];               // /2 -> 0..255
    wire [8:0]    e_bfb  = VDISP[8:0] - 9'd1 - y_d;
    wire e_b_hit = (y_d >= BARS_Y0[8:0]) && (e_bfb < {2'b00, e_bhpx})
                   && (x_d[2:0] >= BAR_GAP[2:0]);
    wire e_b_lit = e_b_hit && view_en[0];

    // ---- 极坐标 ----
    wire        e_p_in, e_p_lit;
    wire [5:0]  e_p_bar;
    wire [7:0]  e_p_r;

    polar_map #(
        .NBARS(NBARS), .HW(HW),
        .CX(POL_CX), .CY(POL_CY), .R_IN(POL_RIN), .R_MAX(POL_RMAX)
    ) u_pol_ref (
        .x(x_d), .y(y_d), .bars(bars_d),
        .in_disc(e_p_in), .lit(e_p_lit), .bar_idx(e_p_bar), .r_out(e_p_r),
        // ⚠️ 必须和 DUT 一致：ANIM_STEP=FULL 时 pres 是稳态值，
        //   view_en[1]=1 -> 128、=0 -> 0。
        //   写死 8'd128 的话，视图关掉的那几段 DUT 算出空圆盘、
        //   参照还在画圆盘，整整报 36010 处不符。
        .pres(view_en[1] ? 8'd128 : 8'd0)
    );
    wire e_p_core = view_en[1] && e_p_in && (e_p_r >= POL_RIN - 3) && (e_p_r < POL_RIN);
    wire e_p_litg = view_en[1] && e_p_lit;

    // ---- 颜色 ----
    wire [23:0] e_rb_bar, e_rb_pol;
    rainbow_rom u_rb1 (.addr({e_bbar[4:0], 2'b00} + hue_d), .rgb(e_rb_bar));
    rainbow_rom u_rb2 (.addr({e_p_bar[4:0], 2'b00} + hue_d), .rgb(e_rb_pol));

    // ---- 波形（TB 里镜像一份 wave_buf，才能验证 disp_top 的连线与映射）----
    wire signed [23:0] e_wave;
    // ⚠️ 参照的 ADAPT/th_in 必须和 DUT 里那个实例【完全一致】
    //    （DUT 的 disp_top 用 .ADAPT(1) 读 wave_th）——
    //    配置不一样的话，两边状态机分手，报几千处不符还很难查。
    wave_buf #(.DW(24), .AW(10), .SPAN(HDISP), .ADAPT(1)) u_wave_ref (
        .wclk(clk_sys), .wrst_n(rst_sys_n), .we(wave_we), .din(wave_din),
        .rclk(clk_pix), .rrst_n(rst_pix_n), .sof(dut.sof), .x(dut.x),
        .dout(e_wave), .th_in(wave_th_v), .trig_pulse(), .done_pulse()
    );

    // ⚠️ 采集波形也要延迟一拍：DUT 里 wave_buf.dout 是一级寄存器、
    //    lcd_timing.rgb_out 又是一级，而参照里的 y_d/x_d 只延迟了一拍。
    //    少延这一拍会让波形整体错开 2 个像素（又是"差一拍"这个老问题）。
    reg signed [23:0] e_wave_d = 24'sd0;
    always @(posedge clk_pix) e_wave_d <= e_wave;

    wire [24:0] e_wabs = e_wave_d[23] ? ({1'b0, ~e_wave_d} + 1'b1)
                                      : {1'b0, e_wave_d};
    // ⚠️ 位宽和 DUT 保持一致：SH=17 时 wabs[23:17] 是 7 位（0..127）
    //    （DUT 原来写成 6 位 ⟹ 幅度被截半 ⟹ 已修 ✓ 这里同步）
    wire [6:0]  e_wraw = e_wabs[23:`DISP_WAVE_SH];
    wire [6:0]  e_wamp0 = (e_wraw > WAVE_AMP[6:0]) ? WAVE_AMP[6:0] : e_wraw;
    // 和 DUT 一致：显示前 ×1.5（×3/2）后再钳位
    wire [7:0]  e_wamp3 = {e_wamp0, 1'b0} + e_wamp0;
    wire [6:0]  e_wamp  = (e_wamp3[7:1] > WAVE_AMP[6:0])
                        ? WAVE_AMP[6:0] : e_wamp3[7:1];
    // 正值朝上（和 DUT 一致）：负值 -> y 变大（往下）
    wire [8:0]  e_wy   = e_wave_d[23] ? (WAVE_CY[8:0] + {2'b00, e_wamp})
                                      : (WAVE_CY[8:0] - {2'b00, e_wamp});
    wire [8:0]  e_wdy  = (y_d > e_wy) ? (y_d - e_wy) : (e_wy - y_d);
    wire        e_wline = view_en[2] && (e_wdy <= WAVE_TH[8:0]);
    wire        e_waxis = !view_en[2] && (y_d == WAVE_CY[8:0]);

    // ---- 合成（优先级必须和 disp_mix 完全一致）----
    // 优先级必须和 disp_mix 完全一致：背景 < 柱状 < 波形 < 极坐标
    // ---- 文字层（参照模型也用【同一个模块】，不是另写一遍）----
    //   text_buf / status_line 是纯组合 + 一个小寄存器，直接例化同一个模块
    //   最可靠 —— 自己再写一遍排版逻辑反而容易和 RTL 错开。
    wire        e_t_we, e_t_hit, e_t_lit;
    wire [15:0] e_t_addr;
    wire [7:0]  e_t_data;

    status_line #(.NLEN(`DISP_TXT_NLEN), .NC(`DISP_TXT_NLEN)) u_status_ref (
        .clk(clk_pix), .rst_n(rst_pix_n),
        .cfg_view({5'b0, view_en}), .cfg_style(8'd0), .cfg_spk_mute(1'b0), .cfg_src(1'b0), .cfg_img_idx(8'd0),
        .cfg_hue_spd(hue_spd), .cfg_wave_gain(wave_gain),
        .cfg_bg_mode(8'd0), .cfg_demo(ui_demo_v),
        .tp_x(tp_x_v), .tp_y(tp_y_v), .tp_edges(12'd7), .dbg_adc(dbg_adc_v),
        .dbg_sd_bytes(64'd0),
 .tp_low(1'b1),
        .we(e_t_we), .waddr(e_t_addr), .wdata(e_t_data)
    );

    // ⚠️ 参考模型的文本框位置必须和 DUT 一致（DUT 里现在放到右侧了）
    text_buf #(.NC(`DISP_TXT_NLEN), .NL(`DISP_TXT_NL), .XW(10), .YW(9),
               .TX0(480-80-4), .TY0(2)) u_text_ref (
        .clk(clk_pix), .we(e_t_we), .waddr(e_t_addr), .wdata(e_t_data),
        .x(x_d), .y(y_d), .hit(e_t_hit), .lit(e_t_lit)
    );

    // ---- UI 按钮层（参照也用【同一个模块】）----
    wire        e_u_draw;
    wire [23:0] e_u_rgb;
    wire [2:0]  e_u_k;
    wire        e_u_hit;
    wire [3:0]  e_u_act;

    ui_layer #(
        .NB(`DISP_UI_NB), .XW(10), .YW(9),
        .BX0(0), .BY0(`DISP_UI_BY0), .BW(`DISP_UI_BW), .BH(`DISP_UI_BH),
        .GAP(`DISP_UI_GAP)
    ) u_ui_ref (
        // 参照用【同一个 ui_layer 模块】；输入要和 DUT 内部算出来的一致。
        // DUT 里：未触摸 -> tch_down=0，且高亮锁存 ui_active 会在上电时
        // 被初始化成 0xF（无高亮）。所以这里也用 4'hF。
        // 参照要和 DUT 的【稳态】一致：
        //   DUT 里 ANIM_STEP=FULL 一帧到位，面板默认收起 -> by0 = VDISP（屏幕外）
        .x(x_d), .y(y_d), .tx(10'd0), .ty(9'd0),
        .pressed(1'b0), .ui_by0(9'd272), .ui_open(1'b0), .active(4'hF),
        .draw(e_u_draw), .rgb(e_u_rgb),
        .hit_k(e_u_k), .hit(e_u_hit), .hit_act(e_u_act),
        .tab_hit()
    );

    localparam [23:0] TEXT_RGB = 24'hF0_F0_F0;
    wire [23:0] TEXT_BG = {2'b00, e_bg[23:18], 2'b00, e_bg[15:10], 2'b00, e_bg[7:2]};

    wire [23:0] exp_mix = e_p_litg ? e_rb_pol
                        : e_p_core ? CORE_RGB
                        : e_wline  ? e_rb_pol
                        : e_waxis  ? AXIS_RGB
                        : e_b_lit  ? e_rb_bar
                        :            e_bg;

    // 叠加顺序必须和 disp_mix 完全一致：mix -> UI -> 文字
    wire [23:0] exp_ui  = e_u_draw ? e_u_rgb : exp_mix;
    wire [23:0] exp_rgb = e_t_lit ? TEXT_RGB
                        : e_t_hit ? TEXT_BG
                        :           exp_ui;

    //=========================================================================
    // 测量窗口
    //=========================================================================
    integer n_err = 0;
    integer n_pix = 0;
    integer f_no  = 0;
    reg     meas  = 1'b0;

    integer bar_cnt [0:NBARS-1];
    integer pol_cnt [0:NBARS-1];
    integer n_tear  = 0;

    reg [6:0] hue_prev = 7'd0;
    integer   n_scroll = 0;

    integer fd;
    reg     cap_en = 1'b0;

    always @(posedge clk_pix) begin
        if (rst_pix_n && dut.sof) begin
            f_no = f_no + 1;
            if (f_no == SETTLE_FRAMES) begin
                meas   = 1'b1;
                cap_en = 1'b1;
            end
            if (f_no == SETTLE_FRAMES + 1) begin
                meas   = 1'b0;
                cap_en = 1'b0;
            end
        end
    end

    //---------------------------------------------------------------------
    // ② 颜色逐像素比对
    //---------------------------------------------------------------------
    always @(posedge clk_pix) begin
        if (rst_pix_n && meas && dut.de) begin
            n_pix = n_pix + 1;
            if (lcd_rgb !== exp_rgb) begin
                n_err = n_err + 1;
                if (n_err <= 8)
                    $display("  [ERR] (%0d,%0d) 颜色 %06h 期望 %06h  (柱亮=%b 极亮=%b 心环=%b 轴=%b)",
                             x_d, y_d, lcd_rgb, exp_rgb, e_b_lit, e_p_litg, e_p_core, e_wline);
            end

            // ③④ 分区统计
            if (e_b_lit) bar_cnt[e_bbar] = bar_cnt[e_bbar] + 1;
            if (e_p_lit) pol_cnt[e_p_bar] = pol_cnt[e_p_bar] + 1;
        end
    end

    //---------------------------------------------------------------------
    // ⑤ 帧内不撕裂
    //---------------------------------------------------------------------
    always @(posedge clk_pix) begin
        if (rst_pix_n && meas && !dut.sof) begin
            if (dut.u_sync.bars !== bars_d) n_tear = n_tear + 1;
        end
    end

    //---------------------------------------------------------------------
    // ⑥ 色相滚动
    //---------------------------------------------------------------------
    always @(posedge clk_pix) begin
        if (rst_pix_n && hue_prev !== dut.hue_off) begin
            n_scroll = n_scroll + 1;
            hue_prev = dut.hue_off;
        end
    end

    //---------------------------------------------------------------------
    // ⑦ PPM 导出
    //---------------------------------------------------------------------
    always @(posedge clk_pix) begin
        if (cap_en && dut.de && fd != 0)
            $fwrite(fd, "%c%c%c", lcd_rgb[23:16], lcd_rgb[15:8], lcd_rgb[7:0]);

            // [DIAG] 标签行的几何诊断：每 8 像素（一个字符格）打一次。
            //   目的是回答"bx 到底是多少、lx/l_col 从哪个值开始"——
            //   光看图只能知道"串了"，不知道串在哪一步。
    end

    //=========================================================================
    // 主流程
    //=========================================================================
    reg [HW-1:0] got_bars [0:NBARS-1];
    reg [DW-1:0] bars_now;
    integer n_err_bar, n_err_pol, n_pol_used;
    integer bh_cnt;
    integer exp_px;
    integer h0, h1, h2, hh;
    reg [8:0] exp_h;

    initial begin
        if ($test$plusargs("vcd")) begin
            $dumpfile("tb_disp_top.vcd");
            $dumpvars(0, tb_disp_top);
        end

        $display("============================================================");
        $display(" 显示链顶层验证（新布局：极坐标 + 波形中线 + 柱状）");
        $display("   极坐标 圆心(%0d,%0d) 半径 %0d~%0d", POL_CX, POL_CY, POL_RIN, POL_RMAX);
        $display("   波形   中线 y=%0d（A3 才接真实缓冲）", WAVE_CY);
        $display("   柱状   y>=%0d，%0d 根 x %0d px", BARS_Y0, NBARS, HDISP/NBARS);
        $display("============================================================");

        for (k = 0; k < NBARS; k = k + 1) begin
            bar_cnt[k] = 0;
            pol_cnt[k] = 0;
            got_bars[k] = 0;
        end

        panel_tog_tb = 1'b0;  ui_sel_tb = 4'hF;
        rst_sys_n = 1'b0;  rst_pix_n = 1'b0;
        repeat (20) @(posedge clk_sys);
        repeat (10) @(posedge clk_pix);
        @(negedge clk_sys); rst_sys_n = 1'b1;
        @(negedge clk_pix); rst_pix_n = 1'b1;
        repeat (4) @(posedge clk_pix);

        // ⚠️ 这里【不要】把面板打开：
        //   本 TB 同时还在和参考模型(u_ui_ref)逐像素比对，而参考模型并不知道
        //   面板开了 —— 一打开就整片失配（实测报了 (453,132) 这类错，看着像极坐标坏了）。
        //   需要看面板排布时，临时把下面这行改成 panel_tog_tb = 1'b1，
        //   跑完【只看导出的 PPM】、不看逐像素比对结果，然后改回来。
        //   （7 按钮那次就是这么做才看到"标签偏 4 像素"的。）
        @(negedge clk_pix); panel_tog_tb = 1'b0; ui_sel_tb = 4'hF;

        fd = $fopen("sim/build/disp_frame.ppm", "wb");
        if (fd == 0)
            $display("  [WARN] 打不开 sim/build/disp_frame.ppm，跳过图片导出");
        else
            $fwrite(fd, "P6\n%0d %0d\n255\n", HDISP, VDISP);

        for (i = 0; i < 3; i = i + 1) begin
            // 造一段"像音乐"的频谱：整体随频率衰减 + 两个凸起（鼓点/人声）
            //   base  = 470 - 3k        470 -> 293
            //   bump1 = k 8..17  +70    低频鼓点
            //   bump2 = k 30..41 +55    中频人声
            //   柱 0 故意留 0 —— 直流分量本来就是滤掉的，
            //   顺便让"柱高为 0 不点亮"这条检查有依据。
            // ⚠️ 循环体必须用 begin/end 包起来！Verilog 的 for 只带【一条】语句，
            //    漏了 begin/end 会让后面的赋值跑到循环外，只执行一次 ——
            //    表现为"数据写进去了但全是 0"（因为最后一次执行时 k 已越界）。
            for (k = 0; k < NBARS; k = k + 1) begin
                h0 = 470 - (k * 3);
                h1 = (k >= 8  && k < 18) ? 70 : 0;
                h2 = (k >= 30 && k < 42) ? 55 : 0;
                hh = h0 + h1 + h2;
                if (k == 0)                hh = 0;
                if (hh > 511)              hh = 511;
                spec_din[k*HW +: HW] = hh[8:0];
            end
            @(negedge clk_sys); spec_wr = 1'b1;
            @(negedge clk_sys); spec_wr = 1'b0;
            repeat (6) @(posedge clk_sys);
        end

        wait (f_no >= SETTLE_FRAMES + 2);
        repeat (4) @(posedge clk_pix);

        if (fd != 0) begin
            $fclose(fd);
            $display("");
            $display("  已导出图片: sim/build/disp_frame.ppm  (%0dx%0d RGB888)", HDISP, VDISP);
        end

        //---------------------------------------------------------------------
        // ① 跨域快照
        //---------------------------------------------------------------------
        $display("");
        $display(" [1] 跨时钟域快照");
        for (k = 0; k < NBARS; k = k + 1) begin
            got_bars[k] = dut.u_sync.bars[k*HW +: HW];
            h0 = 470 - (k * 3);
            h1 = (k >= 8  && k < 18) ? 70 : 0;
            h2 = (k >= 30 && k < 42) ? 55 : 0;
            hh = h0 + h1 + h2;
            exp_h = (k == 0) ? 9'd0 : (hh > 511) ? 9'd511 : hh[8:0];
            if (got_bars[k] !== exp_h) begin
                n_err = n_err + 1;
                if (n_err <= 6)
                    $display("  [ERR] 柱 %0d：clk_pix 读到 %0d，写入 %0d",
                             k, got_bars[k], exp_h);
            end
        end
        $display("  [ok ] %0d 根柱高跨域后逐根一致（柱0=%0d 柱10=%0d 柱29=%0d）",
                 NBARS, got_bars[0], got_bars[10], got_bars[29]);

        //---------------------------------------------------------------------
        // ③ 柱状区像素数
        //---------------------------------------------------------------------
        $display("");
        $display(" [2] 柱状区像素数");
        n_err_bar = 0;
        for (k = 0; k < NBARS; k = k + 1) begin
            // 系数必须和 disp_mix 一致：BARS_H=58 时是 bh*29/256（原来是 bh*3/16）
            exp_px = (got_bars[k] * 1) / 2 * NBAR_W;
            if (bar_cnt[k] != exp_px) begin
                n_err_bar = n_err_bar + 1;
                if (n_err_bar <= 6)
                    $display("  [ERR] 柱 %0d：点亮 %0d 像素，期望 %0d（高 %0d）",
                             k, bar_cnt[k], exp_px, got_bars[k]);
            end
        end
        if (n_err_bar != 0) n_err = n_err + 1;
        else
            $display("  [ok ] 60 根柱点亮像素数 = (柱高*3/16) x %0d，逐根吻合", NBAR_W);

        //---------------------------------------------------------------------
        // ④ 极坐标覆盖
        //---------------------------------------------------------------------
        $display("");
        $display(" [3] 极坐标覆盖");
        n_pol_used = 0;
        for (k = 0; k < NBARS; k = k + 1)
            if (pol_cnt[k] > 0) n_pol_used = n_pol_used + 1;

        // 柱 0 高度为 0 -> 极坐标上对应辐条整段熄灭；其余都要有像素
        n_err_pol = 0;
        if (pol_cnt[0] != 0) n_err_pol = n_err_pol + 1;
        for (k = 1; k < NBARS; k = k + 1)
            if (pol_cnt[k] == 0) n_err_pol = n_err_pol + 1;

        if (n_err_pol != 0) begin
            n_err = n_err + 1;
            $display("  [ERR] 有 %0d 根辐条的覆盖情况不符（柱 0 高为 0，应完全不亮）", n_err_pol);
        end else
            $display("  [ok ] 柱 0（高为 0）的辐条完全不亮，其余 %0d 根都有像素", NBARS-1);

        //---------------------------------------------------------------------
        $display("");
        if (n_tear != 0) begin
            n_err = n_err + 1;
            $display("  [ERR] 帧内 bars 变化 %0d 次（撕裂）", n_tear);
        end else
            $display("  [ok ] 帧内柱高保持不变（无撕裂）");

        if (n_scroll == 0) begin
            n_err = n_err + 1;
            $display("  [ERR] 色相偏移没有变化");
        end else
            $display("  [ok ] 色相偏移变化 %0d 次", n_scroll);

        $display("");
        $display("  测量帧有效像素数 = %0d（应为 %0d）", n_pix, HDISP*VDISP);
        if (n_pix != HDISP * VDISP) begin
            n_err = n_err + 1;
            $display("  [ERR] 有效像素数不符");
        end

        //---------------------------------------------------------------------
        //---------------------------------------------------------------------
        //---------------------------------------------------------------------
        // [3b] 波形增益（G 命令）—— 它以前是个【死控件】，这里专门守住
        //---------------------------------------------------------------------
        // 【G 的语义在 2026-10 改过】原来是线性 G/8（×0.125 ~ ×1.875），
        //   现在是【指数】增益 = 2^G（×1 ~ ×256）。
        //   改的原因见 disp_top.v 5b 节的注释（模拟增益不能拉满，要在数字域补）。
        //   ⚠️ 改语义时【必须同时改这里】—— 否则测的是已经不存在的旧行为。
        //
        // ⚠️ 层次引用 dut.wave_adj / dut.wave_sample 【不带 signed 属性】，
        //   iverilog 会按无符号解释。所以下面一律【只看位】：用 bit[23] 判符号，
        //   自己算绝对值。（这条以前栽过，见账本。）
        //---------------------------------------------------------------------
        $display("");
        $display(" [3b] 波形增益（G 命令，指数：增益 = 2^G）");
        begin : gain_test
            integer g, j;
            integer n_err1, n_err2, n_sat, n_sgn;
            reg [23:0] ma, ms;
            reg [31:0] exp_ma;      // 期望幅度（32 位，够放 2^23 * 256）

            // ---- 判据①：G=0 必须【精确】×1（幅度和符号都逐拍相同）----
            wave_gain = 8'd0;
            repeat (3) @(posedge clk_pix);
            n_err1 = 0; n_sgn = 0;
            for (j = 0; j < 8000; j = j + 1) begin
                @(posedge clk_pix);
                if (dut.wave_adj !== dut.wave_sample) n_err1 = n_err1 + 1;
            end
            if (n_err1 != 0) begin
                n_err = n_err + 1;
                $display("  [ERR] G=0 不是精确 ×1（%0d 拍不符）", n_err1);
            end else
                $display("  [ok ] G=0 逐拍精确等于原始采样（8000 次比对）");

            // ---- 判据②：G=1/G=3 的幅度 = 饱和( |sample| << G ) ----
            n_err2 = 0; n_sat = 0;
            for (g = 1; g <= 3; g = g + 1) begin
                wave_gain = g[7:0];
                repeat (3) @(posedge clk_pix);
                for (j = 0; j < 8000; j = j + 1) begin
                    @(posedge clk_pix);
                    ma = dut.wave_adj[23]    ? (~dut.wave_adj[23:0] + 1'b1)
                                             : dut.wave_adj[23:0];
                    ms = dut.wave_sample[23] ? (~dut.wave_sample[23:0] + 1'b1)
                                             : dut.wave_sample[23:0];
                    // 期望：|sample| << G，超过 2^23 就饱和
                    // ⚠️ 饱和上限是【不对称】的：正侧是 2^23-1，负侧是 2^23。
                    //    统写成 8388608 的话，正侧会差 1 —— 报 8290 拍不符，
                    //    看上去像放大器坏了，其实只是参照的常数差一。
                    exp_ma = ms << g;
                    if (dut.wave_sample[23]) begin          // 负采样
                        if (exp_ma > 32'd8388608) begin
                            exp_ma = 32'd8388608; n_sat = n_sat + 1;
                        end
                    end else begin                          // 正采样
                        if (exp_ma > 32'd8388607) begin
                            exp_ma = 32'd8388607; n_sat = n_sat + 1;
                        end
                    end
                    if (ma !== exp_ma[23:0]) n_err2 = n_err2 + 1;
                    // 符号必须和原采样一致（除非原采样正好是 0）
                    if ((ms !== 24'd0) && (dut.wave_adj[23] !== dut.wave_sample[23]))
                        n_sgn = n_sgn + 1;
                end
            end
            if (n_err2 != 0) begin
                n_err = n_err + 1;
                $display("  [ERR] G=1..3 的幅度不等于饱和( |sample| << G )（%0d 拍）", n_err2);
            end else
                $display("  [ok ] G=1/2/3 幅度 == 饱和(|sample| << G)（其中 %0d 拍触到饱和）",
                         n_sat);

            // ---- 判据③：G=8 必须【饱和而不是符号翻转】 ----
            wave_gain = 8'd8;
            repeat (3) @(posedge clk_pix);
            n_err1 = 0;
            for (j = 0; j < 8000; j = j + 1) begin
                @(posedge clk_pix);
                if ((dut.wave_sample[23] !== dut.wave_adj[23]) &&
                    (dut.wave_sample[23:0] !== 24'd0))
                    n_err1 = n_err1 + 1;
            end
            if (n_err1 != 0) begin
                n_err = n_err + 1;
                $display("  [ERR] G=8 出现符号翻转 %0d 拍（饱和逻辑有问题）", n_err1);
            end else
                $display("  [ok ] G=8（×256）只饱和、不符号翻转");
            if (n_sgn != 0) begin
                n_err = n_err + 1;
                $display("  [ERR] 增益过程中符号翻转了 %0d 拍", n_sgn);
            end else
                $display("  [ok ] 各档位符号均与原采样一致");

            wave_gain = 8'd0;      // 还原到新默认
        end

        //---------------------------------------------------------------------
        // 关于"插值器接线"的覆盖说明（这里【故意不测】）
        //---------------------------------------------------------------------
        // 曾经想加一段 [3c]：改 view_en 后读 dut.ui_level，确认三路通道各自
        // 接到了对应视图。但它每改一次都要等一个完整帧（150150 拍 = 12 ms），
        // 三次就把 TB 顶过了 80 ms 超时线，而且【是冗余的】：
        //
        //   · 插值逻辑本身由 tb_ui_anim 单独穷举（单调/上下限/帧门控/反向）；
        //   · 接线是否生效，上面的逐像素比对已经证明了 —— ANIM_STEP 设成 FULL 时
        //     pres 是稳态值（view_en[1] ? 128 : 0），两种取值都参与比对；
        //     当初参考模型写死 pres=128 时报了 36010 处不符，那恰恰说明
        //     pres 真的接到了 polar_map 上。
        //
        // 宁可少一段测试，也不要让 TB 为了重复覆盖而变慢到没人愿意跑。

        // [4] 视图开关抽查：切到"只柱状"，验证极坐标/波形真的被关掉
        //---------------------------------------------------------------------
        $display("");
        $display(" [4] 视图开关抽查（切到 只柱状 = 3'b001）");
        view_en = 3'b001;
        repeat (2500) @(posedge clk_pix);

        // 直接看 disp_mix 内部的组合输出（关掉的视图必须恒为 0）
        if (dut.u_mix.p_lit || dut.u_mix.p_core) begin
            n_err = n_err + 1;
            $display("  [ERR] 极坐标已关，但 p_lit/p_core 仍为 1");
        end else
            $display("  [ok ] 极坐标关掉后 p_lit / p_core 恒为 0");

        if (dut.u_mix.w_line) begin
            n_err = n_err + 1;
            $display("  [ERR] 波形已关，但 w_line 仍为 1");
        end else
            $display("  [ok ] 波形关掉后 w_line 恒为 0（改画中线提示）");

        // b_hit 只对特定像素为 1，不能只看一瞬间，要统计一段时间
        // ⚠️ 一帧是 525x286 = 150150 拍，柱状区在 y>=176。
        //    窗口太短根本扫不到 bar 区 —— 3000 拍只有 5.7 行，差得远。
        bh_cnt = 0;
        for (k = 0; k < 110000; k = k + 1) begin
            @(posedge clk_pix);
            if (dut.u_mix.b_hit) bh_cnt = bh_cnt + 1;
        end
        if (bh_cnt == 0) begin
            n_err = n_err + 1;
            $display("  [ERR] 柱状仍开着，但 110000 拍内 b_hit 一次都没拉高");
        end else
            $display("  [ok ] 柱状仍正常工作（110000 拍内 b_hit 出现 %0d 次）", bh_cnt);

        // 再切回全开，确认能恢复
        view_en = 3'b111;
        repeat (500) @(posedge clk_pix);

        $display("");
        $display("------------------------------------------------------------");
        if (n_err == 0)
            $display(" 结果       : *** PASS ***  130560 像素逐点一致，柱状/极坐标/波形/开关全对");
        else
            $display(" 结果       : *** FAIL ***  共 %0d 处错误", n_err);
        $display("------------------------------------------------------------");
        $finish;
    end

    // 超时保护
    initial begin
        #80_000_000;
        $display(" 结果       : *** FAIL ***  超时");
        $finish;
    end

endmodule
