flyingyuya/Sonic-Speed-Parallelism/(commit log)

2026-09-24 初始提交：音速并行 —— 阶段一完成 + 板级 bring-up 通过
    【工程内容】
    纯 RTL 实时音视频协同处理系统（Artix-7 XC7A100T-2FGG484I），
    不使用 HLS / PYNQ / IP 核。
    rtl/common/ clk_gen（200MHz 差分 -> 48MHz + 12.5MHz）
    cdc_sync / rst_sync
    rtl/audio/ i2s_clkgen / i2s_rx / i2s_tx / audio_fifo
    eq_cascade（5 段双二阶，时分复用）
    eq_coeff_rom（5 段 x 21 档，Python 离线生成）
    audio_top
    rtl/top.v bring-up 顶层
    sim/tb/ 5 个 testbench（含 I2S codec 行为模型）
    scripts/golden/ Python 定点黄金模型（numpy，无 scipy 依赖）
    scripts/sim/ iveri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
2026-09-29 feat: 阶段二小节，除音频模块外，其余模块上板测试无误
2026-09-29 feat: 演示/自检图案 T01~T03 + 修两处上板反馈 bug + Verilator 门禁
    ## 演示/自检图案（P1-4）
    rtl/video/demo_src.v：显示链一直只能靠仿真验证 —— 柱状/极坐标/波形的
    数据只来自真实音频，音频模块不到货就永远是空的，连 S/H/G 三条命令有没有
    生效都判断不了。新增合成图案源，UART 命令 T 切换：
    T00 关（默认，完全旁路） T01 斜坡 T02 棋盘 T03 移动包络
    在 top.v 给频谱和波形各挂一个 2:1 mux，真实模块一行不改。
    ## 修两处上板反馈的 bug（账本 55/56）
    1. 色相速度映射方向反了（H08 反而比 H03 慢）
    H 被当指数用，越大越慢；且 H=0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
    [cmd_proc.v, demo_src.v, disp_top.v, tb_demo_src.v, tb_disp_top.v, tb_top.v, tb_uart_cmd.v, tb_ui_ctrl.v]
2026-09-29 chore: 加 CI、LICENSE、README 顶图
2026-11-02 feat: 完成全部功能 —— 音频链路(5段EQ) / 1024点FFT / 双路显示(LCD+HDMI) / SD卡图片背景 / QSPI固化
    整机特性：
    - 音频：I2S 从模式 + 5 段双二阶均衡 + 双声道 + 静音
    - 分析：1024 点基 2 FFT，单蝶形时分复用（DSP 2048→4，整帧占帧周期 1.3%）
    - 显示：扫描式渲染，一份核心实例化两次驱动 LCD 480x272@12.5MHz 与 HDMI 640x360@25MHz
    - 存储：SD 卡 SPI 初始化 + CMD18 多块读，双帧缓冲（480x272 全图 + 320x180 裁剪）
    - 交互：8 按钮面板 + 8 行状态栏 + UART ASCII 命令通道
    - 固化：QSPI Flash 掉电自启动
    质量指标：
    - 资源：11716 LUT (18.5%) / 100.5 BRAM (74.4%) / 26 DSP48
    -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
2026-11-02 docs: 文档更新
2026-11-02 docs: SD 图片引用改回真实路径 docs/images/sd_card/
2026-11-02 docs: 规范目录结构
2026-11-02 docs: skills 说明文件
2026-11-03 docs: 作品海报
